hs280/chiBioAnalogue/hardware/baseline-digital/PCB Files/Assembly PCBs/LaserMeasure/LaserMeasureAssembly2.jpg

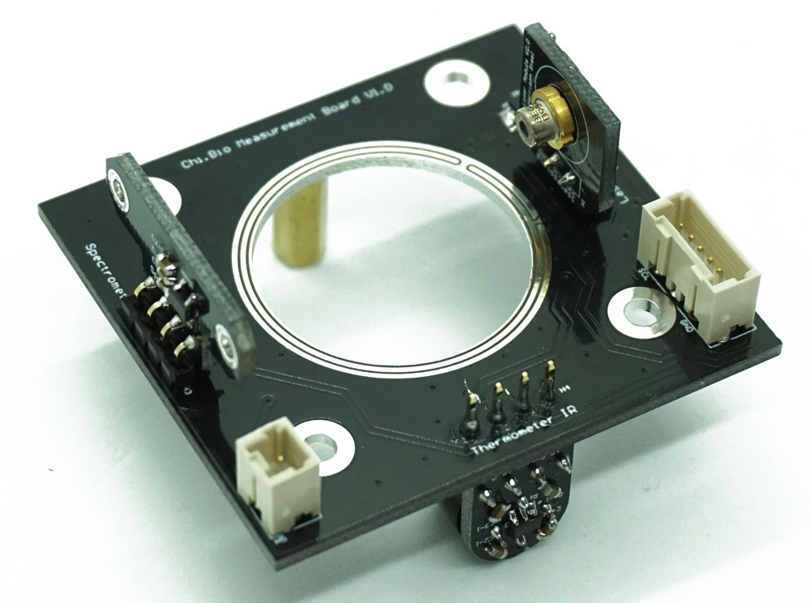
hardware/baseline-digital/PCB Files/Assembly PCBs/LaserMeasure/LaserMeasureAssembly2.jpg
