hs280/chiBioAnalogue/hardware/baseline-digital/PCB Files/Assembly PCBs/Heater3/Heater3Side.jpg

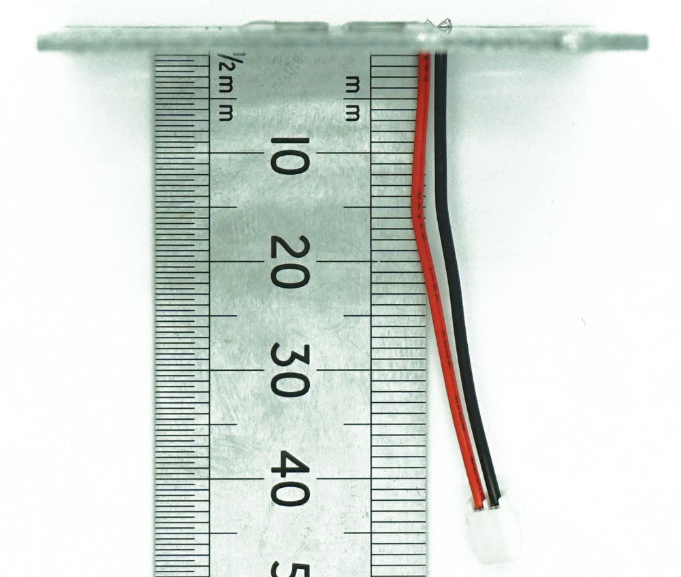
hardware/baseline-digital/PCB Files/Assembly PCBs/Heater3/Heater3Side.jpg
