hs280/chiBioAnalogue/hardware/baseline-digital/PCB Files/Structural PCBs/BraceHorizontal/README.txt

PCB Name: BraceHorizontal
Function: Horizontal brace PCB.
Notes: Central hole must be between 24.7 and 24.9mm in diameter.
Dimensions (max linear, mm): 40 x 40
Layers: 2
Material: FR-4
Copper Thickness (oz): 1
Board Thickness (mm): 1.6
Surface Finish: HASL
Min Track/Spacing (mil): 6/6
Min Hole Size (mm): 0.3
Solder Mask: Black
Silkscreen: White
Assembly Required: No
Board Outline Layer: Mechanical 1
