hs280/chiBioAnalogue/hardware/baseline-digital/PCB Files/Structural PCBs/PumpClamp/README.txt

PCB Name: PumpClamp
Function: Main pump clamp.
Notes: 
Dimensions (max linear, mm): 29.5 x 24
Layers: 2
Material: FR-4
Copper Thickness (oz): 1
Board Thickness (mm): 1.6
Surface Finish: HASL
Min Track/Spacing (mil): 6/6
Min Hole Size (mm): 0.3
Solder Mask: Blue
Silkscreen: White
Assembly Required: No
Board Outline Layer: Mechanical 1
