hs280/chiBioAnalogue/hardware/baseline-digital/PCB Files/Structural PCBs/SensorAperture/README.txt

PCB Name: SensorAperture
Function: Aperture / light blocking PCB for AS7341 sensor.
Notes: 
Dimensions (max linear, mm): 25 x 16
Layers: 2
Material: FR-4
Copper Thickness (oz): 1
Board Thickness (mm): 1.6
Surface Finish: HASL
Min Track/Spacing (mil): 6/6
Min Hole Size (mm): 0.3
Solder Mask: Black
Silkscreen: White
Assembly Required: No
Board Outline Layer: Mechanical 1
