hs280/chiBioAnalogue/hardware/baseline-digital/PCB Files/Structural PCBs/SideA/README.txt

PCB Name: SideAPlain
Function: Structural side panel.
Notes: 
Dimensions (max linear, mm): 51.4 x 115
Layers: 2
Material: FR-4
Copper Thickness (oz): 1
Board Thickness (mm): 1.6
Surface Finish: HASL
Min Track/Spacing (mil): 6/6
Min Hole Size (mm): 0.3
Solder Mask: Black
Silkscreen: White
Assembly Required: No
Board Outline Layer: Mechanical 1
