hs280/chiBioAnalogue/hardware/baseline-digital/PCB Files/Structural PCBs/TubeCap/README.txt

PCB Name: TubeCap
Function: Cap for reaction tube.
Notes: 
Dimensions (max linear, mm): 46 x 46
Layers: 2
Material: FR-4
Copper Thickness (oz): 1
Board Thickness (mm): 1.6
Surface Finish: HASL
Min Track/Spacing (mil): 6/6
Min Hole Size (mm): 0.3
Solder Mask: None
Silkscreen: None
Assembly Required: No
Board Outline Layer: Mechanical 1
