hs280/chiBioAnalogue/hardware/baseline-digital/PCB Files/Structural PCBs/TupeCapMain/README.txt

PCB Name: TubeCapMain
Function: Structure for reaction tube cap.
Notes: 
Dimensions (max linear, mm): 48.2 x 48.2
Layers: 2
Material: FR-4
Copper Thickness (oz): 1
Board Thickness (mm): 1.6
Surface Finish: HASL
Min Track/Spacing (mil): 6/6
Min Hole Size (mm): 0.3
Solder Mask: Black
Silkscreen: None
Assembly Required: No
Board Outline Layer: Mechanical 1
