hs280/chiBioAnalogue/hardware/baseline-digital/PCB List.xlsx

Construct | PCB Name | Quantity | Silkscreen Colour | Solder Mask Colour | PCB Assembly Required
Chi.Bio
 | BasePlate | 1 | White | Black | No
 | BraceHorizontal | 1 | White | Black | No
 | Heater3 | 1 | White | Black | Yes
 | IRSensor | 1 | White | Black | Yes
 | SideA | 1 | White | Black | No
 | SideB | 2 | White | Black | No
 | Side | 1 | White | Black | Yes
 | LaserMeasure | 1 | White | Black | Yes
 | SensorAperture | 1 | None | Black | No
 | SensorBreakoutAS7341 | 1 | White | Black | Yes
 | LaserBreakout | 1 | White | Black | Yes
 | StructHorizontal | 1 | White | Black | Yes
 | TubeCap | 1 | None | None | No
 | TubeCapMain | 1 | None | Black | No
Pump Board
 | Pump | 1 | White | Blue | Yes
 | PumpClamp | 2 | None | Blue | No
 | PumpClampSide | 4 | None | Blue | No
BBB (Control Computer)
 | BeagleBoneBoard | 1 | White | Blue | Yes
