hs280/chiBioAnalogue/hardware/baseline-digital/PCB Files/Structural PCBs/Baseplate/BasePlateBottom.jpg

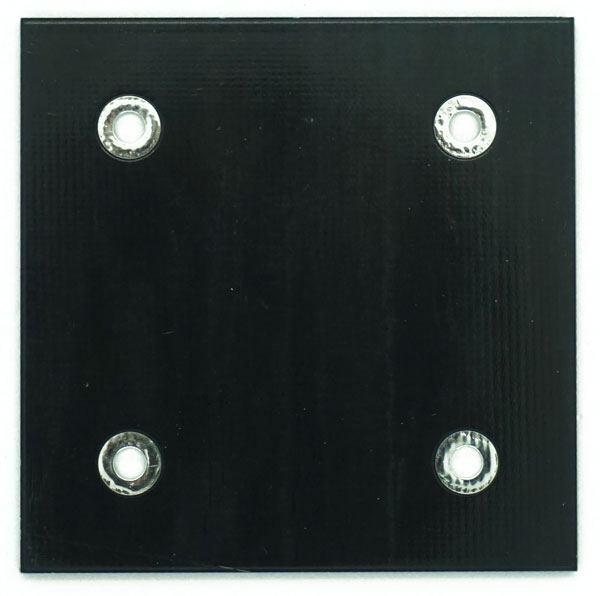
hardware/baseline-digital/PCB Files/Structural PCBs/Baseplate/BasePlateBottom.jpg
