hs280/chiBioAnalogue/hardware/baseline-digital/PCB Files/Structural PCBs/Baseplate/BasePlateTop.jpg

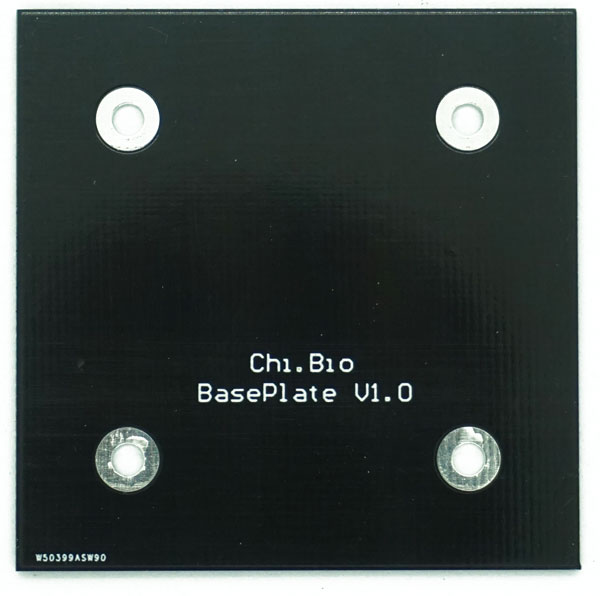
hardware/baseline-digital/PCB Files/Structural PCBs/Baseplate/BasePlateTop.jpg
