hs280/chiBioAnalogue/hardware/baseline-digital/PCB Files/Structural PCBs/BraceHorizontal/BraceHorizontalBottom.jpg

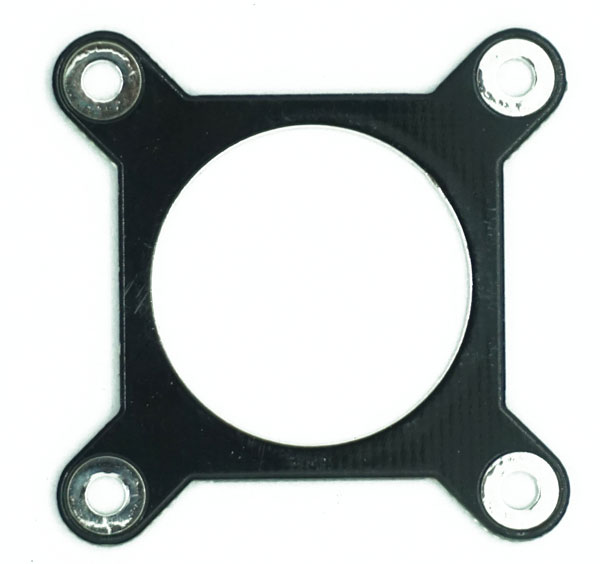
hardware/baseline-digital/PCB Files/Structural PCBs/BraceHorizontal/BraceHorizontalBottom.jpg
