hs280/chiBioAnalogue/hardware/baseline-digital/PCB Files/Structural PCBs/PumpClamp/PumpClampBottom.jpg

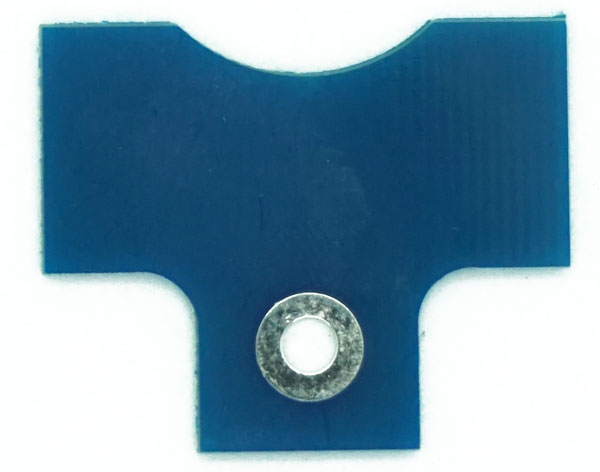
hardware/baseline-digital/PCB Files/Structural PCBs/PumpClamp/PumpClampBottom.jpg
