hs280/chiBioAnalogue/hardware/baseline-digital/PCB Files/Structural PCBs/PumpClamp/PumpClampTop.jpg

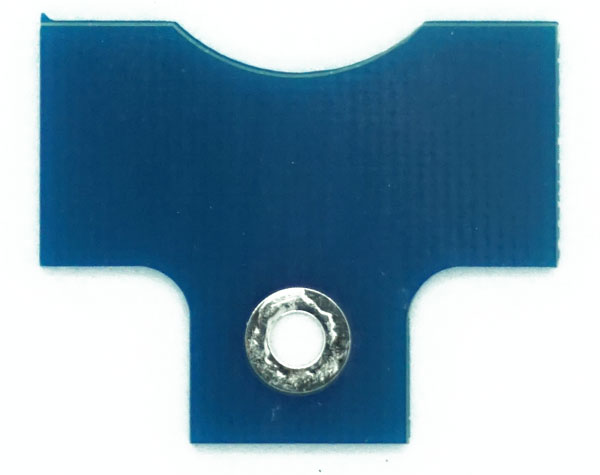
hardware/baseline-digital/PCB Files/Structural PCBs/PumpClamp/PumpClampTop.jpg
