hs280/chiBioAnalogue/hardware/baseline-digital/PCB Files/Structural PCBs/PumpClampSide/PumpClampSideBottom.jpg

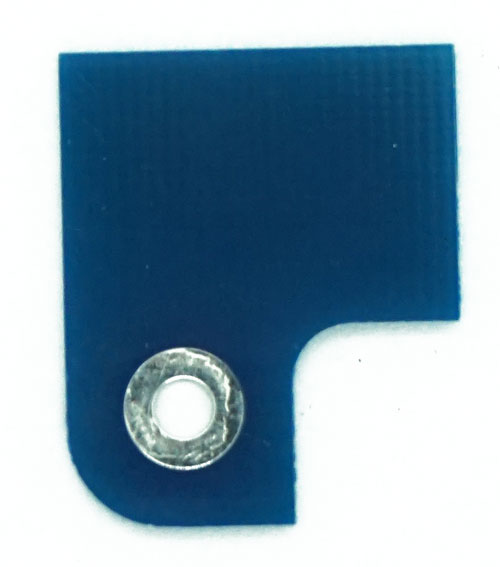
hardware/baseline-digital/PCB Files/Structural PCBs/PumpClampSide/PumpClampSideBottom.jpg
