hs280/chiBioAnalogue/hardware/baseline-digital/PCB Files/Structural PCBs/PumpClampSide/PumpClampSideTop.jpg

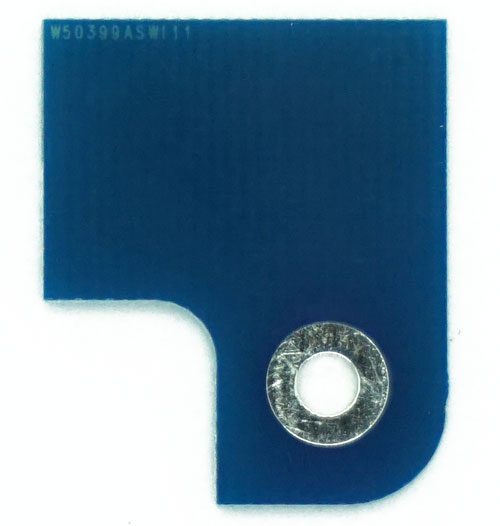
hardware/baseline-digital/PCB Files/Structural PCBs/PumpClampSide/PumpClampSideTop.jpg
