hs280/chiBioAnalogue/hardware/baseline-digital/PCB Files/Structural PCBs/SensorAperture/SensorApertureBottom.jpg

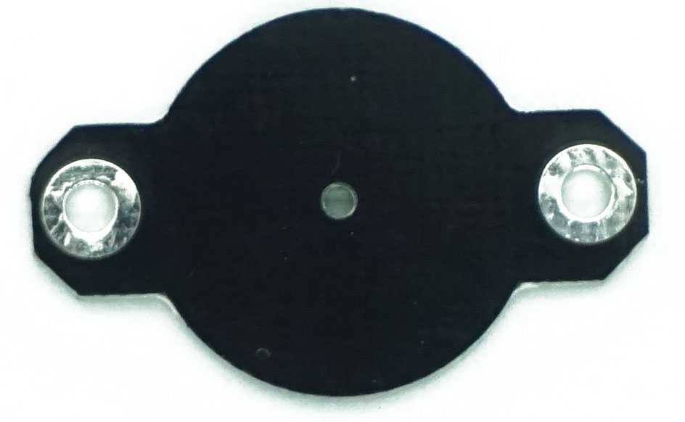
hardware/baseline-digital/PCB Files/Structural PCBs/SensorAperture/SensorApertureBottom.jpg
