hs280/chiBioAnalogue/hardware/baseline-digital/PCB Files/Structural PCBs/SensorAperture/SensorApertureTop.jpg

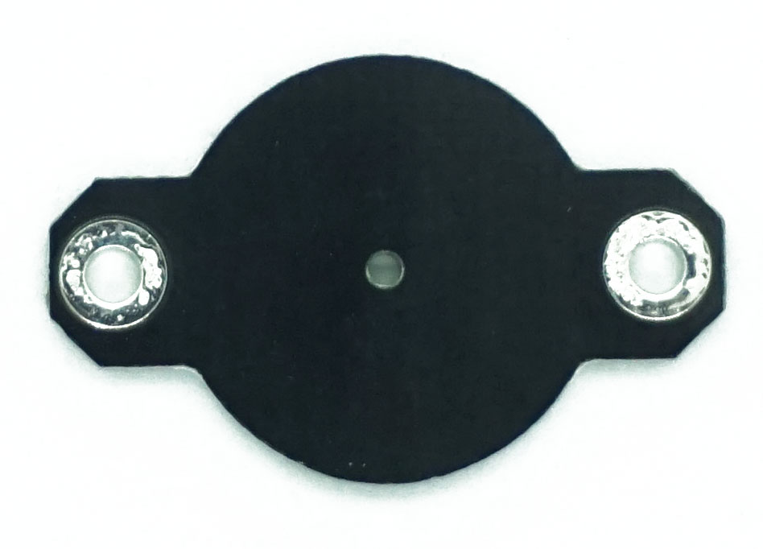
hardware/baseline-digital/PCB Files/Structural PCBs/SensorAperture/SensorApertureTop.jpg
