hs280/chiBioAnalogue/hardware/baseline-digital/PCB Files/Structural PCBs/SideA/SideABottom.jpg

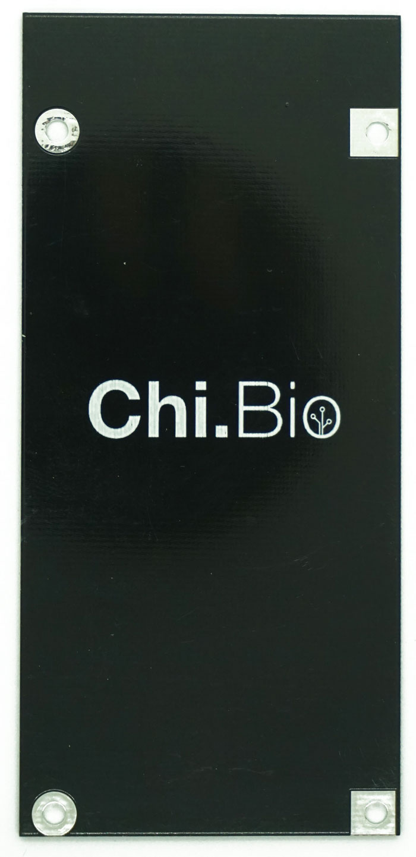
hardware/baseline-digital/PCB Files/Structural PCBs/SideA/SideABottom.jpg
