hs280/chiBioAnalogue/hardware/baseline-digital/PCB Files/Structural PCBs/SideA/SideATop.jpg

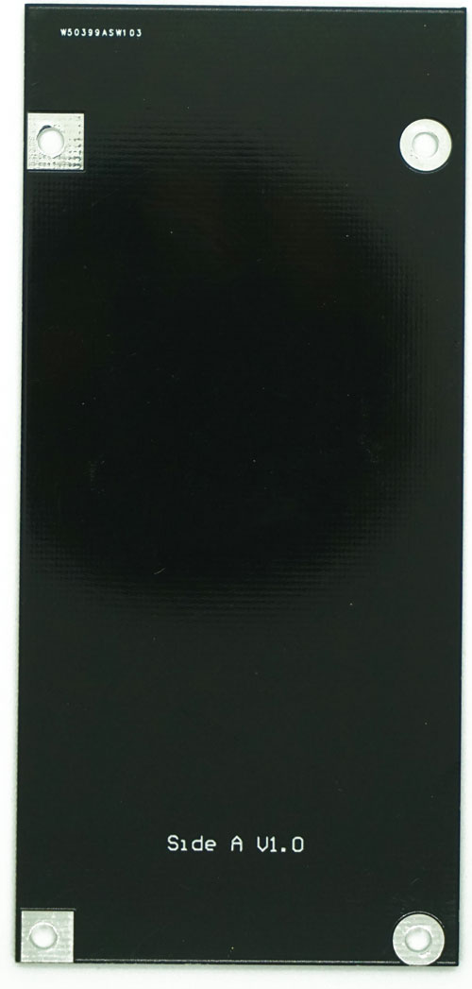
hardware/baseline-digital/PCB Files/Structural PCBs/SideA/SideATop.jpg
