hs280/chiBioAnalogue/hardware/baseline-digital/PCB Files/Structural PCBs/SideB/SideBBottom.jpg

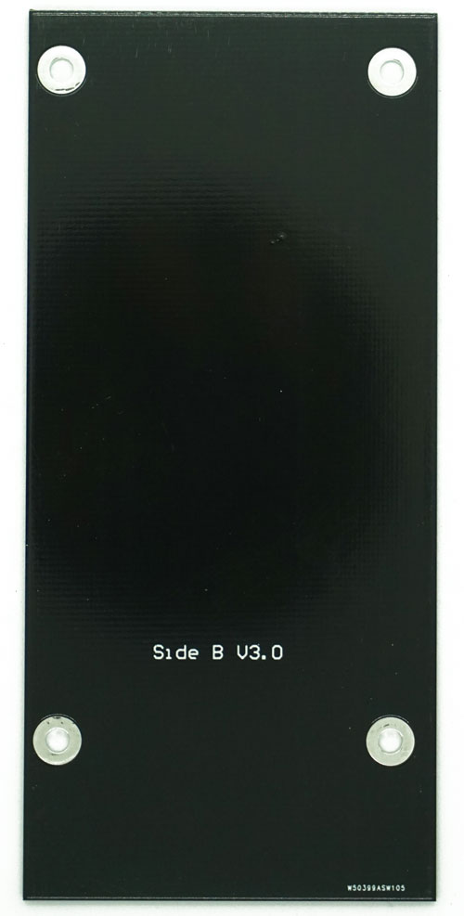
hardware/baseline-digital/PCB Files/Structural PCBs/SideB/SideBBottom.jpg
