hs280/chiBioAnalogue/hardware/baseline-digital/PCB Files/Structural PCBs/SideB/SideBTop.jpg

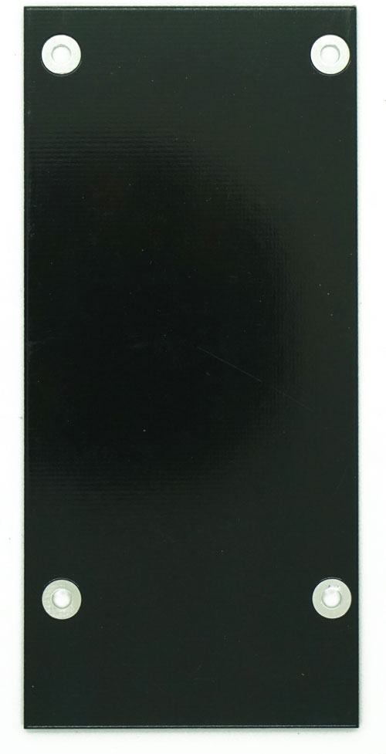
hardware/baseline-digital/PCB Files/Structural PCBs/SideB/SideBTop.jpg
