hs280/chiBioAnalogue/hardware/baseline-digital/PCB Files/Structural PCBs/TubeCap/TubeCapBottom.jpg

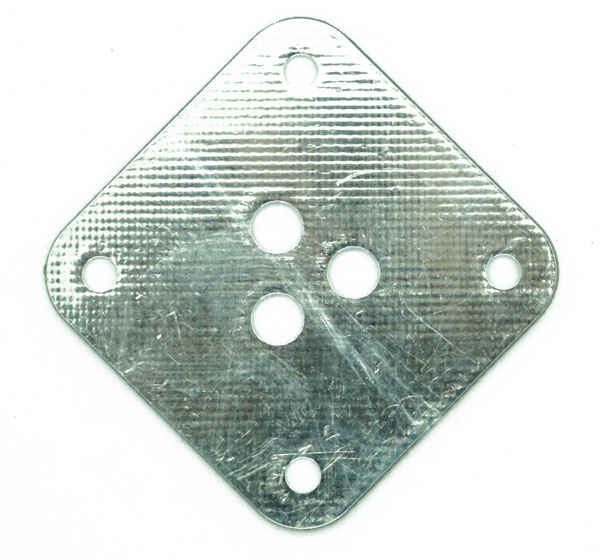
hardware/baseline-digital/PCB Files/Structural PCBs/TubeCap/TubeCapBottom.jpg
