hs280/chiBioAnalogue/hardware/baseline-digital/PCB Files/Structural PCBs/TubeCap/TubeCapTop.jpg

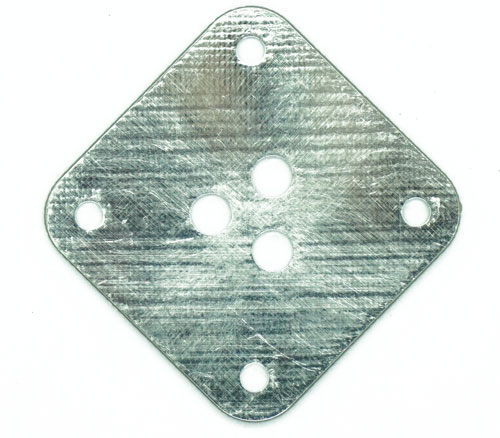
hardware/baseline-digital/PCB Files/Structural PCBs/TubeCap/TubeCapTop.jpg
