hs280/chiBioAnalogue/hardware/baseline-digital/PCB Files/Structural PCBs/TupeCapMain/TubeCapMainBottom.jpg

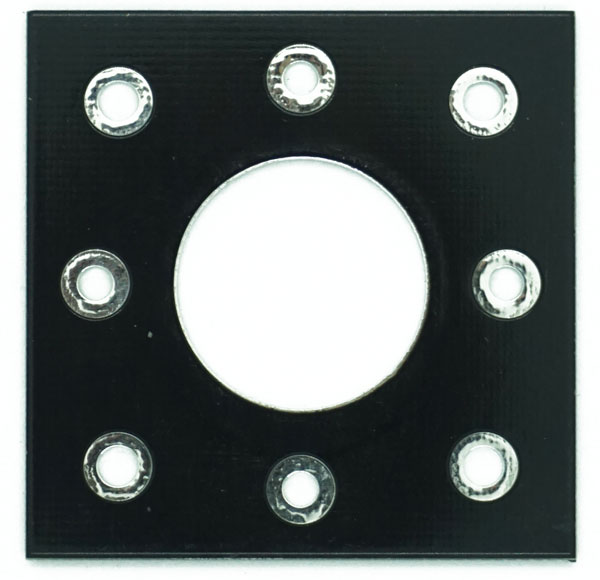
hardware/baseline-digital/PCB Files/Structural PCBs/TupeCapMain/TubeCapMainBottom.jpg
