hs280/chiBioAnalogue/hardware/baseline-digital/PCB Files/Structural PCBs/TupeCapMain/TubeCapMainTop.jpg

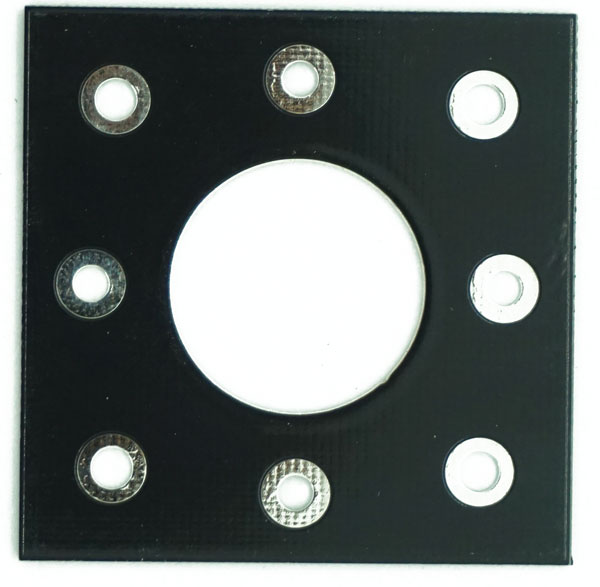
hardware/baseline-digital/PCB Files/Structural PCBs/TupeCapMain/TubeCapMainTop.jpg
