hs280/chiBioAnalogue/hardware/analogue-changes/side_board_bom_delta.csv

Action | Description | Comment | Designator | Qty | Part number | Status
ADD | Octal 12-bit I2C DAC | DAC7578 TSSOP-16, 3.3 V | U-DAC1 | 1 | DAC7578SPW (TI) | VERIFY address table and full-scale; add Digikey number
ADD | Capacitor 0.1uF 0603 | DAC decoupling | C8-1 | 1 | 311-1341-1-ND | Same part as existing 0.1uF
ADD | Capacitor 1uF 0603 | DAC decoupling | C8-2 | 1 | 1276-1019-1-ND | Same part as existing 1uF
REWIRE | LED set-point nets | Move Blue0 Cyan0 Green0 Red0 Yellow0 Lime20 Lime10 and the UV net from PWM1 pins 10 7 11 12 15 17 19 22 to DAC outputs | PWM1 / DAC | 0 | - | No resistor value changes needed
KEEP | PCA9685 (PWM1) | Stays for Stir (pin 6) and Heat (pin 21) | PWM1 | 1 | 568-11925-1-ND | Unchanged
KEEP | All other Side board parts | Unchanged | - | - | - | UV stage is already a CCR with R9 40.2 ohm
