hs280/chiBioAnalogue/hardware/baseline-digital/Additional Materials.xlsx

Sheet: Chi.Bio
Item | Name | Part Number | Quantity | For PCB Assembly? | Source
1 | MicroUSB male-male Cable 50cm | 1778-1019-ND | 2 | No | Digikey
2 | Rubber Feet | 3M156065-ND | 4 | No | Digikey
3 | Fan | P15605-ND | 1 | No | Digikey
4 | Lens | 711-1326-ND | 1 | No | Digikey
5 | Magnet | 469-1061-ND | 2 | No | Digikey
6 | Power Supply (12V 3A) | 1470-3643-ND | 1 | No | Digikey | Alternatives can be used, requirement is 12V 3A supply (36W) minimum.
7 | 2Wire | A100192-ND | 1 | No | Digikey | Used to connect Stirring Fan. Potentially can just add connector to end of fan wire, e.g. Digikey p/n A98653-ND
8 | M3x12mm male-female PCB spacer non-magnetic steel (e.g. A2/A4)/brass |  | 4 | No
9 | M3x10mm male-female PCB spacer |  | 8 | No | https://www.fabory.com/en_GB/spacer-with-internal-thread-and-external-thread-type-h1202-free-cutting-steel-right-zinc-plated-%7c6%7c-m3x10x7/p/11398030010
10 | M3x18mm male-female PCB spacer |  | 4 | No | https://www.fabory.com/en_GB/spacer-with-internal-thread-and-external-thread-type-h1202-free-cutting-steel-right-zinc-plated-%7c6%7c-m3x18x7/p/11398030018
11 | M3x20mm male-female PCB spacer non-magnetic steel (e.g. A2/A4)/brass |  | 4 | No | https://cpc.farnell.com/harwin/r30-3002002/spacers-m3-20mm/dp/PC00102
12 | M3x40mm male-female PCB spacer |  | 4 | No | https://www.fabory.com/en_GB/spacer-with-internal-thread-and-external-threaded-stud-type-h1202-free-cutting-steel-right-zinc-plated-%7c6%7c-m3x40x7/p/11398030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
13 | M3x8mm Screw |  | 4 | No | https://www.fabory.com/en_GB/cross-recessed-raised-cheese-head-screw-phillips-din-7985-h-steel-zinc-plated-black-passivated-4-8-m3x8/p/24810030008
14 | M3x12mm Screw non-magnetic steel (e.g. A2/A4) |  | 4 | No | https://www.fabory.com/en_GB/cross-recessed-raised-cheese-head-screw-pozidriv-din-7985-z-stainless-steel-a2-m3x12/p/51342030012
15 | M3x55mm Screw non-magnetic steel (e.g. A2/A4) |  | 8 | No | https://www.fabory.com/en_GB/cross-recessed-raised-cheese-head-screw-pozidriv-din-7985-z-stainless-steel-a2-m3x55/p/51342030055
16 | M3 Washer non-magnetic steel (e.g. A2/A4)/brass/nylon |  | 8 | No | https://www.fabory.com/en_GB/plain-washer-din-125-1a-stainless-steel-a2-m3/p/51420030001
17 | M3 Nut |  | 12 | No | https://www.fabory.com/en_GB/hexagon-nut-din-934-stainless-steel-a2-right-70-m3/p/51080030001
18 | M2x8mm Screw |  | 2 | No | https://www.fabory.com/en_GB/cross-recessed-raised-cheese-head-screw-pozidriv-din-7985-z-stainless-steel-a4-m2x8/p/55342020008
19 | M2 Nut |  | 4 | No | https://www.fabory.com/en_GB/hexagon-nut-din-934-stainless-steel-a2-right-70-m2/p/51080020001
20 | M2 Washer |  | 2 | No | https://www.fabory.com/en_GB/plain-washer-din-125-1a-steel-140hv-zinc-plated-m2/p/38130020001
21 | M16 Rubber Washer (3mm thickness) | W0214 | 1 | No | http://www.rubberwashers.co.uk/M16_Rubber_Washers

Sheet: Pump Board
Item | Name | Part Number | Quantity | For PCB Assembly? | Source
1 | Pump |  | 4 | No | https://www.aliexpress.com/item/10Pcs-lot-For-Aquarium-Lab-Analytical-Water-6V-DC-DIY-Dosing-pump-Peristaltic-Dosing-Head-Free/32649797935.html
2 | M3x8mm Screw |  | 2 | No | https://www.fabory.com/en_GB/cross-recessed-raised-cheese-head-screw-phillips-din-7985-h-steel-zinc-plated-black-passivated-4-8-m3x8/p/24810030008
3 | M3x50mm male-female PCB spacer |  | 4 | No | https://www.fabory.com/en_GB/spacer-with-internal-thread-and-external-thread-type-h1202-free-cutting-steel-right-zinc-plated-%7c6%7c-m3x50x7/p/11398030050
4 | M3 Nut |  | 6 | No | https://www.fabory.com/en_GB/hexagon-nut-din-934-stainless-steel-a2-right-70-m3/p/51080030001
5 | 2Wire | A100192-ND | 4 | No | Digikey

Sheet: BBB
Item | Name | Part Number | Quantity | For PCB Assembly | Source
1 | Rubber Feet | 36-720-ND | 4 | No | Digikey
2 | Beaglebone Black | BBB01-SC-505-ND | 1 | No | Digikey
3 | M3x25mm Screw |  | 4 | No | https://www.fabory.com/en_GB/slotted-cheese-head-screw-din-84-stainless-steel-a4-m3x25/p/55120030025
4 | M3 Nut |  | 12 | No | https://www.fabory.com/en_GB/hexagon-nut-din-934-stainless-steel-a2-right-70-m3/p/51080030001
