hs280/chiBioAnalogue/hardware/baseline-digital/PCB Files/Assembly PCBs/BBB/BOM/Bill of Materials-BeagleBoneBoard.xlsx

Description | Comment | Designator | Digikey P/N | FP | Quantity
Capacitor | 10 uF | C1-1 | 587-1295-1-ND | 0805 (2012 Metric) | 1
D-Latch | DLatch | DL1 | NC7SZ175P6XCT-ND | 6-TSSOP | 1
I2C Multiplexer | i2cMultiplexer | Mult1 | 296-34905-1-ND | 24-TSSOP | 1
Beaglebone Header | 46PinHeader | P8, P9 | S2012EC-23-ND | 46 Pin Header | 2
Resistor | 10K | R1-1, R1-2, R1-3 | 311-10.0KHRCT-ND | 0603 (1608 Metric) | 3
Resistor | 2.2K | R2-1, R2-2 | 311-2.20KHRCT-ND | 0603 (1608 Metric) | 2
Resistor | 1.5K | R3-1, R3-2, R3-3, R3-4, R3-5, R3-6, R3-7, R3-8, R3-9, R3-10, R3-11, R3-12, R3-13, R3-14, R3-15, R3-16 | 311-1.50KHRCT-ND | 0603 (1608 Metric) | 16
PowerSwitch | Sw1 | Sw1 | 296-34970-1-ND | TSOT-23-6 | 1
MicroUSB Connector | Control Board MicroUSB | T0, T1, T2, T3, T4, T5, T6, T7 | WM10134CT-ND | MicroUSB Female | 8
Thermometer | TempSense | Thermometer | MCP9808T-E/MSCT-ND | 8-MSOP | 1
Watchdog | Watchdog | WD1 | 497-10058-1-ND | SOT-23-5 | 1
