hs280/chiBioAnalogue/hardware/baseline-digital/PCB Files/Assembly PCBs/Heater3/BOM/Bill of Materials-Heater3.xlsx

Description | Comment | Designator | Digikey P/N | FP | Quantity
2 Wire | Interconnect 1 | Heat1 | A100192-ND | Connecting Wire | 1
Resistor | Heat | R1-1, R1-2, R1-3, R1-4 | A130709CT-ND | 2512 (6432 Metric) | 4
