hs280/chiBioAnalogue/hardware/baseline-digital/PCB Files/Assembly PCBs/IRSensor/BOM/Bill of Materials-IRSensor.xlsx

Description | Comment | Designator | Digikey P/N | FP | Quantity
Capacitor | 1uF | C1-1 | 1276-1019-1-ND | 0603 (1608 Metric) | 1
Capacitor | 4.7uF | C2-1 | 1276-1044-1-ND | 0603 (1608 Metric) | 1
Capacitor | 0.01uF | C3-1 | 445-5662-1-ND | 0603 (1608 Metric) | 1
Capacitor | 0.1 uF | C4-1 | 311-1341-1-ND | 0603 (1608 Metric) | 1
Header Pins | IRConnect | H1 | 732-5337-ND | 4-Header Pins | 1
IR Thermometer | IR1 | IR1 | MLX90614ESF-DCC-000-TU-ND | TO-39 | 1
3 Regulator | 3V Regulator | Reg1 | LP2985AIM5-3.0/NOPBCT-ND | SOT-23-5 | 1
