hs280/chiBioAnalogue/hardware/baseline-digital/PCB Files/Assembly PCBs/LaserBreakout/BOM/Bill of Materials-LaserBreakout.xlsx

Description | Comment | Designator | Digikey P/N | FP | Quantity
Capacitor | 1nf | C1 | 478-1215-1-ND | 0603 (1608 Metric) | 1
Header Pins | LightConnect | H1 | 732-5338-ND | 3-Header Pins | 1
ADL65052TL | LaserLEDCombo | L1 |  | TO-18 | 1
OpAmp | Op Amp - Precision | OA1 | 296-45326-1-ND | SOT-23-5 | 1
Resistor | 10K | R1-1 | 311-10.0KHRCT-ND | 0603 (1608 Metric) | 1
Resistor | 51 | R2-1 | RHM51.0ADCT-ND | 0603 (1608 Metric) | 1
Resistor | 20K | R3-1 | 311-20.0KHRCT-ND | 0603 (1608 Metric) | 1
Resistor | 2M | R4-1 | 311-2.00MHRCT-ND | 0603 (1608 Metric) | 1
Transistor | TransistorPower | TR1 | MMBT4401LT1GOSCT-ND | SOT-23-3 | 1
