hs280/chiBioAnalogue/hardware/baseline-digital/PCB Files/Assembly PCBs/LaserMeasure/BOM/Bill of Materials-Laser Measure.xlsx

Description | Comment | Designator | Digikey P/N | FP | Quantity
Capacitor | 1uF | C1-1 | 1276-1019-1-ND | 0603 (1608 Metric) | 1
Capacitor | 4.7uF | C2-1 | 1276-1044-1-ND | 0603 (1608 Metric) | 1
Capacitor | 0.01uF | C3-1 | 445-5662-1-ND | 0603 (1608 Metric) | 1
DAC | Dac | DAC1 | 296-48525-1-ND | SOT-23-6 | 1
Side Connector | Interconnect | H1 | A98685-ND | Mini CT 6POS | 1
Laser Beakout | LaserBreakout | H2 |  |  | 1
Spectrometer Breakout | SensorBreakoutAS7341 | H3 |  |  | 1
IR Thermometer Breakout | IRSensor | H4 |  |  | 1
Overflow Connector | OverFlow1 | H5 | A98681-ND | Mini CT 2POS | 1
Resistor | 10k | R1-1 | 311-10.0KHRCT-ND | 0603 (1608 Metric) | 1
5V Regulator | 5V Regulator | Reg1 | LP2985IM5X-5.0/NOPBCT-ND | SOT-23-5 | 1
Thermometer | TempSense | T1 | MCP9808T-E/MSCT-ND | 8-MSOP | 1
