hs280/chiBioAnalogue/hardware/baseline-digital/PCB Files/Assembly PCBs/Pump/BOM/Bill of Materials-Pump.xlsx

Description | Comment | Designator | Digikey P/N | FP | Quantity
Capacitor | 2.2 uF | C1-1, C1-2 | 1276-6458-1-ND | 0805 (2012 Metric) | 2
Capacitor | 22 uF | C2-1, C2-2 | 1276-6780-1-ND | 0805 (2012 Metric) | 2
Capacitor | 0.1 uF | C3-1, C3-2 | 311-1341-1-ND | 0603 (1608 Metric) | 2
Capacitor | 1uF | C4-1 | 1276-1019-1-ND | 0603 (1608 Metric) | 1
Capacitor | 4.7uF | C5-1 | 1276-1044-1-ND | 0603 (1608 Metric) | 1
Capacitor | 0.01uF | C6-1 | 445-5662-1-ND | 0603 (1608 Metric) | 1
MicroUSB Connector | MicroUSB Side | H1 | 609-4618-1-ND | MicroUSB Side | 1
2 Position Connector | Interconnect 2 | H2, H3, H4, H5 | A98681-ND | Mini CT 2POS | 4
Motor Driver | MotorDriver2 | MD1-1, MD1-2 | 296-38514-5-ND | 16-HTSSOP | 2
Pump Assembly | PO1 | PO1, PO2, PO3, PO4 |  |  | 4
PWM | PWM28 | PWM1 | 568-11925-1-ND | 28-TSSOP | 1
Resistor | 10k | R1-1, R1-2 | 311-10.0KHRCT-ND | 0603 (1608 Metric) | 2
3.3V Regulator | 3.3V Regulator | Reg1 | 296-18476-1-ND | SOT-23-5 | 1
