hs280/chiBioAnalogue/hardware/baseline-digital/PCB Files/Assembly PCBs/SensorBreakoutAS7341/BOM/Bill of Materials-SensorBreakoutAS7341.xlsx

Description | Comment | Designator | Digikey P/N | FP | Quantity
Spectrometer | AS7341 | AS7341 | AS7341-DLGMCT-ND | 8-TFLGA | 1
Capacitor | 1uF | C1-1 | 1276-1019-1-ND | 0603 (1608 Metric) | 1
Capacitor | 4.7uF | C2-1 | 1276-1044-1-ND | 0603 (1608 Metric) | 1
Capacitor | 0.01uF | C3-1 | 445-5662-1-ND | 0603 (1608 Metric) | 1
Header Pins | ColourConnect2 | H1 | 732-5337-ND | 4-Header Pins | 1
1.8V Regulator | 1.8V Regulator | Reg1 | LP2985AIM5-1.8/NOPBCT-ND | SOT-23-5 | 1
