hs280/chiBioAnalogue/hardware/baseline-digital/PCB Files/Assembly PCBs/Side/BOM/Bill of Materials-Side.xlsx

Description | Comment | Designator | Digikey P/N | FP | Quantity
Buffer | B1 | B1 | 296-47829-1-ND | VSSOP-8 | 1
Capacitor | 1 uF | C1-1, C1-2 | 1276-1019-1-ND | 0603 (1608 Metric) | 2
Capacitor | 10 uF | C2-1, C2-2 | 587-1295-1-ND | 0805 (2012 Metric) | 2
Capacitor | 22 uF | C3-1, C3-2 | 1276-6780-1-ND | 0805 (2012 Metric) | 2
Capacitor | 0.1 uF | C4-1, C4-2, C4-3, C4-4 | 311-1341-1-ND | 0603 (1608 Metric) | 4
Capacitor | 4.7uF | C5-1 | 1276-1044-1-ND | 0603 (1608 Metric) | 1
Capacitor | 0.01uF | C6-1, C6-2 | 445-5662-1-ND | 0603 (1608 Metric) | 2
Capacitor C0G,NP0 | 22pF | C7-1 | 311-1755-1-ND | 0603 (1608 Metric) | 1
Diode | D1 | D1-1 | 1655-1928-1-ND | SOD-123 | 1
Power Connector | Power (12V 3A) | H1 | CP-044AH-ND | PWR Jack | 1
MicroUSB Connector | Control | H2 | WM10134CT-ND | MicroUSB Female | 1
2 Position Connector | Heat | H3 | A98681-ND | Mini CT 2POS | 1
2 Position Connector | Stir | H4 | A98681-ND | Mini CT 2POS | 1
MicroUSB Connector | Pump | H5 | WM10134CT-ND | MicroUSB Female | 1
6 Wire | Measurement | H6 | A100196-ND | Connecting Wire | 1
5 Position Connector | Expansion | H7 | A98684-ND | Mini CT 5POS | 1
Inductor | 3.3uH | I1-1 | 445-4119-1-ND | Wirewound Inductor | 1
LED Visible | LEDEngin | LED1 | 1537-1183-1-ND | 2828 (7070 Metric) | 1
LED UV | LED UV | LED2 | 1807-1023-2-ND | XR SMD | 1
OpAmp | OpAmp 4Way | OA1-1, OA1-2 | AD8534ARZ-REELCT-ND | 14-SOIC | 2
PWM | PWM28 | PWM1 | 568-11925-1-ND | 28-TSSOP | 1
Resistor | 10k | R1-4, R1-5, R1-6, R1-7, R1-8, R1-9, R1-10, R1-11, R1-12, R1-13, R1-14, R1-15, R1-16, R1-17, R1-18, R1-19, R1-20, R1-21, R1-22, R1-23 | 311-10.0KHRCT-ND | 0603 (1608 Metric) | 20
Resistor | 38.3k | R2-1, R2-2, R2-3, R2-4, R2-5, R2-6, R2-7, R2-8, R2-9 | 311-38.3KHRCT-ND | 0603 (1608 Metric) | 9
Resistor | 1 | R3-1, R3-2, R3-3, R3-4, R3-5, R3-6, R3-7 | A109718CT-ND | 2512 (6432 Metric) | 7
Resistor | 1M | R4-1, R4-2, R4-3, R4-4, R4-5, R4-6, R4-7, R4-8 | RMCF0603FG1M00CT-ND | 0603 (1608 Metric) | 8
Resistor | 4.99 | R5-1, R5-2 | 311-4.99HRCT-ND | 0603 (1608 Metric) | 2
Resistor | 152k | R6-1 | 311-2096-1-ND | 0603 (1608 Metric) | 1
Resistor | 22.1k | R7-1 | 311-2486-1-ND | 0603 (1608 Metric) | 1
Resistor | 40.2 | R9-1 | P16072CT-ND | 0805 (2012 Metric) | 1
3.3V Regulator | 3.3V Regulator | Reg1 | 296-18476-1-ND | SOT-23-5 | 1
6V Regulator | 6V Regulator | Reg2 | 296-30033-1-ND | 8-SOIC | 1
Transistor | MOSFET | TR1-1, TR1-2 | 785-1014-1-ND | SOT-23-3 | 2
Transistor | TransistorPower2 | TR2-1, TR2-2, TR2-3, TR2-4, TR2-5, TR2-6, TR2-7, TR2-8 | ZXTN25100DGCT-ND | SOT-223 | 8
