hs280/chiBioAnalogue/hardware/baseline-digital/PCB Files/Assembly PCBs/StructHorizontal/BOM/Bill of Materials-StructHorizontal.xlsx

Description | Comment | Designator | Digikey P/N | FP | Quantity
2 Wire | Interconnect 1 | Overflow | A100192-ND | Connecting Wire | 1
