hs280/chiBioAnalogue/hardware/baseline-digital/PCB Files/Assembly PCBs/BBB/README.txt

PCB Name: BeagleBoneBoard
Function: Cape which attaches to a Beaglebone Black control computers to multiplex Chi.Bio
Notes: Some resistor names/values have been updated since images of this PCB were taken.
Dimensions (max linear, mm): 86.8 x 55.0
Layers: 2
Material: FR-4
Copper Thickness (oz): 1
Board Thickness (mm): 1.6
Surface Finish: HASL
Min Track/Spacing (mil): 6/6
Min Hole Size (mm): 0.3
Solder Mask: Blue
Silkscreen: White
Assembly Required: Yes
Board Outline Layer: Mechanical 1
