hs280/chiBioAnalogue/hardware/baseline-digital/PCB Files/Assembly PCBs/Heater3/README.txt

PCB Name: Heater3
Function: Heat plate.
Notes: 
Dimensions (max linear, mm): 49.8 x 49.8
Layers: 2
Material: FR-4
Copper Thickness (oz): 1
Board Thickness (mm): 1.6
Surface Finish: HASL
Min Track/Spacing (mil): 6/6
Min Hole Size (mm): 0.3
Solder Mask: Black
Silkscreen: White
Assembly Required: Yes
Board Outline Layer: Mechanical 1
