hs280/chiBioAnalogue/hardware/baseline-digital/PCB Files/Assembly PCBs/IRSensor/README.txt

PCB Name: IRSensor
Function: Infra-red temperature sensor.
Notes: 
Dimensions (max linear, mm): 10.2 x 13.8
Layers: 2
Material: FR-4
Copper Thickness (oz): 1
Board Thickness (mm): 1.6
Surface Finish: HASL
Min Track/Spacing (mil): 6/6
Min Hole Size (mm): 0.3
Solder Mask: Black
Silkscreen: White
Assembly Required: Yes
Board Outline Layer: Mechanical 1
