hs280/chiBioAnalogue/hardware/baseline-digital/PCB Files/Assembly PCBs/LaserBreakout/README.txt

PCB Name: LaserBreakout
Function: Laser diode with optical power regulation driving circuitry.
Notes: 
Dimensions (max linear, mm): 14 x 13.5
Layers: 2
Material: FR-4
Copper Thickness (oz): 1
Board Thickness (mm): 1.6
Surface Finish: HASL
Min Track/Spacing (mil): 6/6
Min Hole Size (mm): 0.3
Solder Mask: Black
Silkscreen: White
Assembly Required: Yes
Board Outline Layer: Mechanical 1
