hs280/chiBioAnalogue/hardware/baseline-digital/PCB Files/Assembly PCBs/Pump/README.txt

PCB Name: Pump
Function: Pump control board, which drives up to 4 peristaltic pumps.
Notes: 
Dimensions (max linear, mm): 150.5 x 100
Layers: 2
Material: FR-4
Copper Thickness (oz): 1
Board Thickness (mm): 1.6
Surface Finish: HASL
Min Track/Spacing (mil): 6/6
Min Hole Size (mm): 0.3
Solder Mask: Blue
Silkscreen: White
Assembly Required: Yes
Board Outline Layer: Mechanical 1
