hs280/chiBioAnalogue/hardware/baseline-digital/PCB Files/Assembly PCBs/SensorBreakoutAS7341/README.txt

PCB Name: SensorBreakoutAS7341
Function: AS7341 chip spectrometer and voltage regulator.
Notes: 
Dimensions (max linear, mm): 25 x 12.5
Layers: 2
Material: FR-4
Copper Thickness (oz): 1
Board Thickness (mm): 1.6
Surface Finish: HASL
Min Track/Spacing (mil): 6/6
Min Hole Size (mm): 0.3
Solder Mask: Black
Silkscreen: White
Assembly Required: Yes
Board Outline Layer: Mechanical 1
