hs280/chiBioAnalogue/hardware/baseline-digital/PCB Files/Assembly PCBs/BBB/BeagleBoneBoardAssembly1.jpg

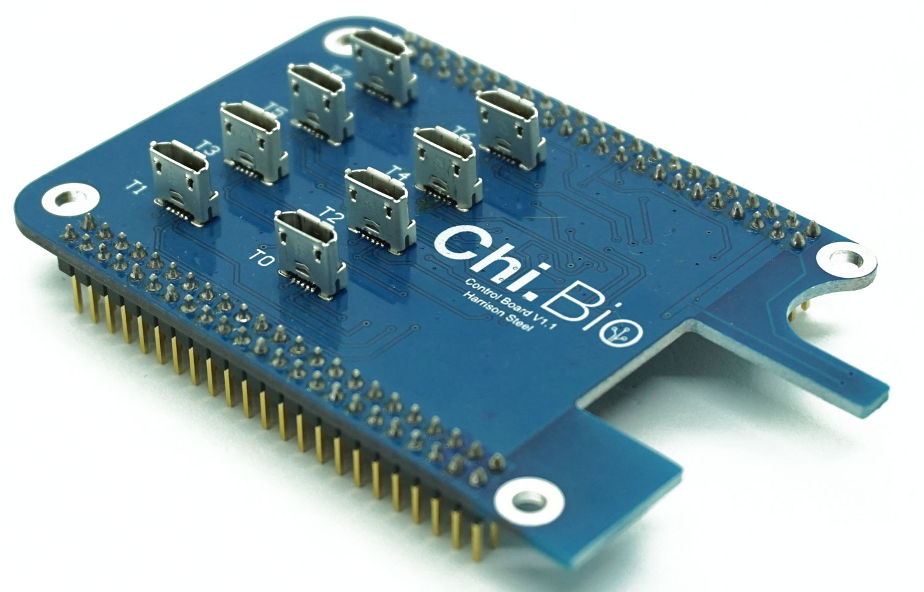
hardware/baseline-digital/PCB Files/Assembly PCBs/BBB/BeagleBoneBoardAssembly1.jpg
