hs280/chiBioAnalogue/hardware/baseline-digital/PCB Files/Assembly PCBs/BBB/BeagleBoneBoardBottom.jpg

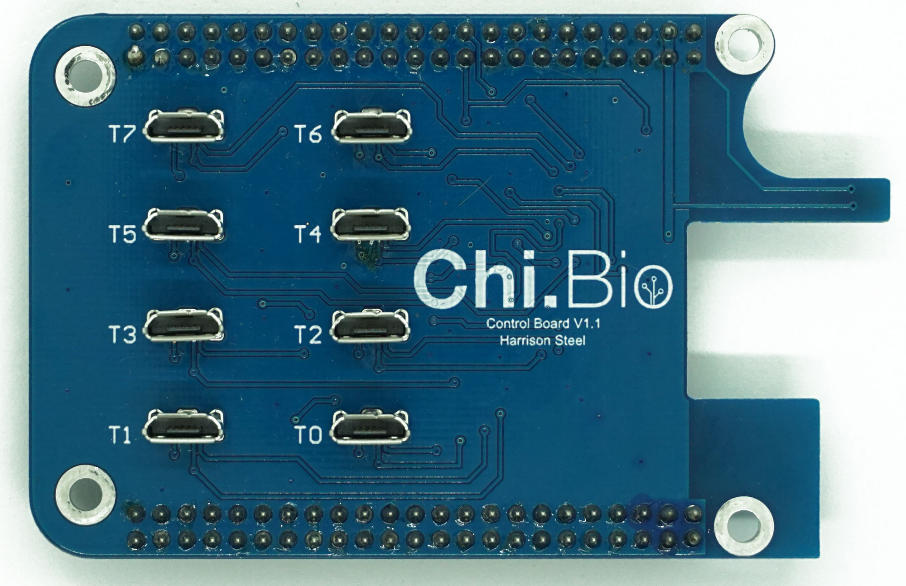
hardware/baseline-digital/PCB Files/Assembly PCBs/BBB/BeagleBoneBoardBottom.jpg
