hs280/chiBioAnalogue/hardware/baseline-digital/PCB Files/Assembly PCBs/BBB/BeagleBoneBoardTop.jpg

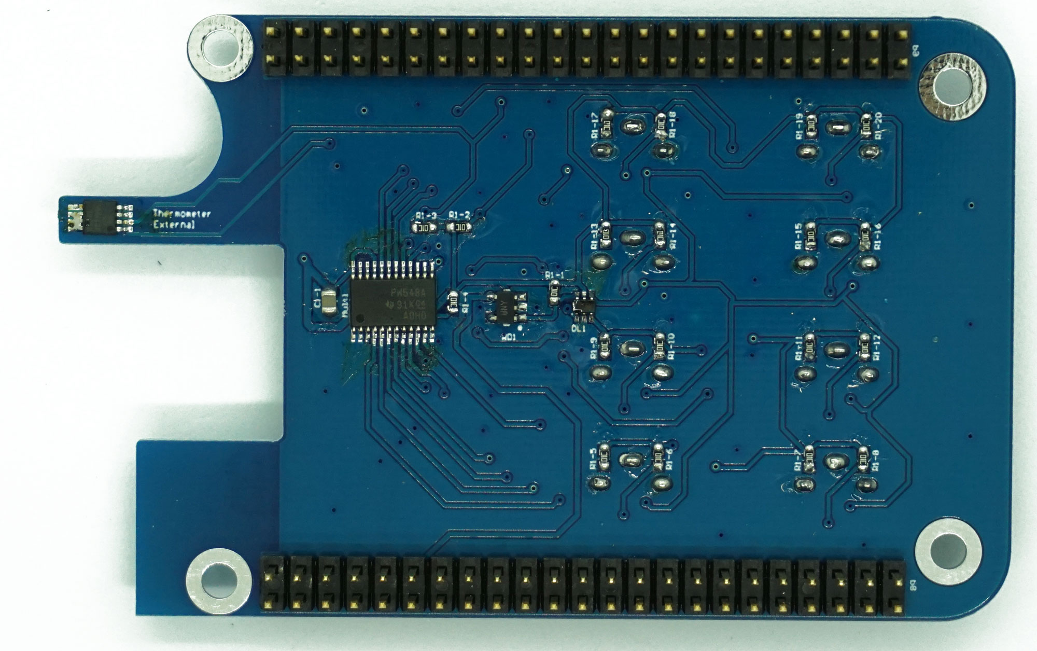
hardware/baseline-digital/PCB Files/Assembly PCBs/BBB/BeagleBoneBoardTop.jpg
