hs280/chiBioAnalogue/hardware/baseline-digital/PCB Files/Assembly PCBs/Heater3/Heater3Bottom.jpg

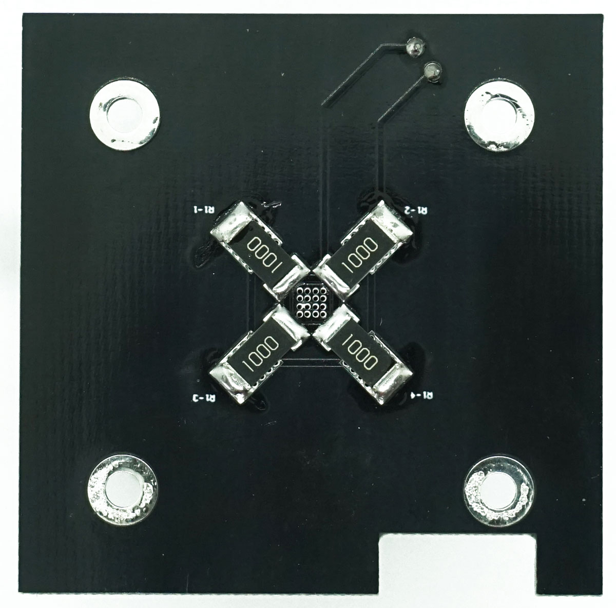
hardware/baseline-digital/PCB Files/Assembly PCBs/Heater3/Heater3Bottom.jpg
