hs280/chiBioAnalogue/hardware/baseline-digital/PCB Files/Assembly PCBs/Heater3/Heater3Top.jpg

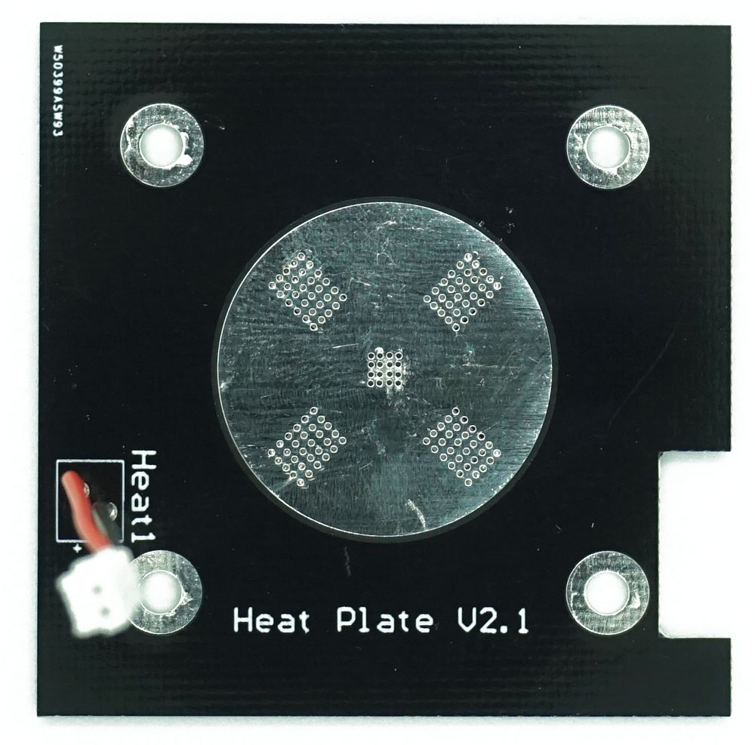
hardware/baseline-digital/PCB Files/Assembly PCBs/Heater3/Heater3Top.jpg
