hs280/chiBioAnalogue/hardware/baseline-digital/PCB Files/Assembly PCBs/IRSensor/IRSensorBottom.jpg

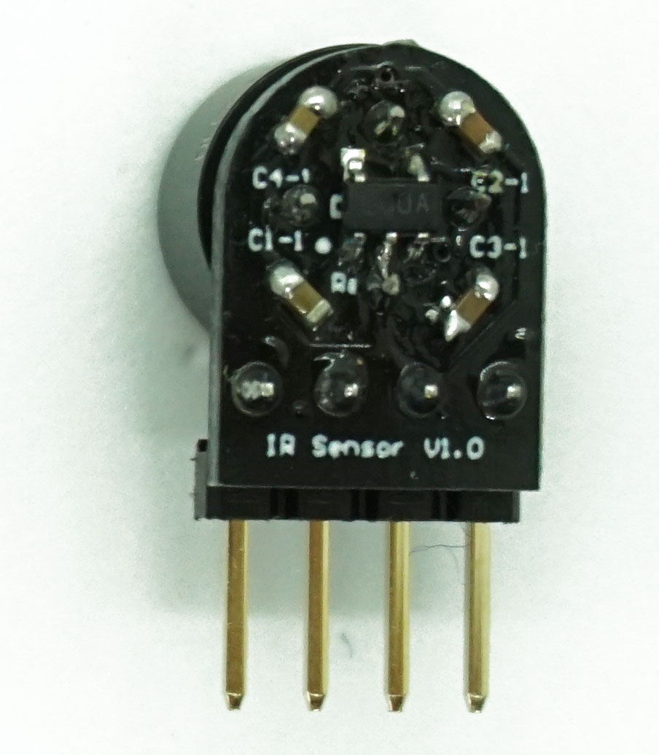
hardware/baseline-digital/PCB Files/Assembly PCBs/IRSensor/IRSensorBottom.jpg
