hs280/chiBioAnalogue/hardware/baseline-digital/PCB Files/Assembly PCBs/IRSensor/IRSensorSide.jpg

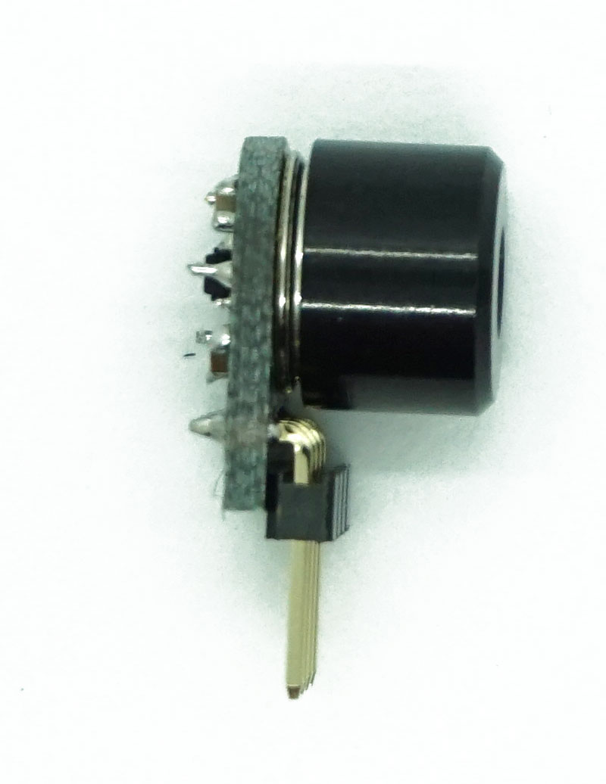
hardware/baseline-digital/PCB Files/Assembly PCBs/IRSensor/IRSensorSide.jpg
