hs280/chiBioAnalogue/hardware/baseline-digital/PCB Files/Assembly PCBs/IRSensor/IRSensorTop2.jpg

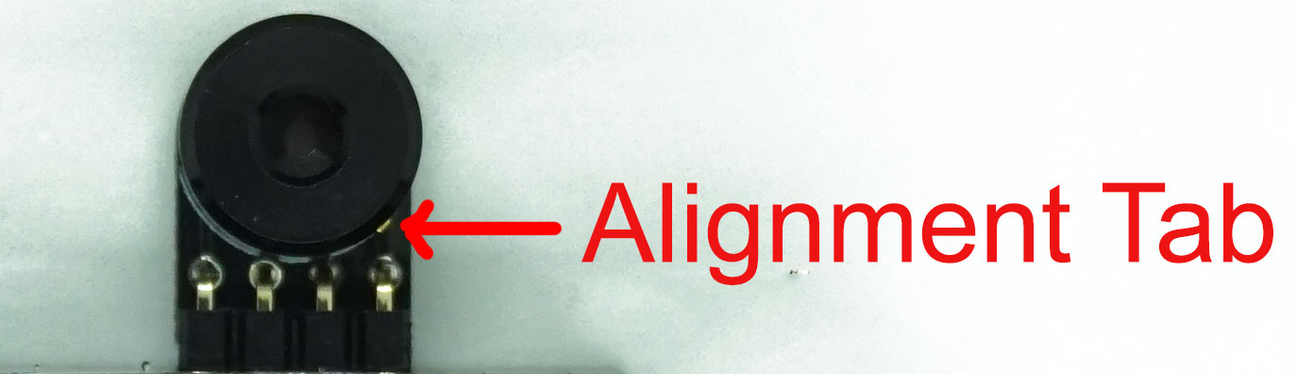
hardware/baseline-digital/PCB Files/Assembly PCBs/IRSensor/IRSensorTop2.jpg
