hs280/chiBioAnalogue/hardware/baseline-digital/PCB Files/Assembly PCBs/IRSensor/IRSensorTop.jpg

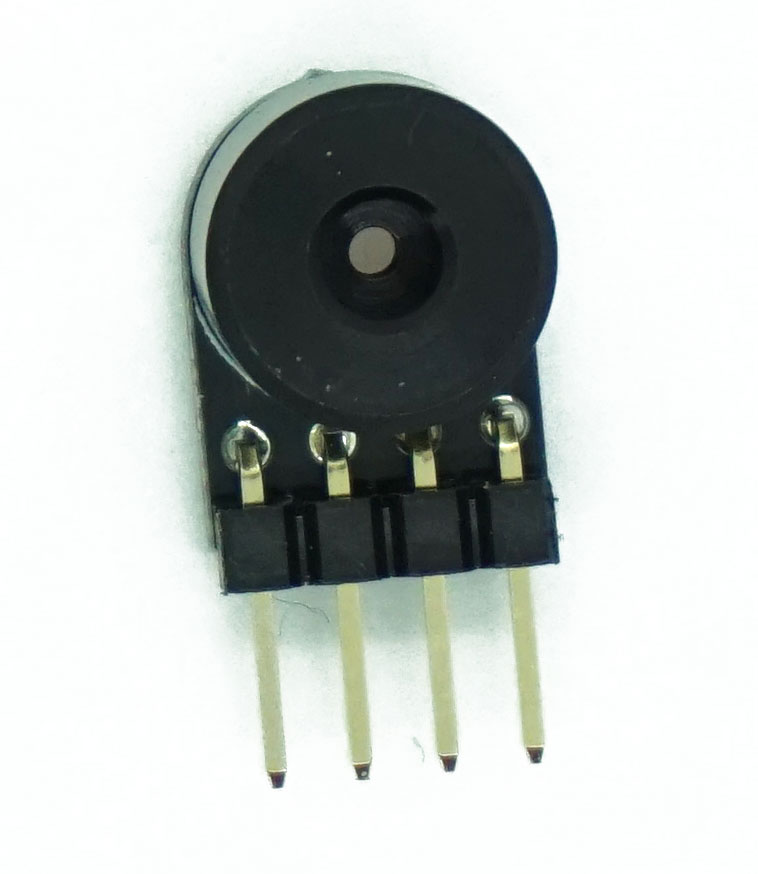
hardware/baseline-digital/PCB Files/Assembly PCBs/IRSensor/IRSensorTop.jpg
