hs280/chiBioAnalogue/hardware/baseline-digital/PCB Files/Assembly PCBs/LaserBreakout/LaserBreakoutBottom.jpg

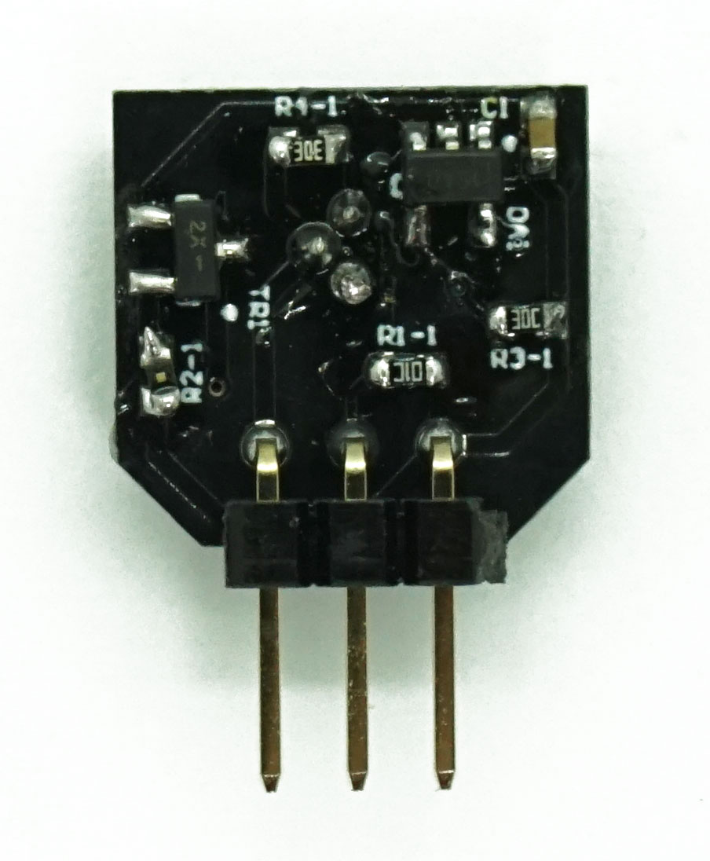
hardware/baseline-digital/PCB Files/Assembly PCBs/LaserBreakout/LaserBreakoutBottom.jpg
