hs280/chiBioAnalogue/hardware/baseline-digital/PCB Files/Assembly PCBs/LaserBreakout/LaserBreakoutSide.jpg

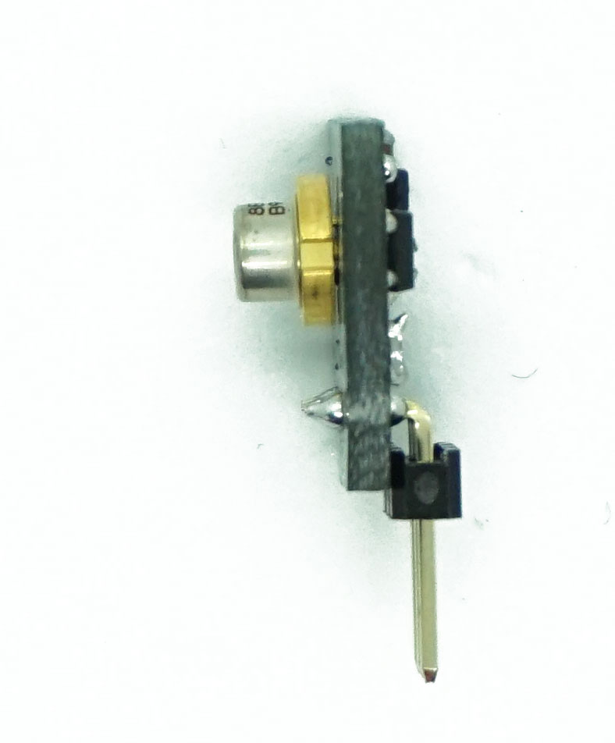
hardware/baseline-digital/PCB Files/Assembly PCBs/LaserBreakout/LaserBreakoutSide.jpg
