hs280/chiBioAnalogue/hardware/baseline-digital/PCB Files/Assembly PCBs/LaserBreakout/LaserBreakoutTop.jpg

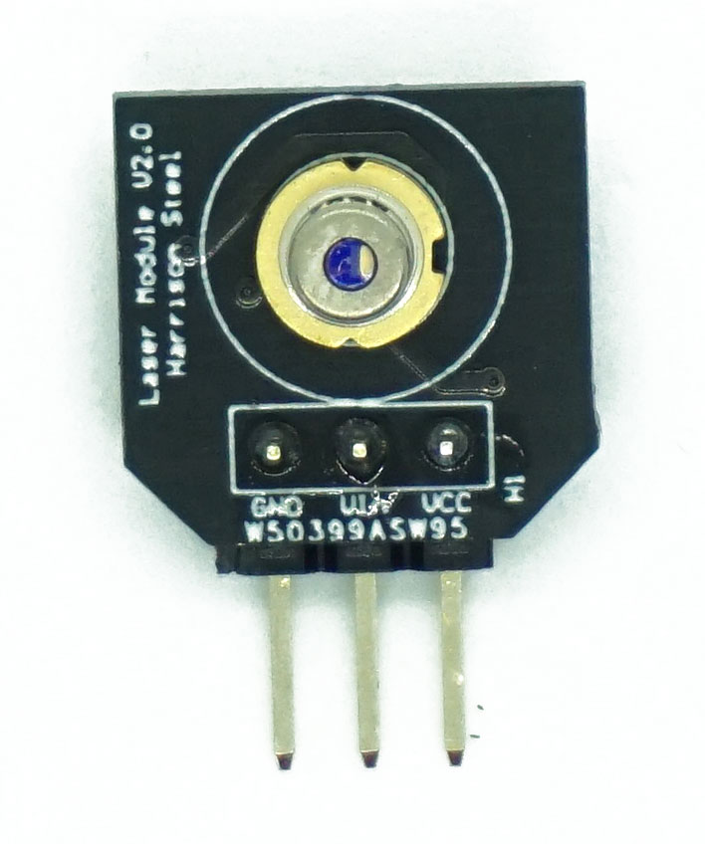
hardware/baseline-digital/PCB Files/Assembly PCBs/LaserBreakout/LaserBreakoutTop.jpg
