hs280/chiBioAnalogue/hardware/baseline-digital/PCB Files/Assembly PCBs/LaserMeasure/LaserMeasureAssembly4.jpg

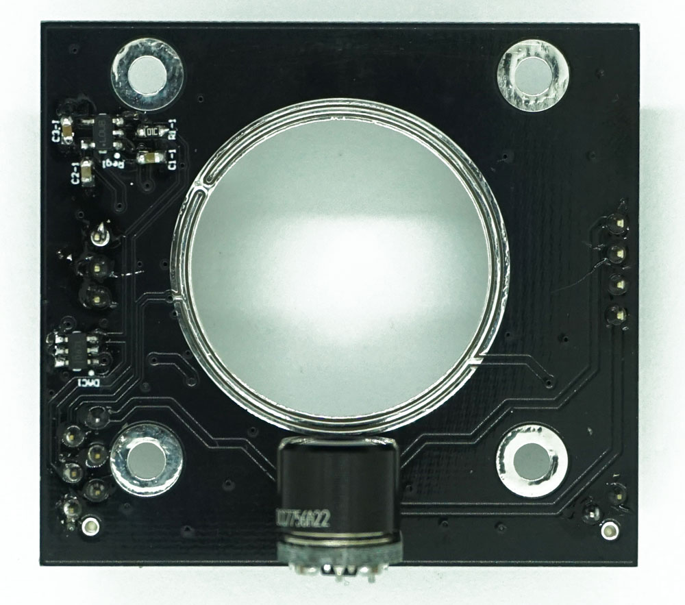
hardware/baseline-digital/PCB Files/Assembly PCBs/LaserMeasure/LaserMeasureAssembly4.jpg
