hs280/chiBioAnalogue/hardware/baseline-digital/PCB Files/Assembly PCBs/Pump/PumpBottom.jpg

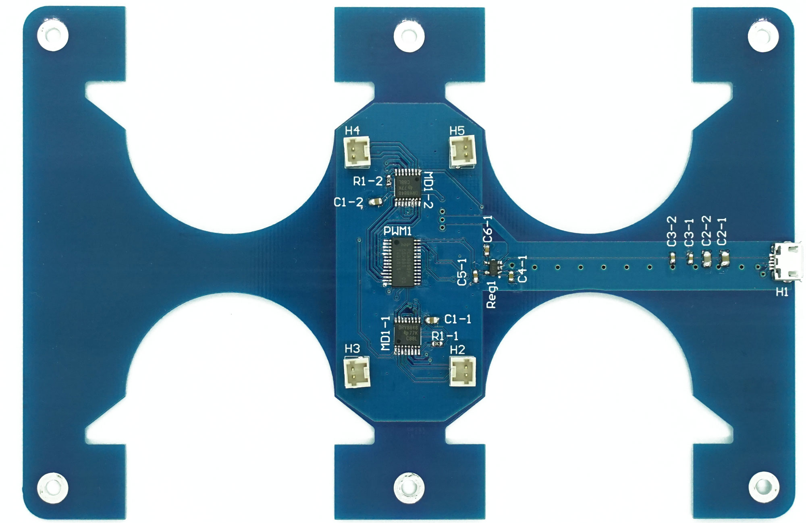
hardware/baseline-digital/PCB Files/Assembly PCBs/Pump/PumpBottom.jpg
