hs280/chiBioAnalogue/hardware/baseline-digital/PCB Files/Assembly PCBs/SensorBreakoutAS7341/SensorBreakoutAS7341Bottom.jpg

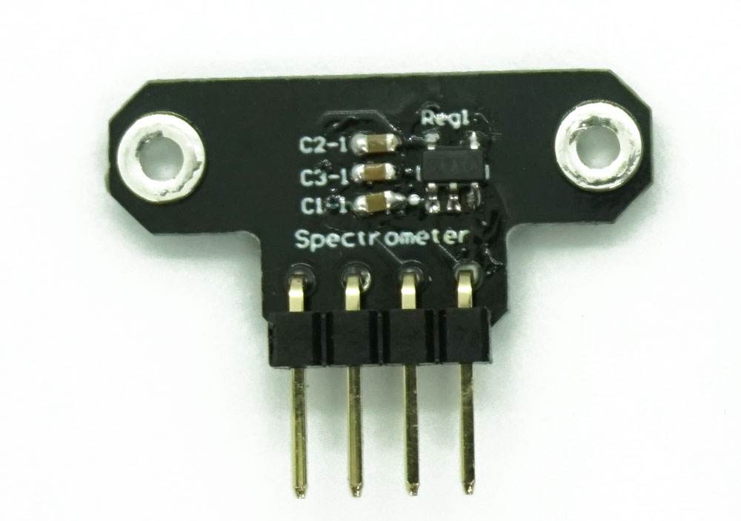
hardware/baseline-digital/PCB Files/Assembly PCBs/SensorBreakoutAS7341/SensorBreakoutAS7341Bottom.jpg
