hs280/chiBioAnalogue/hardware/baseline-digital/PCB Files/Assembly PCBs/Side/SideBottom.jpg

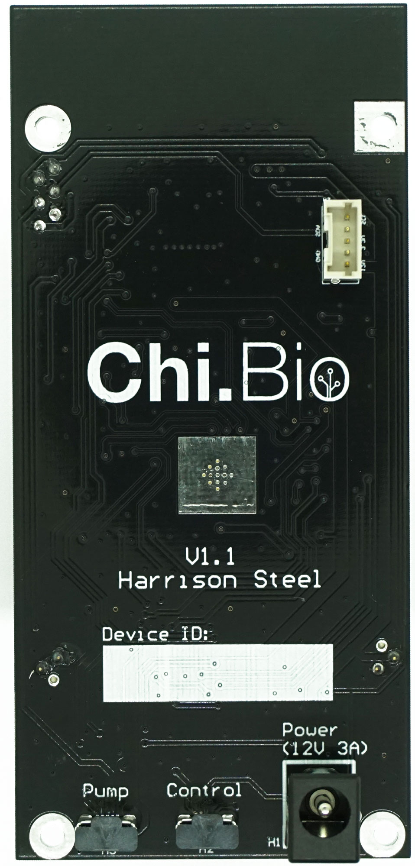
hardware/baseline-digital/PCB Files/Assembly PCBs/Side/SideBottom.jpg
