hs280/chiBioAnalogue/hardware/baseline-digital/PCB Files/Assembly PCBs/Side/SideSide.jpg

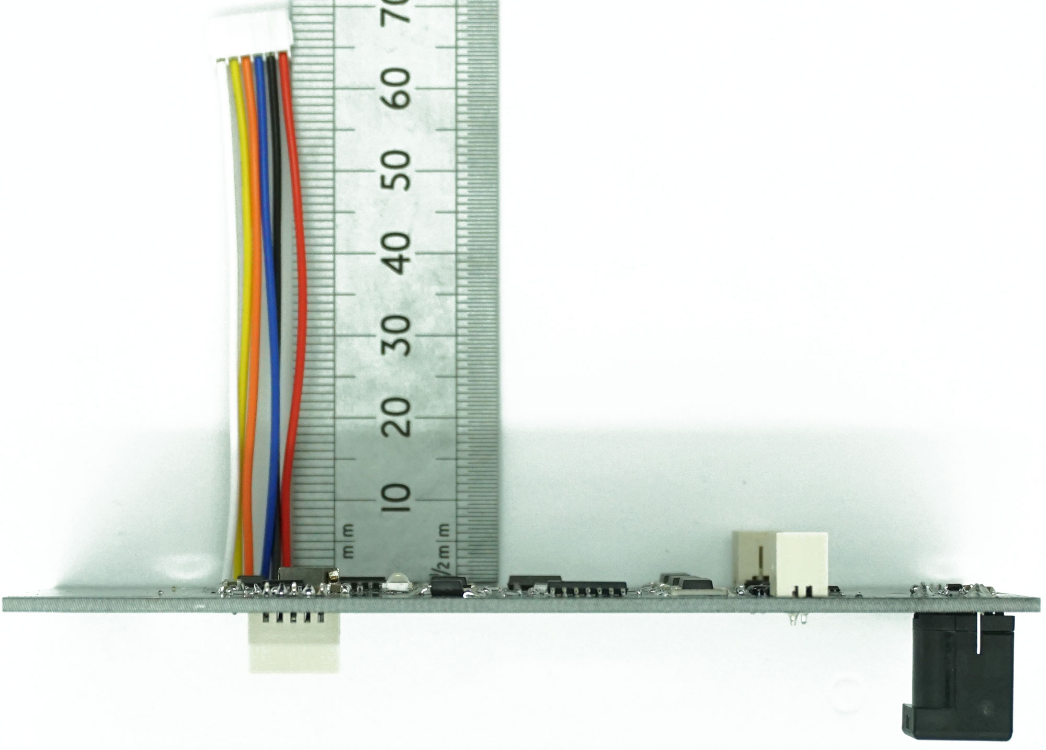
hardware/baseline-digital/PCB Files/Assembly PCBs/Side/SideSide.jpg
