hs280/chiBioAnalogue/hardware/baseline-digital/PCB Files/Assembly PCBs/Side/SideTop.jpg

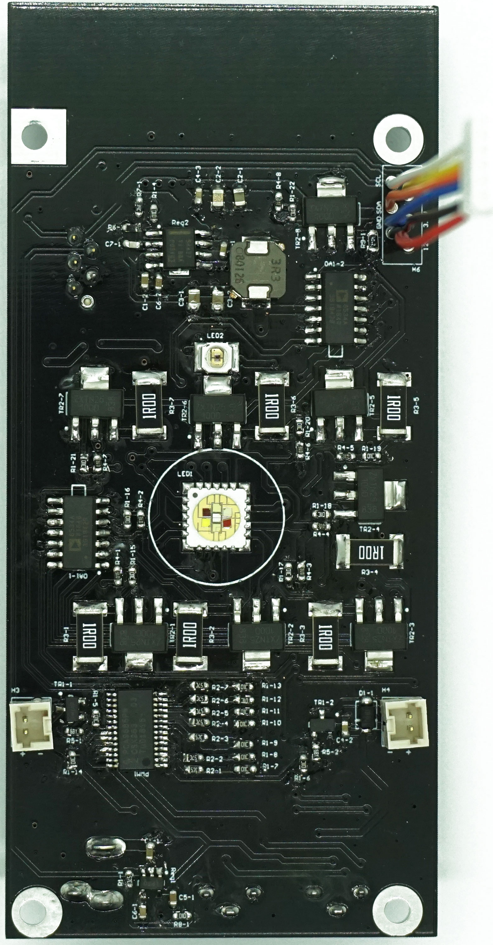
hardware/baseline-digital/PCB Files/Assembly PCBs/Side/SideTop.jpg
