hs280/chiBioAnalogue/hardware/baseline-digital/PCB Files/Assembly PCBs/StructHorizontal/StructHorizontalBottom.jpg

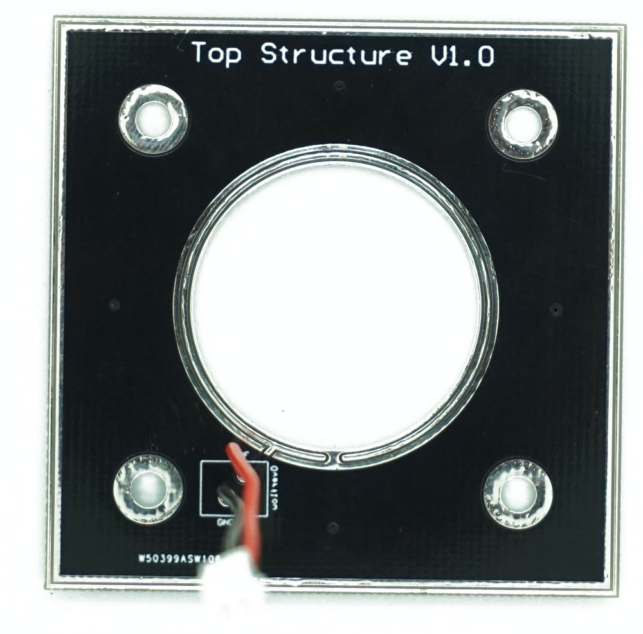
hardware/baseline-digital/PCB Files/Assembly PCBs/StructHorizontal/StructHorizontalBottom.jpg
