hs280/chiBioAnalogue/hardware/baseline-digital/PCB Files/Assembly PCBs/StructHorizontal/StructHorizontalSide.jpg

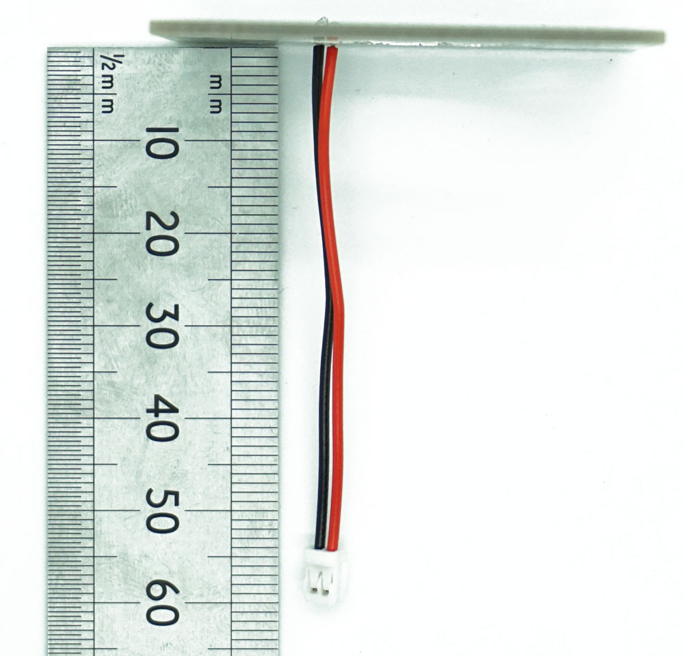
hardware/baseline-digital/PCB Files/Assembly PCBs/StructHorizontal/StructHorizontalSide.jpg
