hs280/chiBioAnalogue/hardware/baseline-digital/PCB Files/Assembly PCBs/StructHorizontal/StructHorizontalTop.jpg

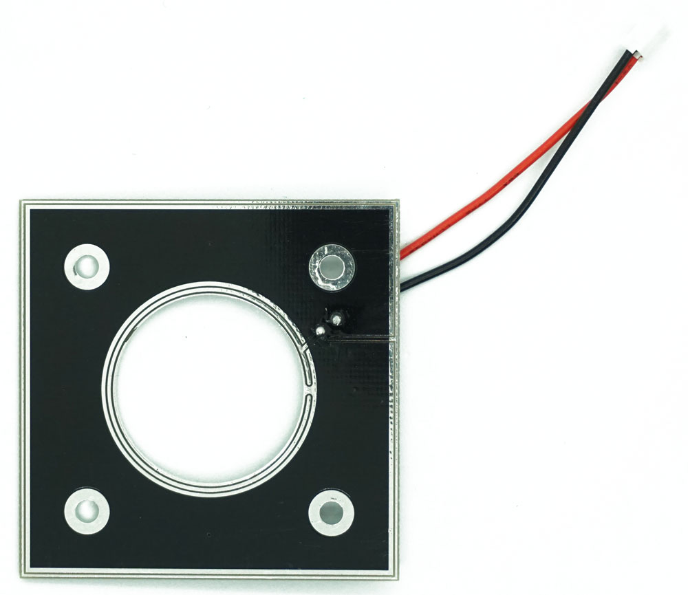
hardware/baseline-digital/PCB Files/Assembly PCBs/StructHorizontal/StructHorizontalTop.jpg
