hs280/chiBioAnalogue/hardware/baseline-digital/PCB Files/Assembly PCBs/LaserMeasure/README.txt

PCB Name: LaserMeasure
Function: Sensor connecting board with temperature measurement, DAC, and voltage regulation.
Notes: Central hole must be between 24.7 and 24.9mm in diameter.
Dimensions (max linear, mm): 45.3 x 49.8
Layers: 2
Material: FR-4
Copper Thickness (oz): 1
Board Thickness (mm): 1.6
Surface Finish: HASL
Min Track/Spacing (mil): 6/6
Min Hole Size (mm): 0.3
Solder Mask: Black
Silkscreen: White
Assembly Required: Yes
Board Outline Layer: Mechanical 1
