hs280/chiBioAnalogue/hardware/baseline-digital/PCB Files/Assembly PCBs/LaserMeasure/LaserMeasureBottom.jpg

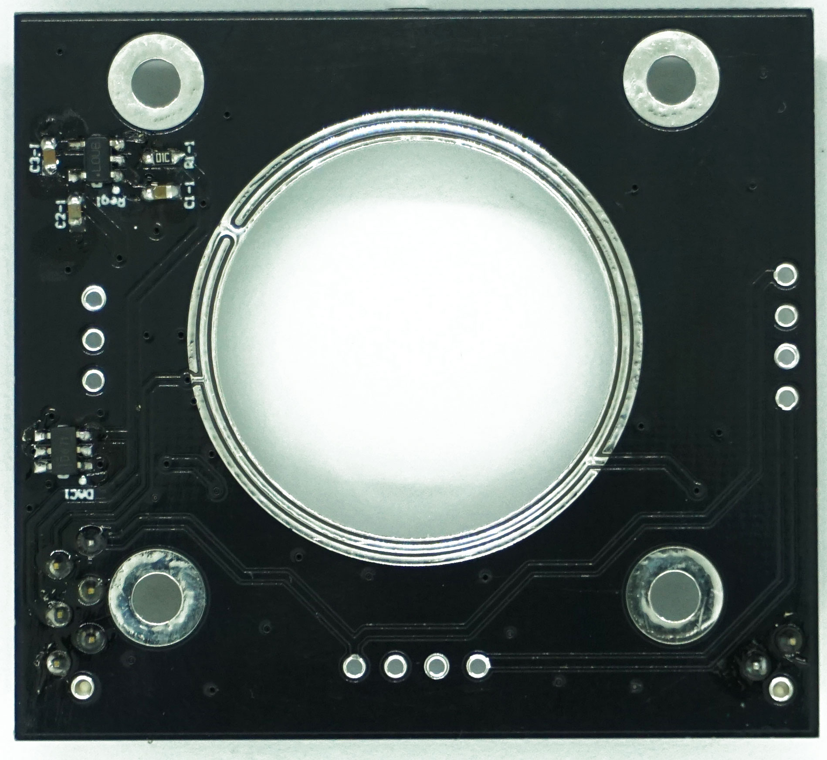
hardware/baseline-digital/PCB Files/Assembly PCBs/LaserMeasure/LaserMeasureBottom.jpg
