hs280/chiBioAnalogue/hardware/baseline-digital/PCB Files/Assembly PCBs/IRSensor/Job1.PDF

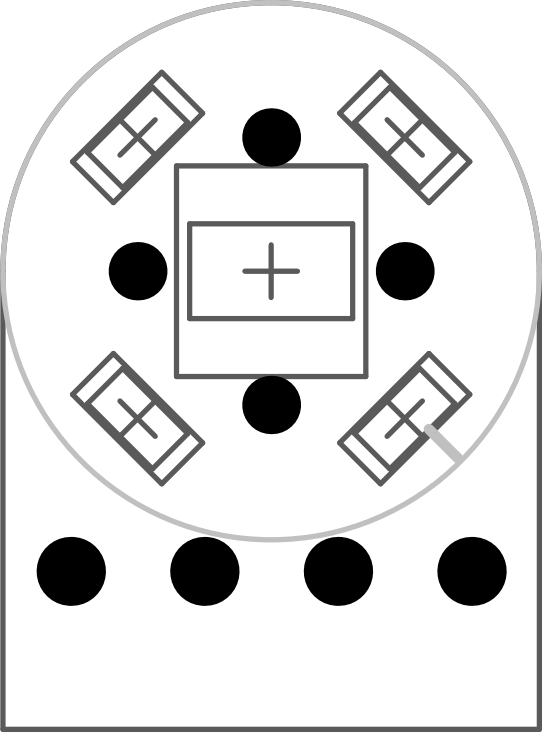
[picture p71: page 1]

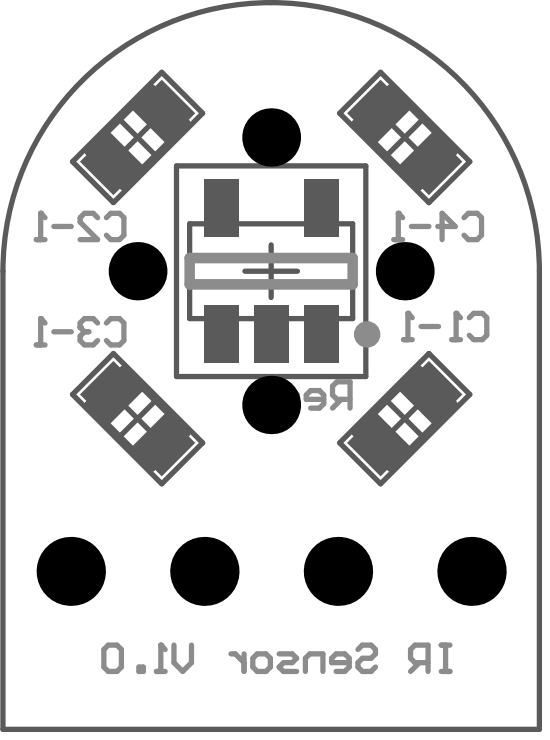
[picture p72: page 2]

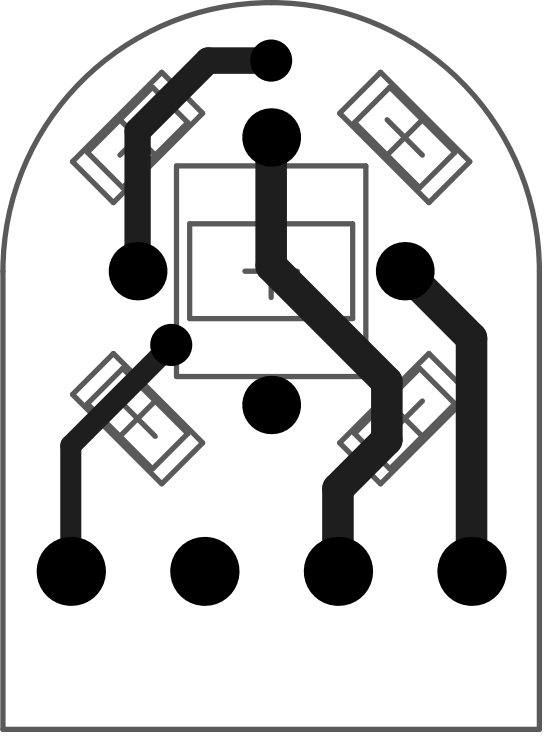
[picture p73: page 3]

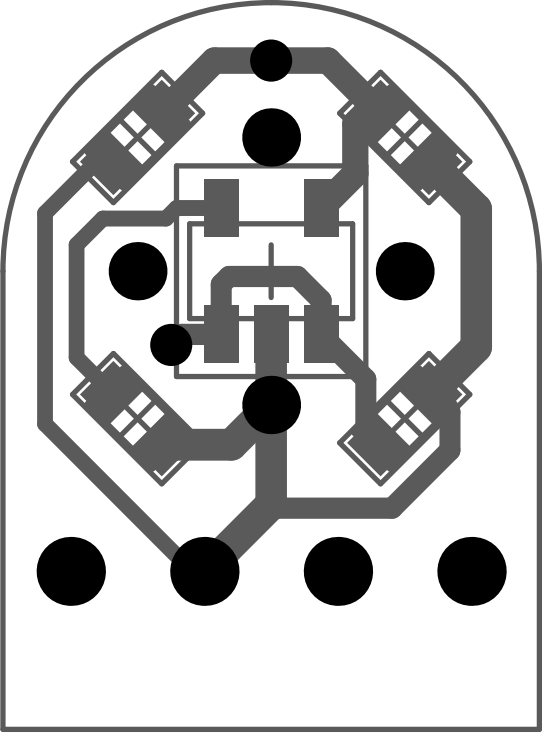
[picture p74: page 4]

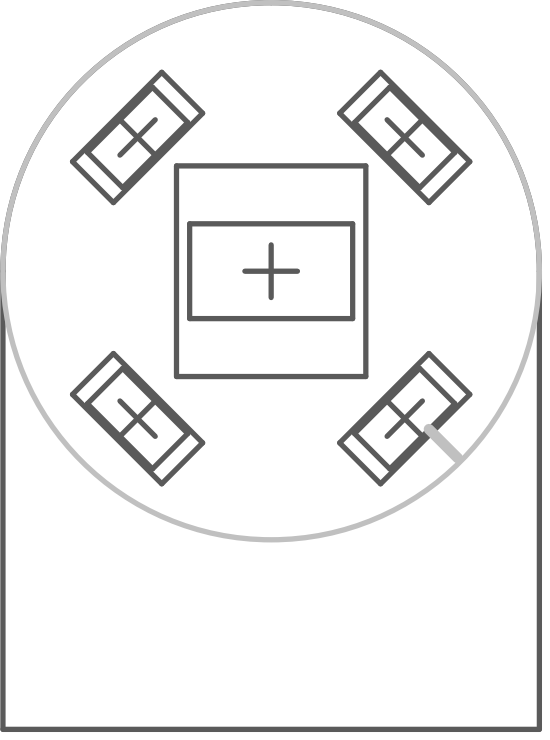
[picture p75: page 5]

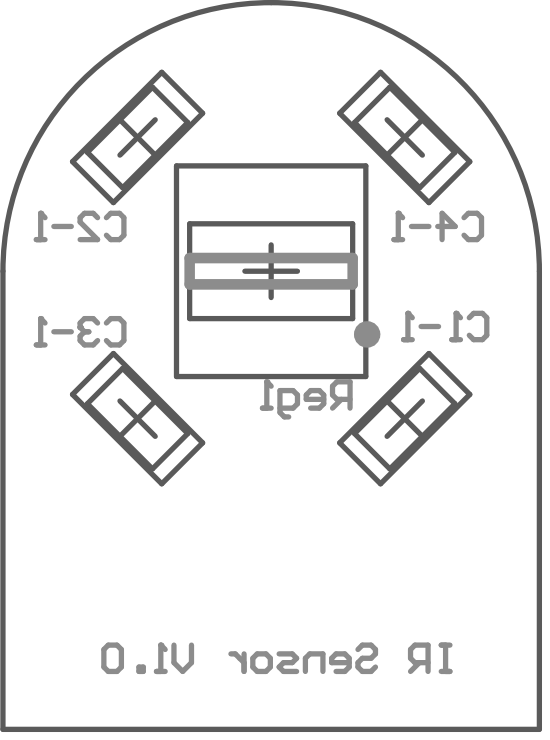
[picture p76: page 6]

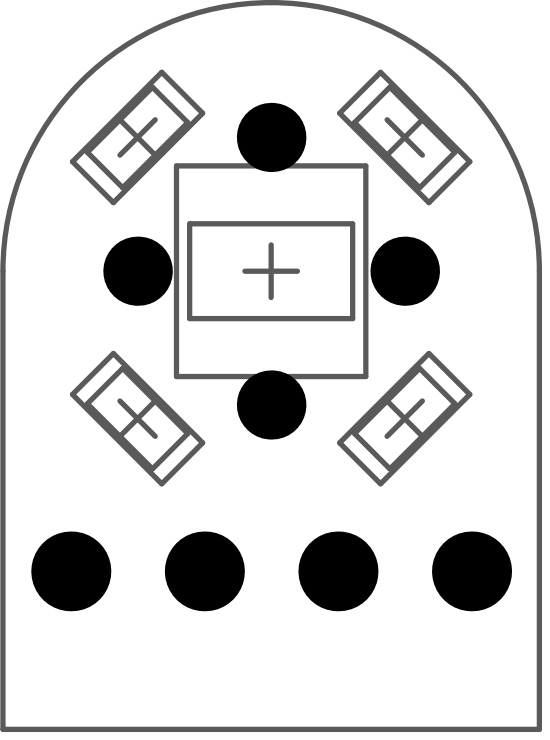
[picture p77: page 7]

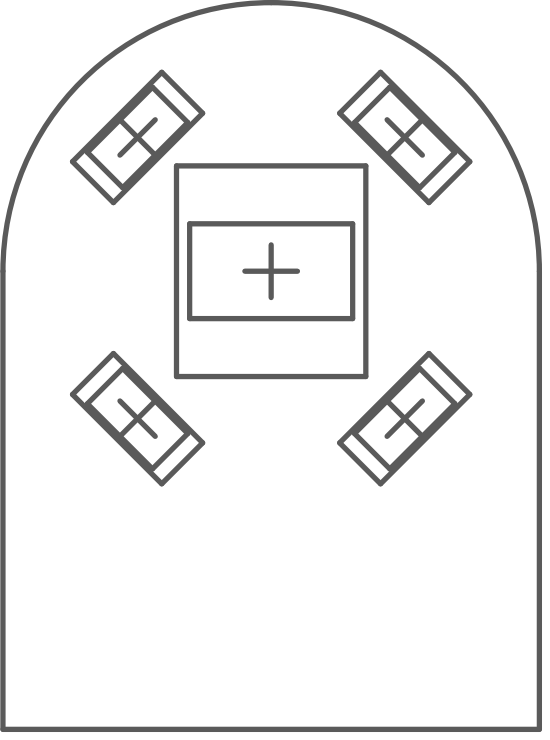
[picture p78: page 8]

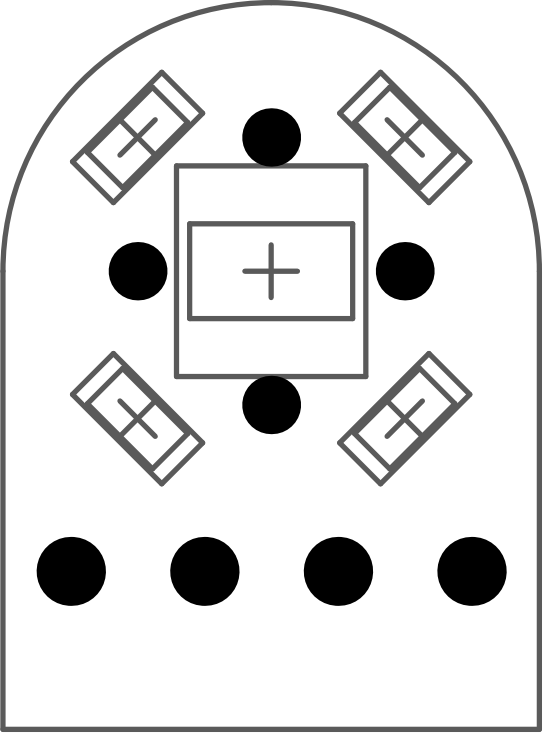
[picture p79: page 11]

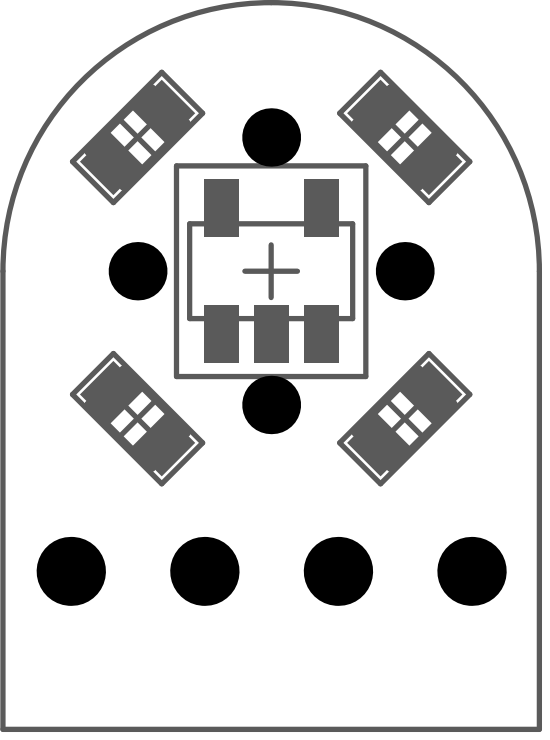
[picture p80: page 12]

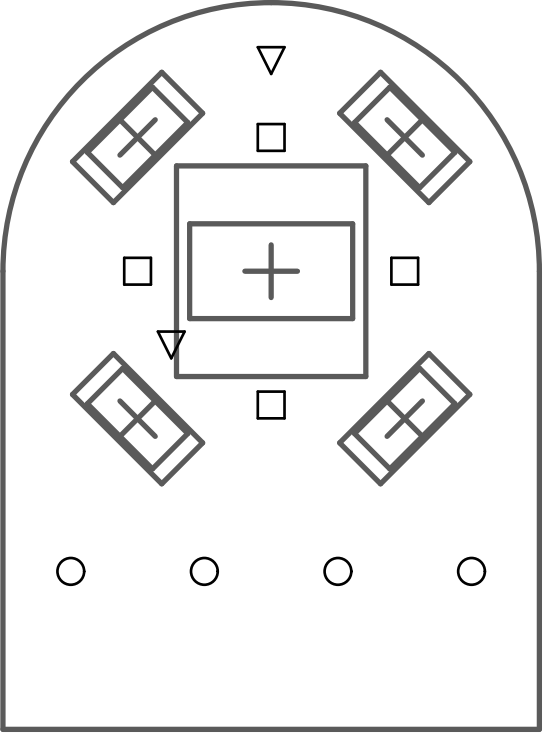
[picture p81: page 13]

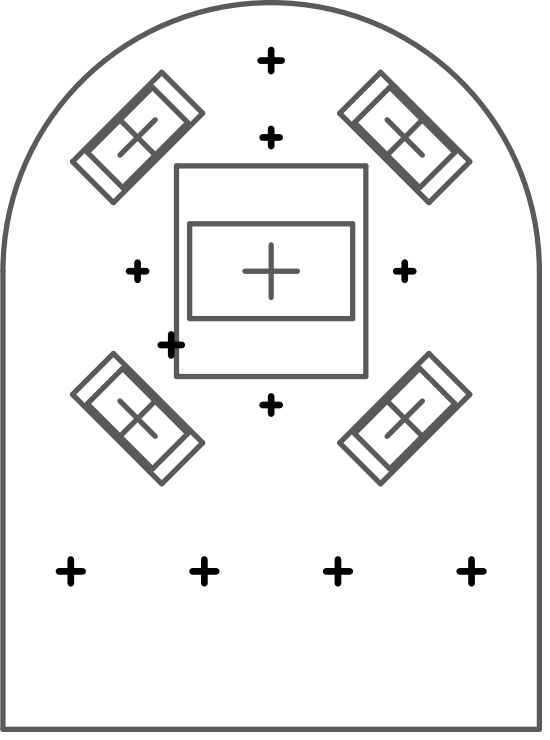
[picture p82: page 14]
