hs280/chiBioAnalogue/hardware/baseline-digital/PCB Files/Assembly PCBs/LaserBreakout/Job1.PDF

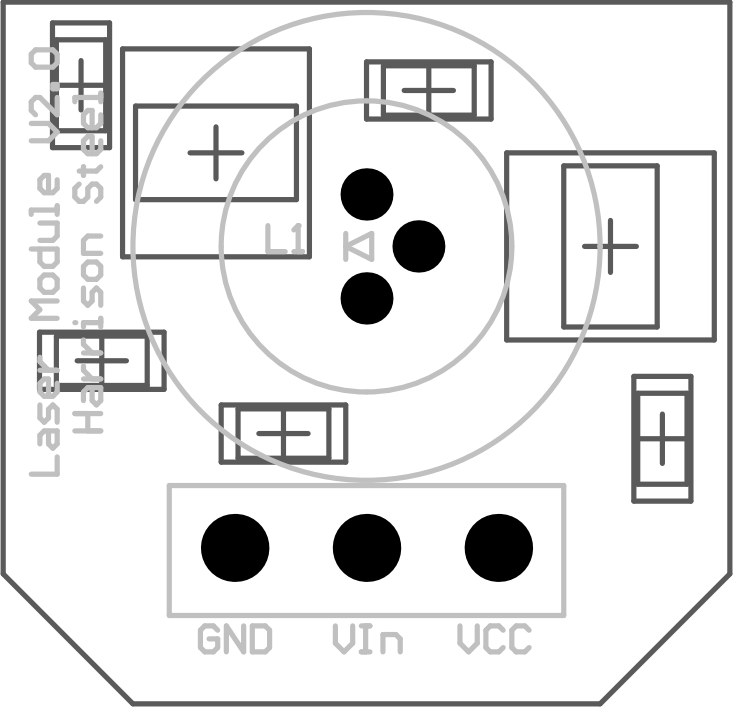
[picture p83: page 1]

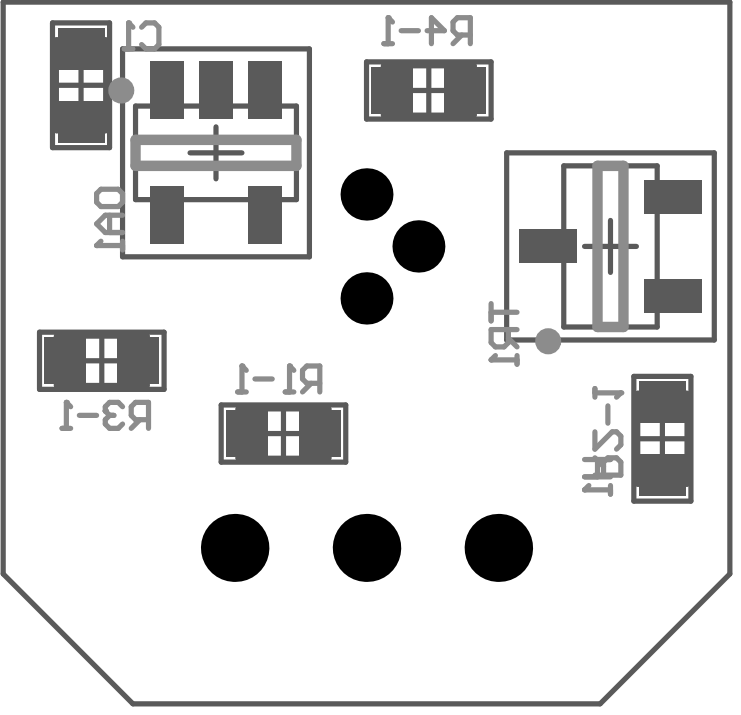
[picture p84: page 2]

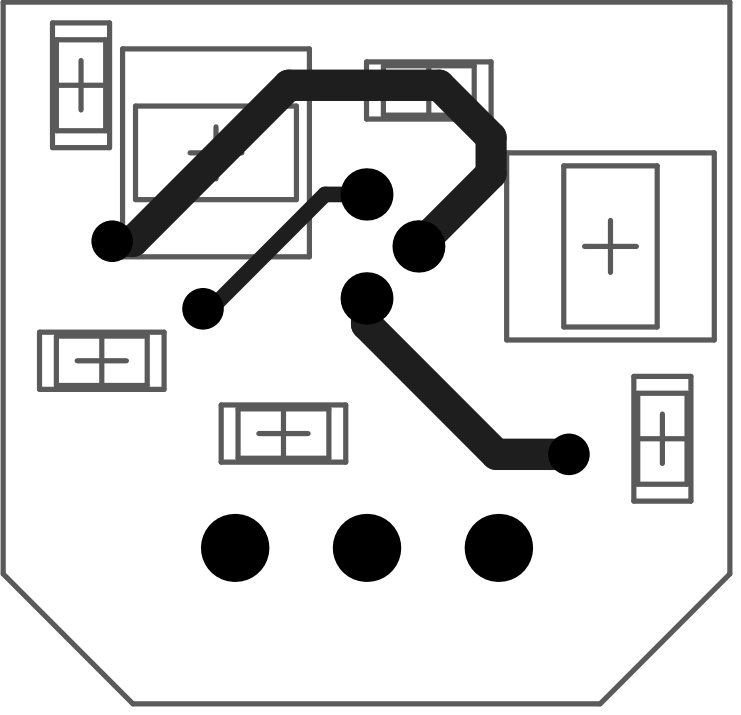
[picture p85: page 3]

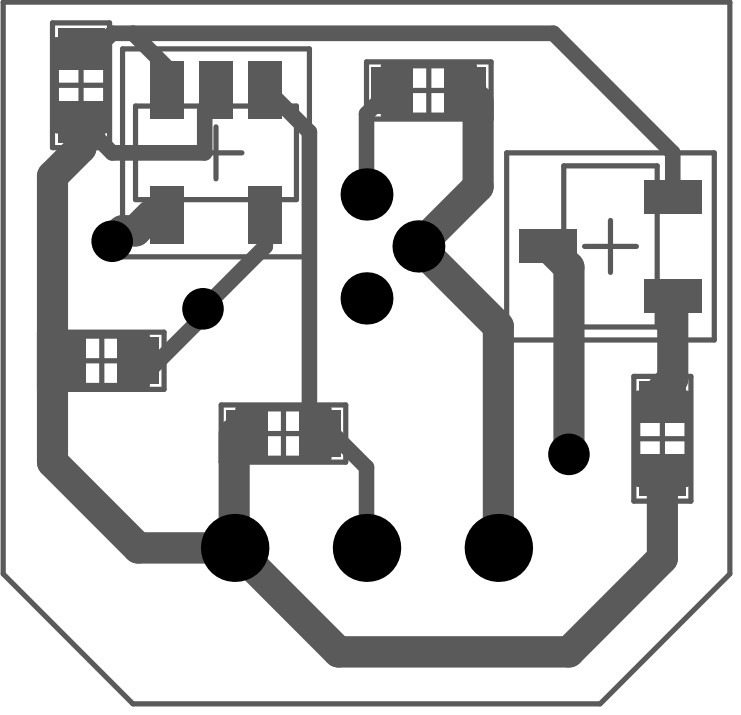
[picture p86: page 4]

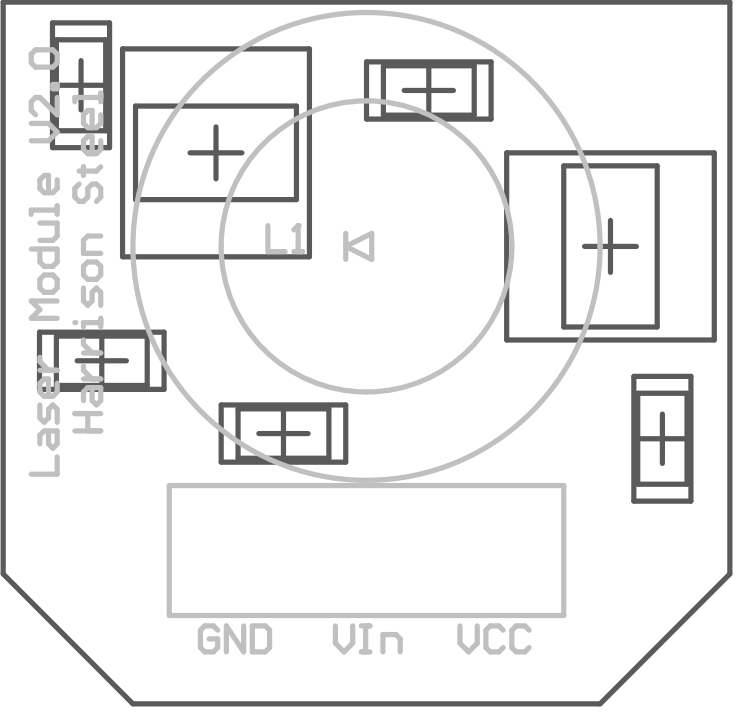
[picture p87: page 5]

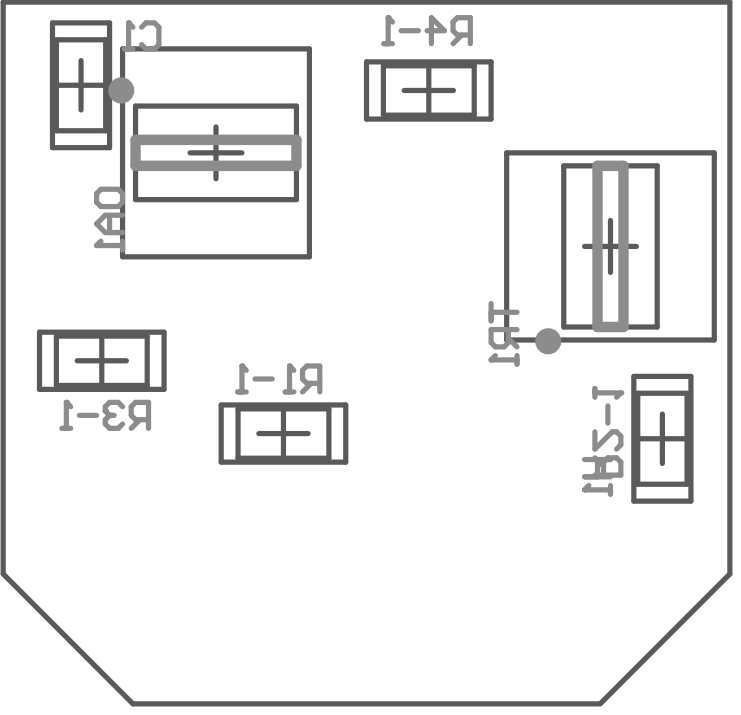
[picture p88: page 6]

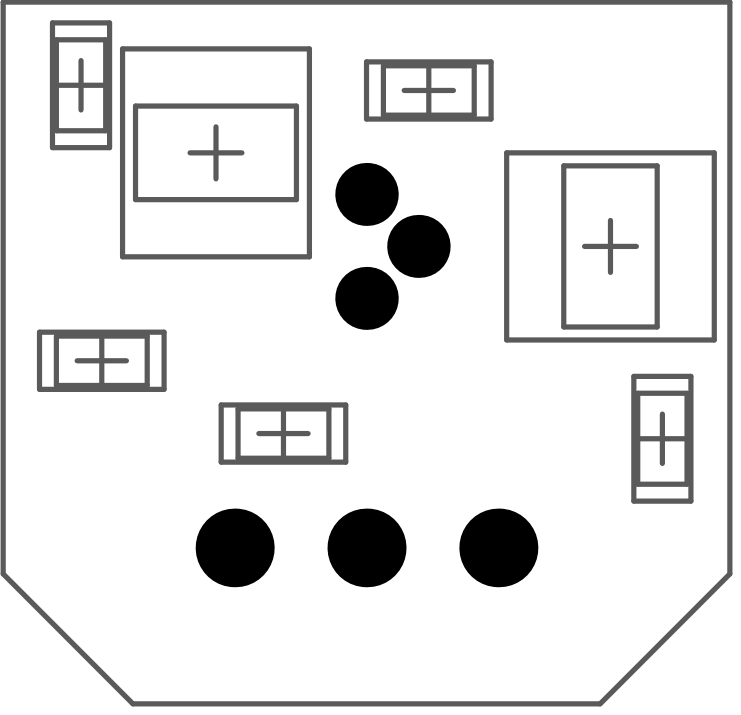
[picture p89: page 7]

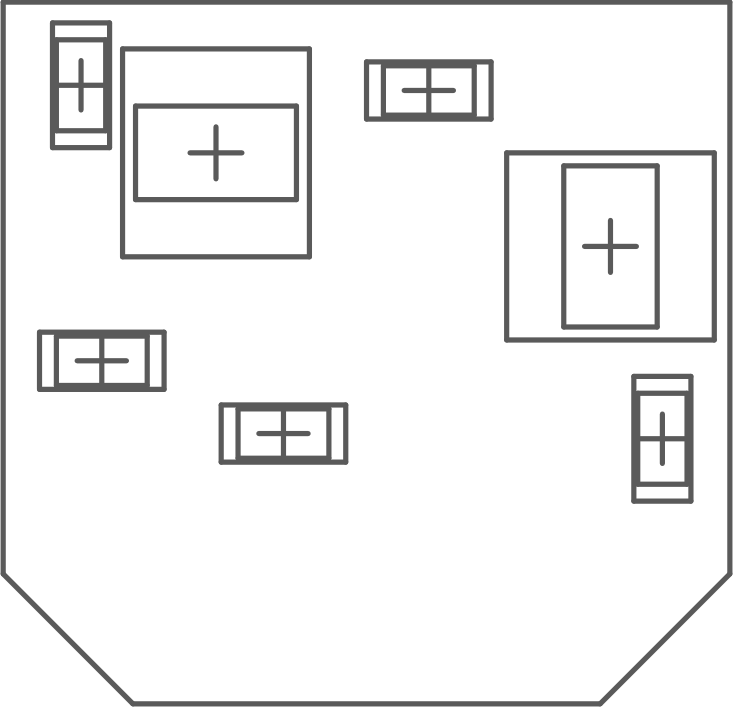
[picture p90: page 8]

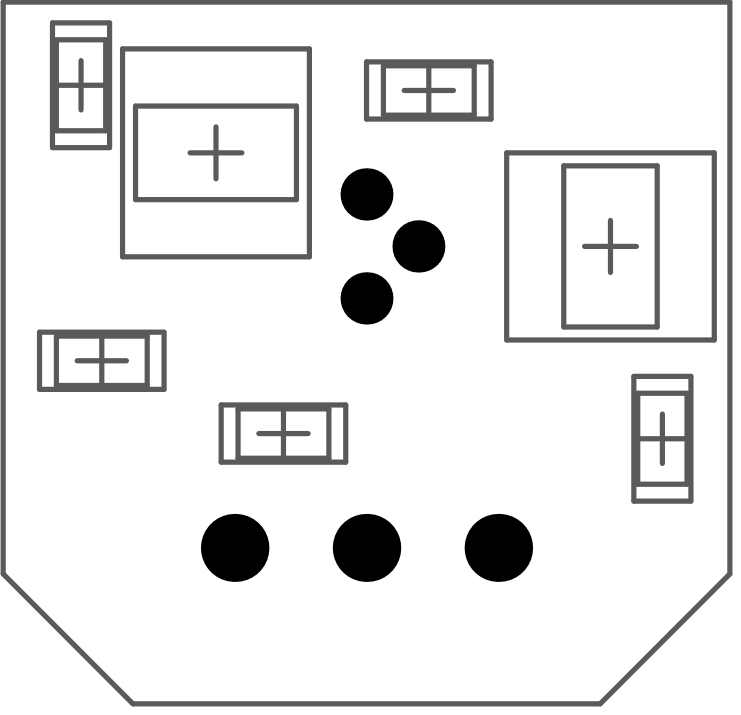
[picture p91: page 11]

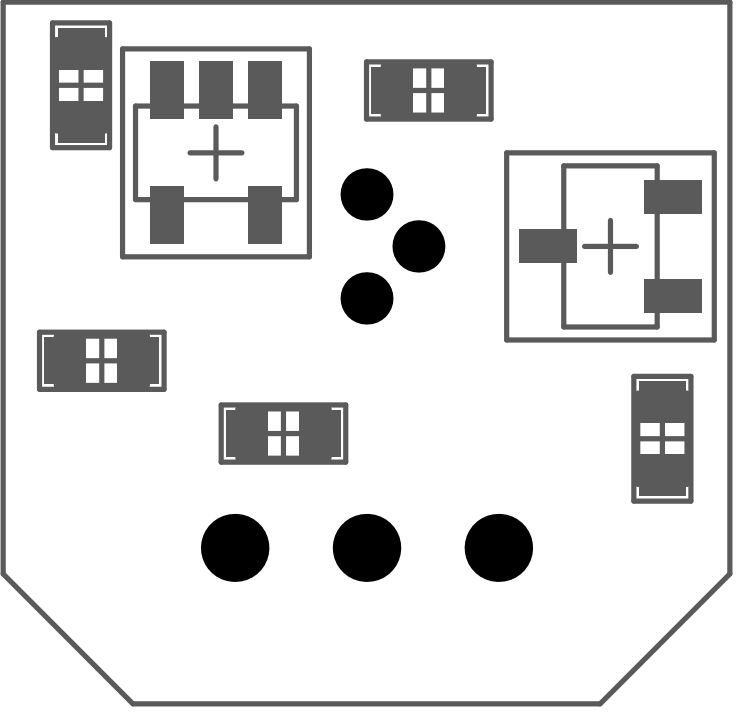
[picture p92: page 12]

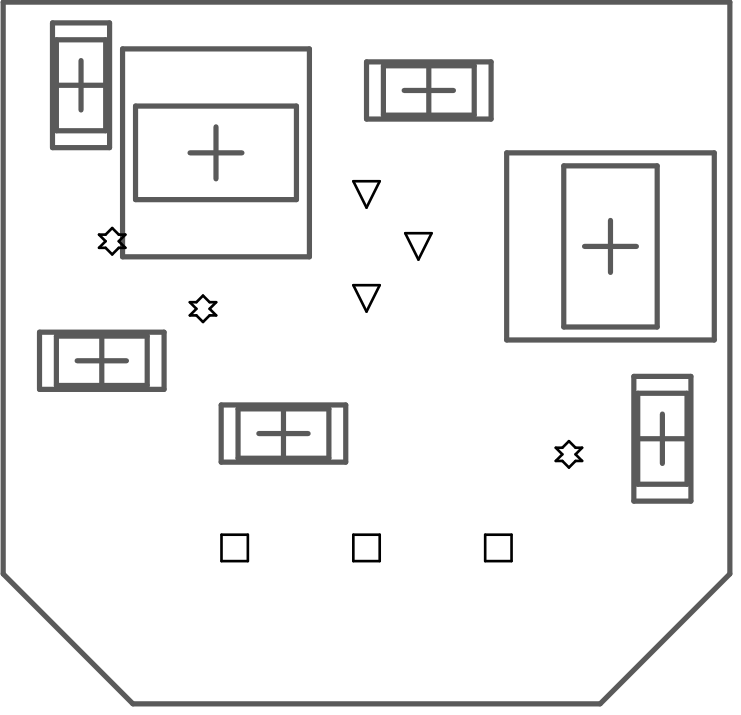
[picture p93: page 13]

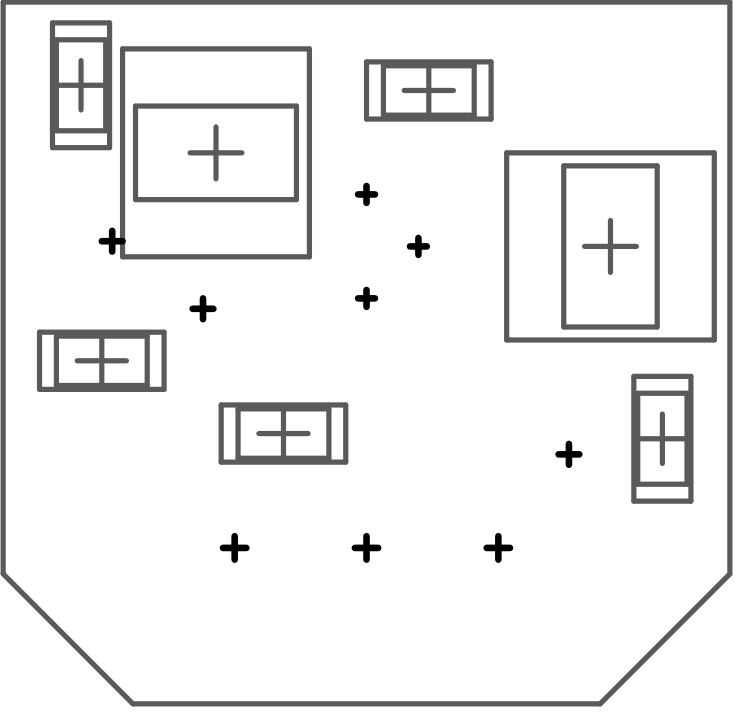
[picture p94: page 14]
