hs280/chiBioAnalogue/hardware/baseline-digital/PCB Files/Assembly PCBs/LaserMeasure/Job1.PDF

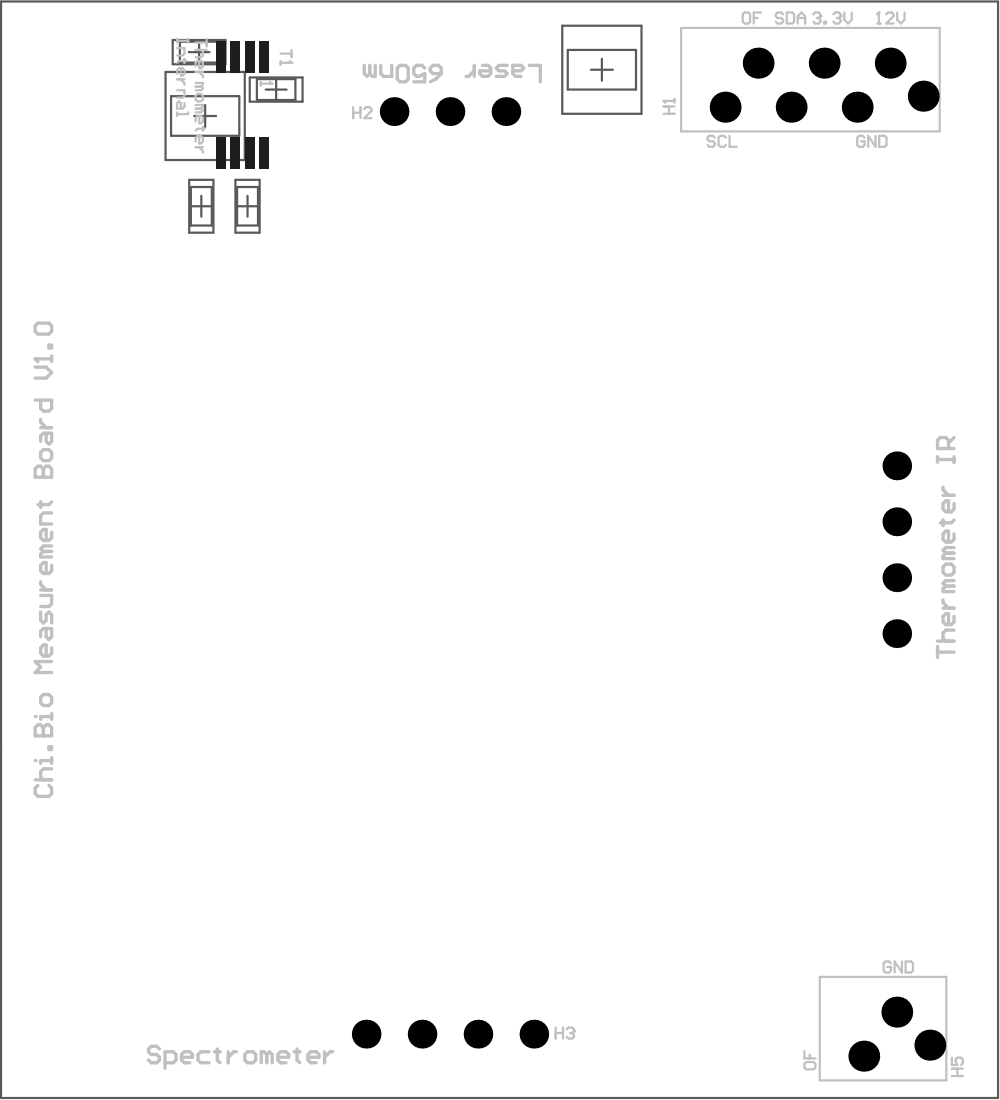
[picture p95: page 1]

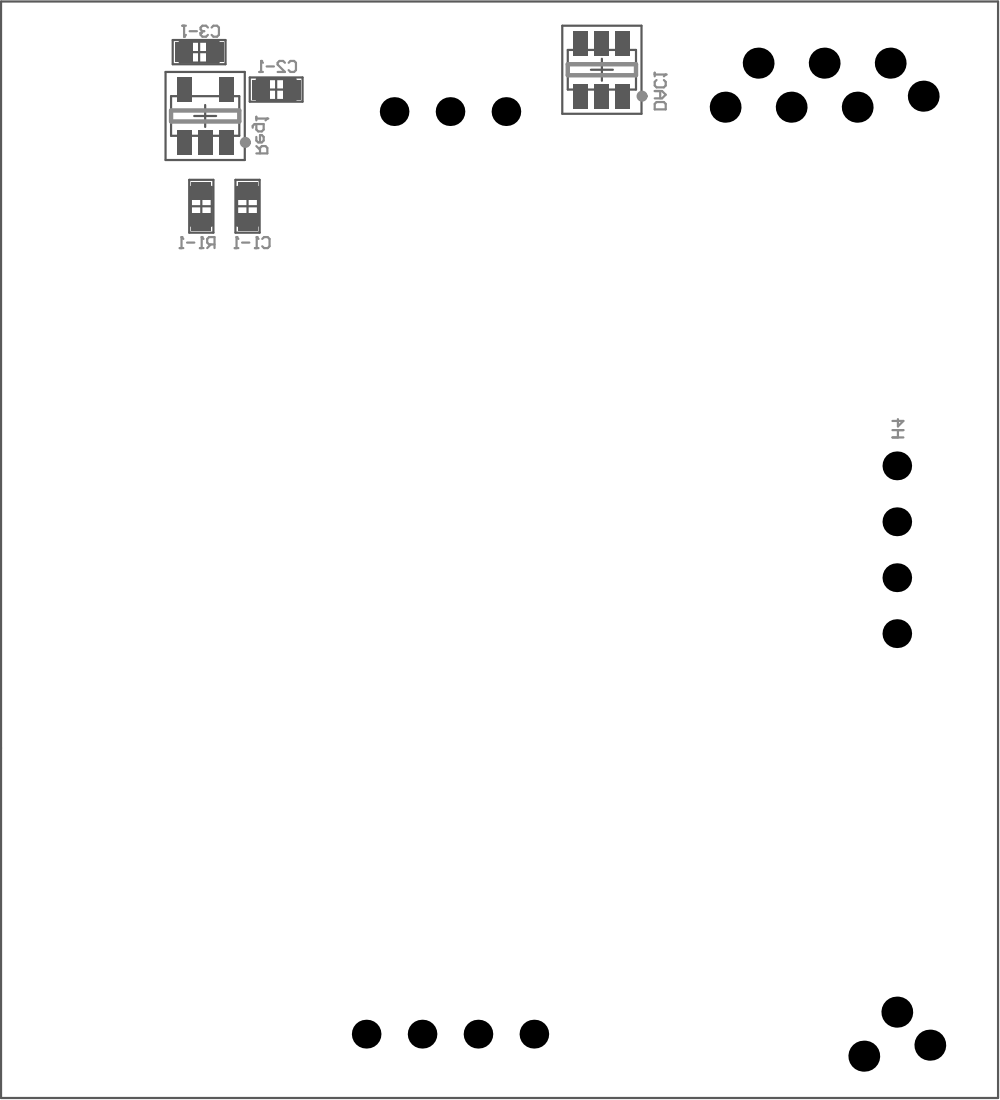
[picture p96: page 2]

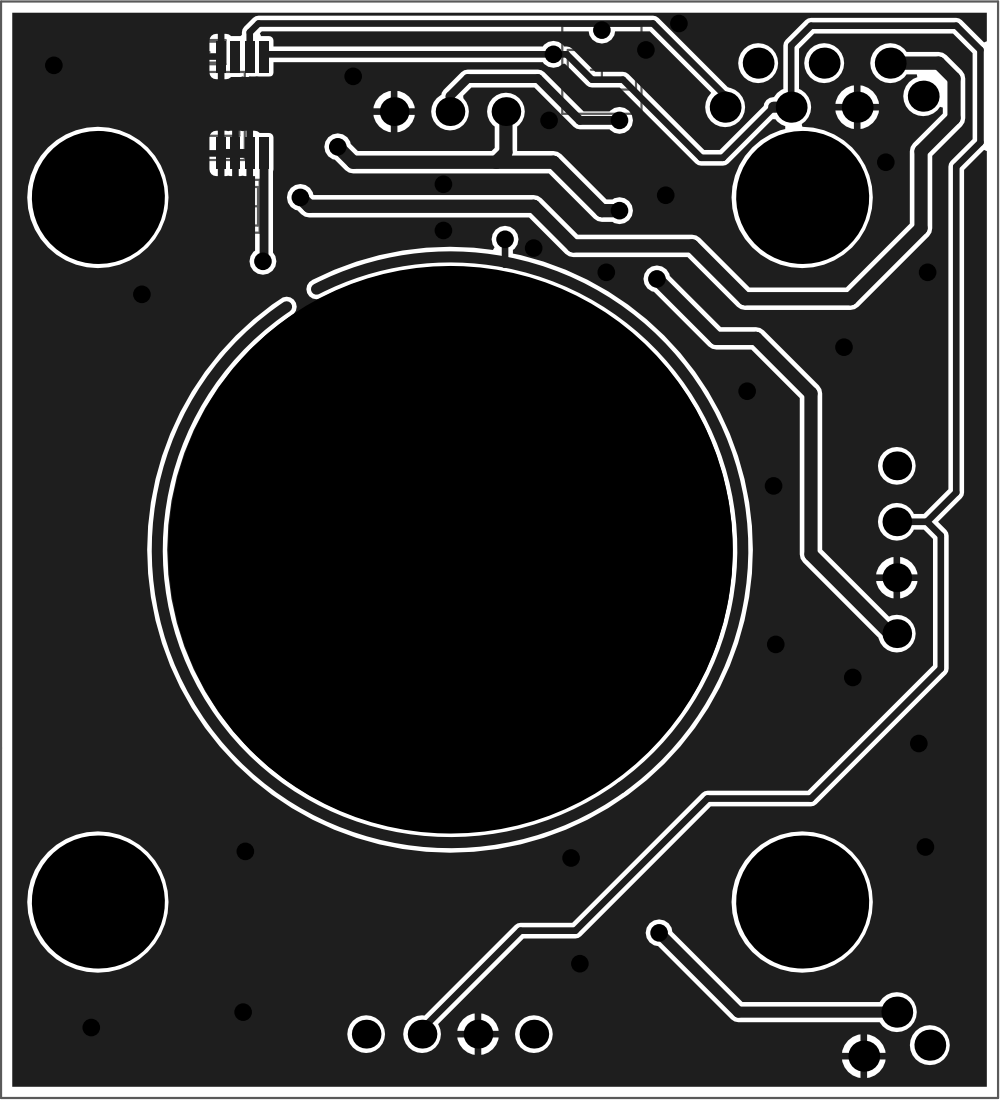
[picture p97: page 3]

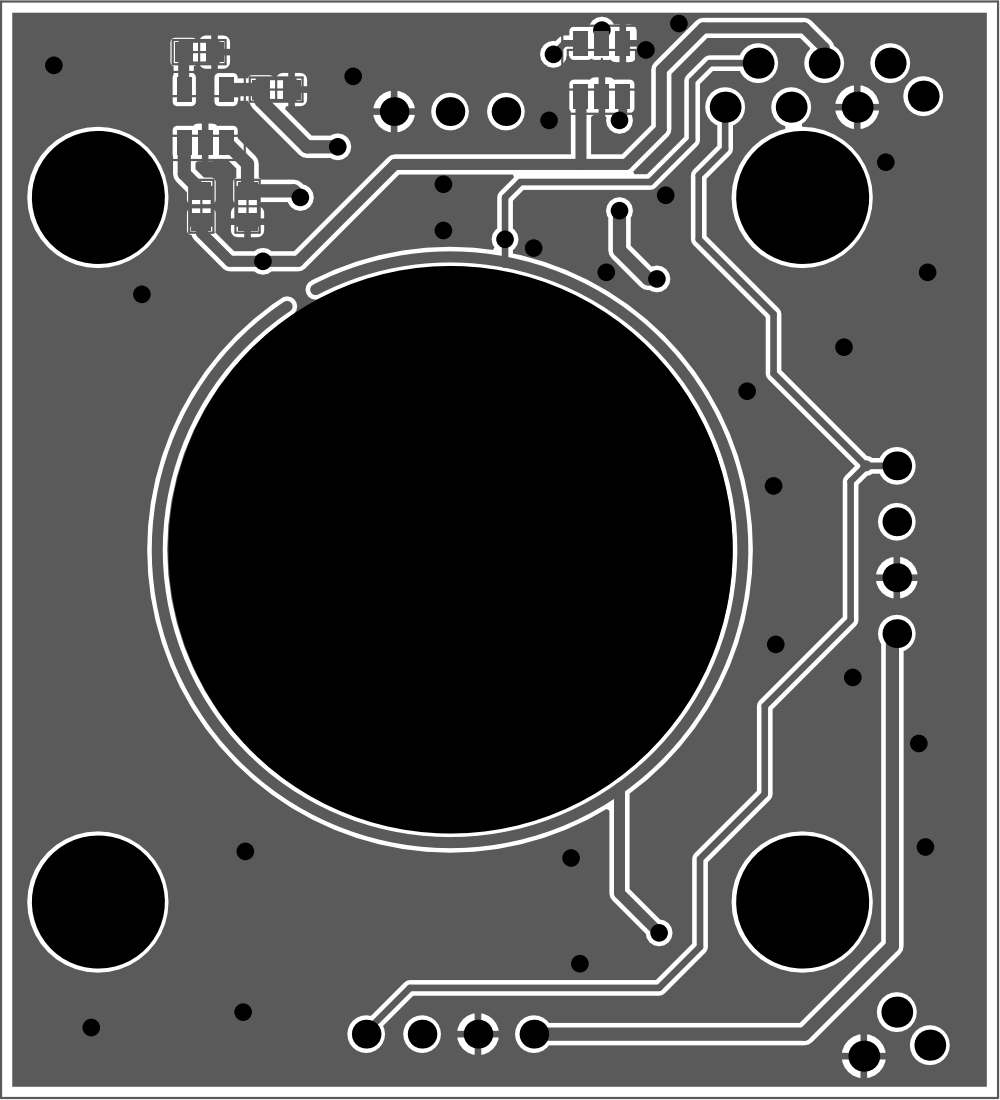
[picture p98: page 4]

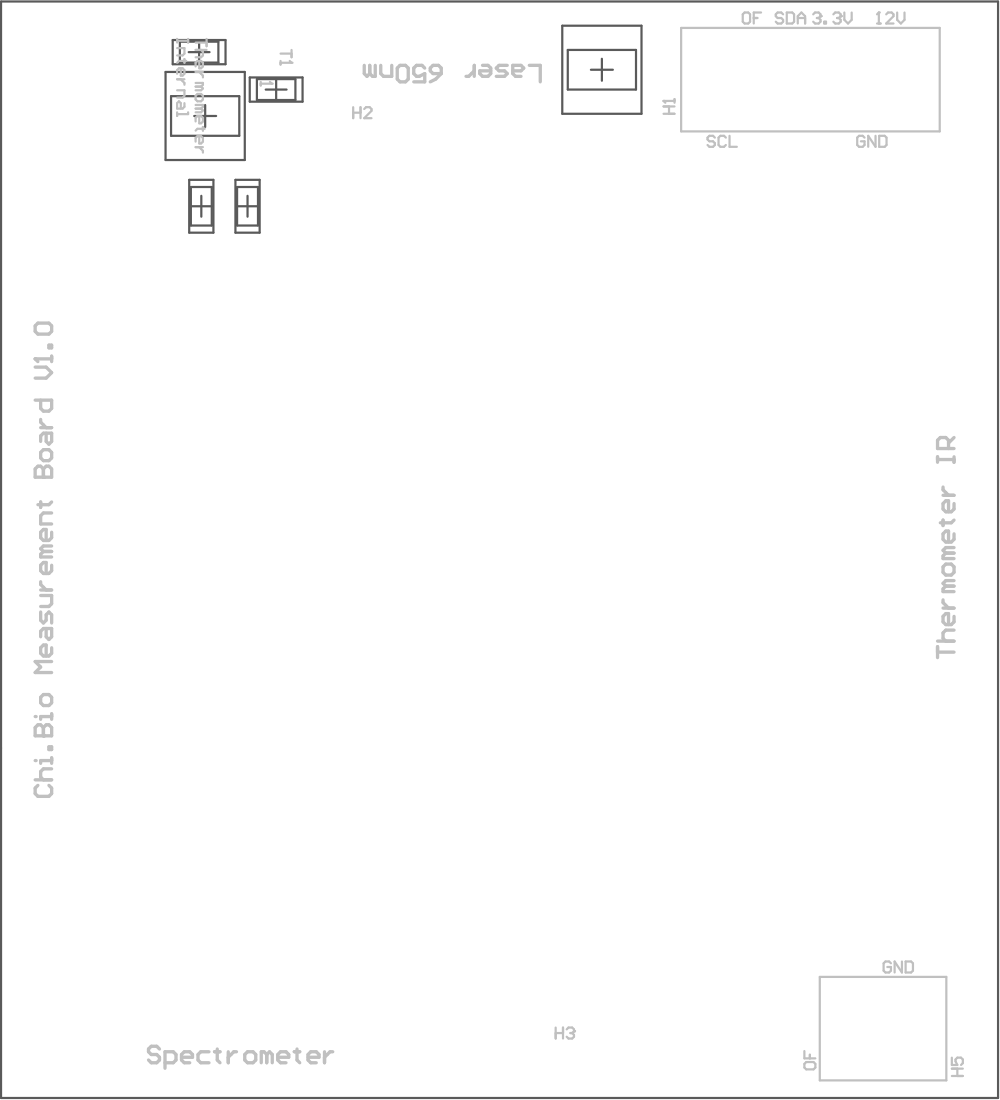
[picture p99: page 5]

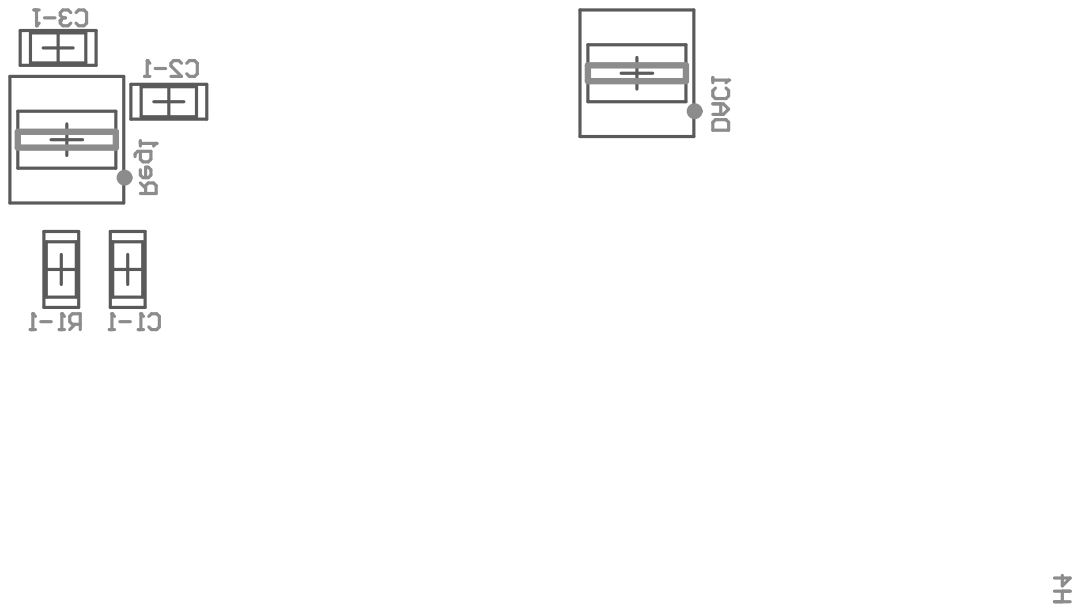
[picture p100: page 6]

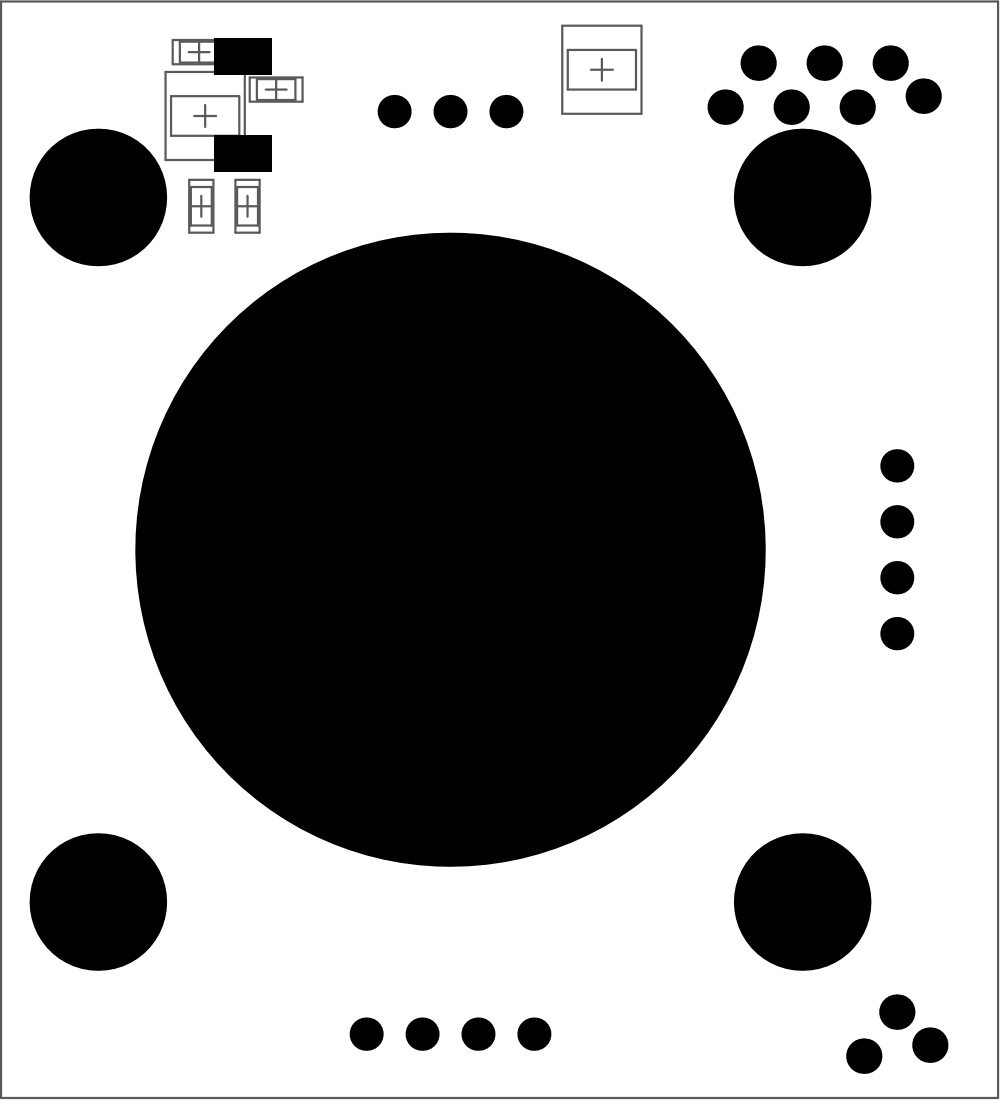
[picture p101: page 7]

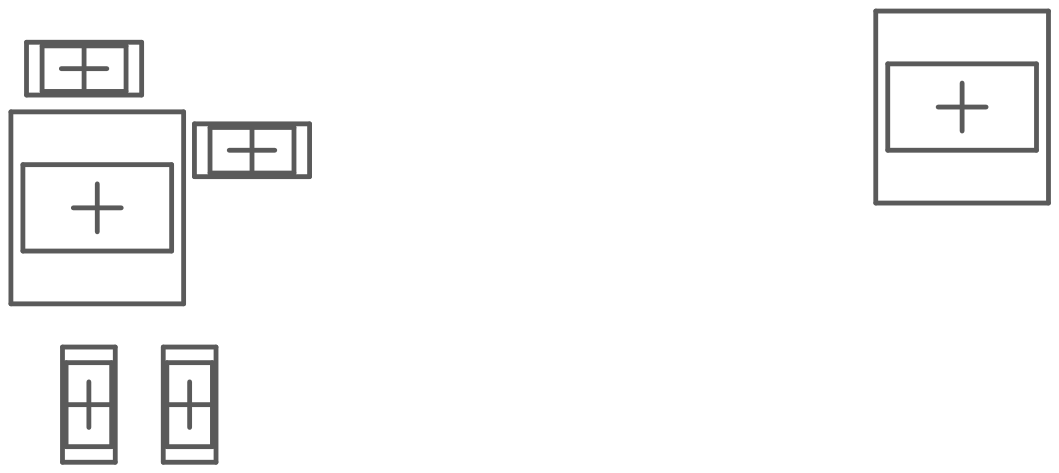
[picture p102: page 8]

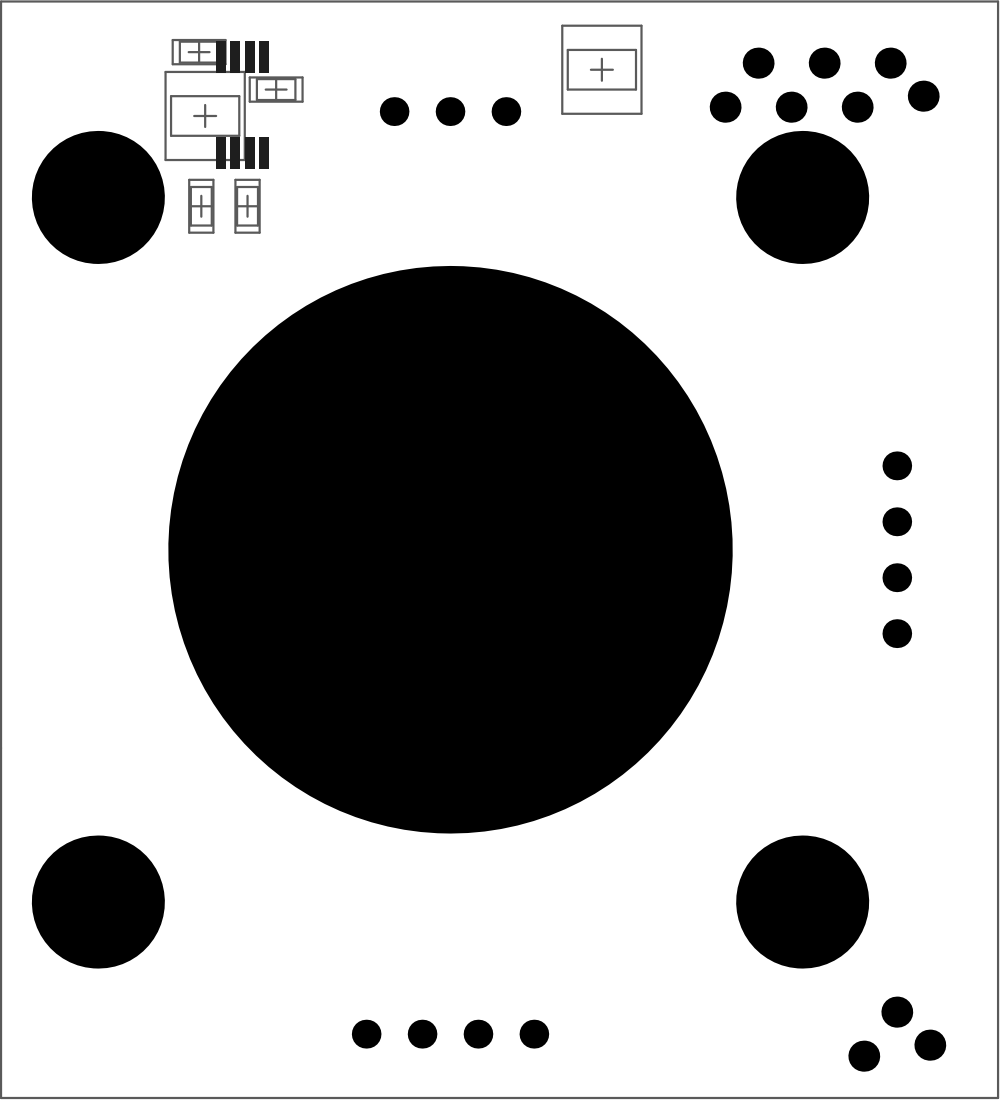
[picture p103: page 11]

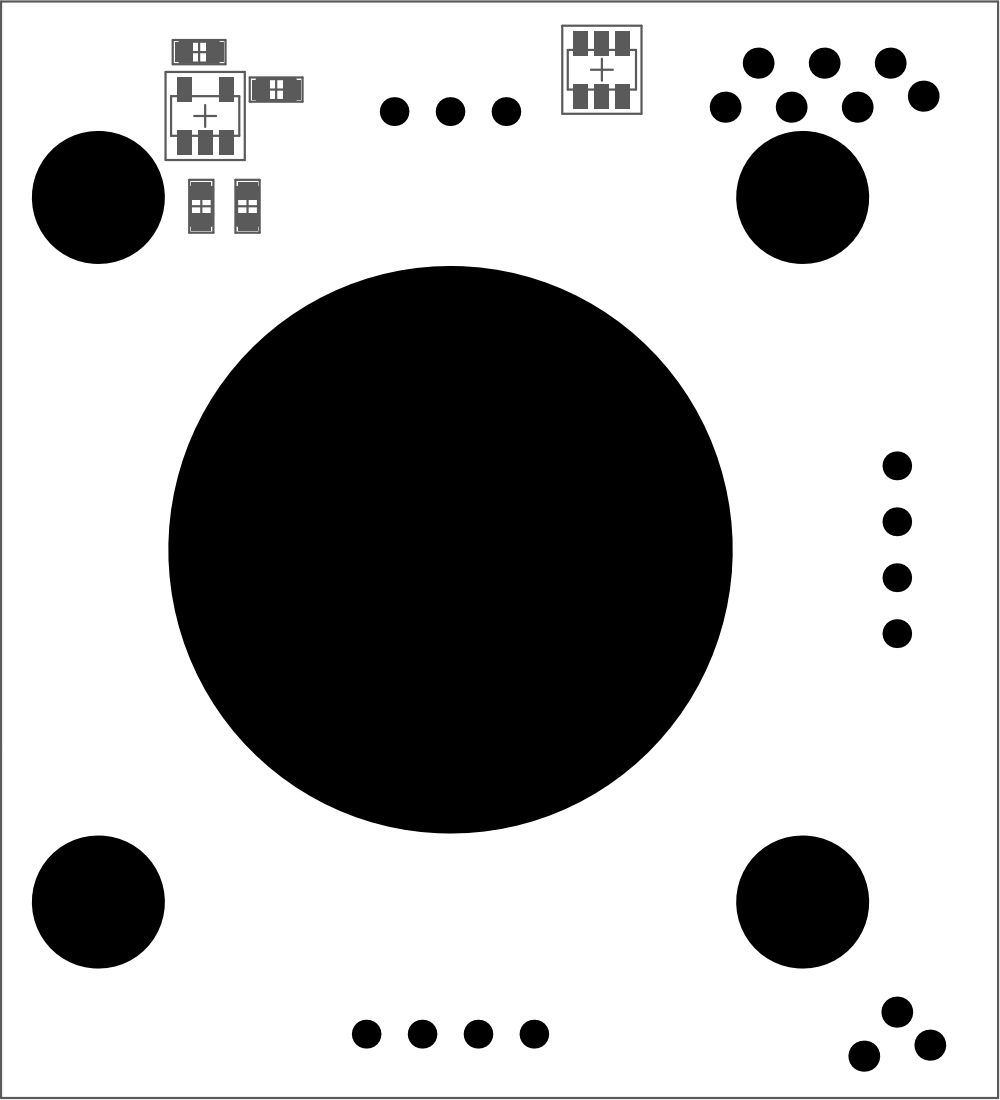
[picture p104: page 12]

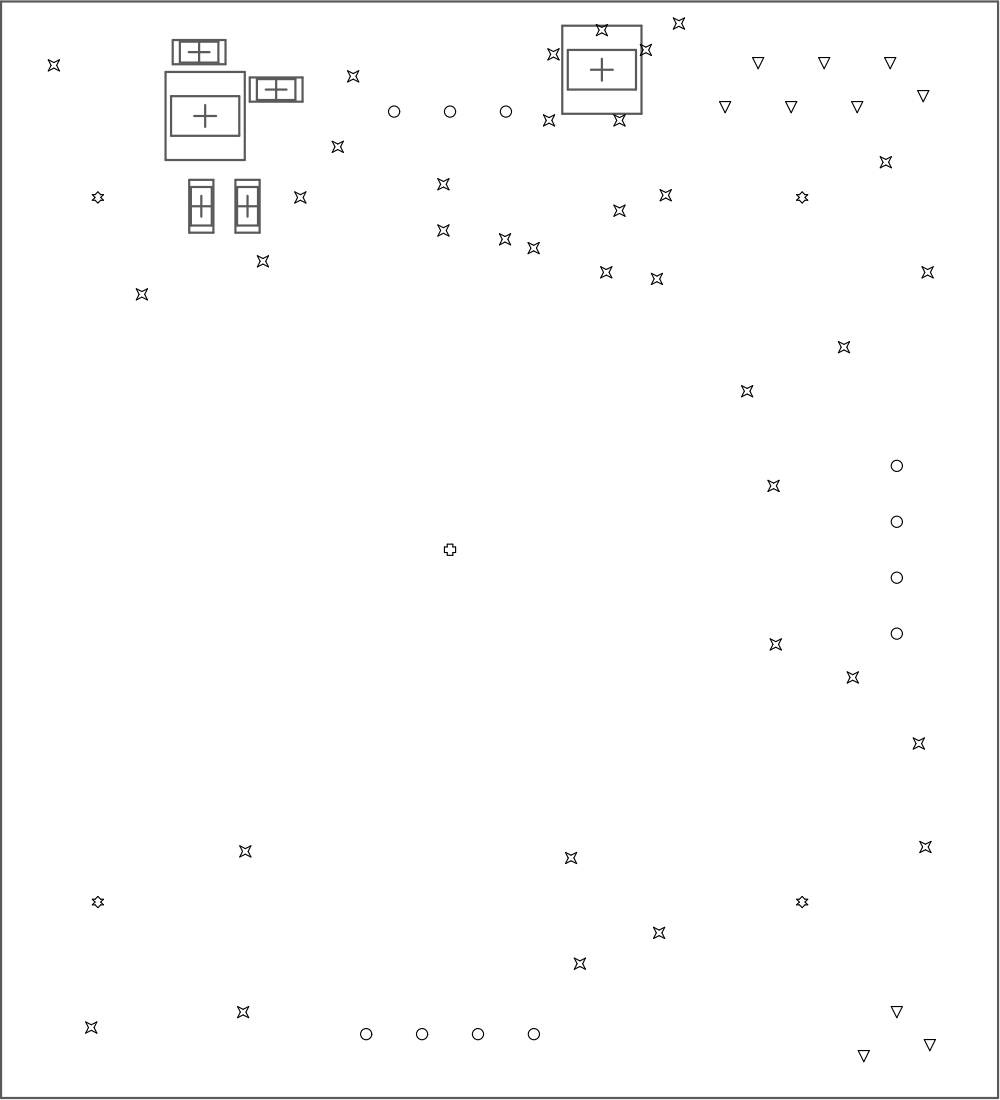
[picture p105: page 13]

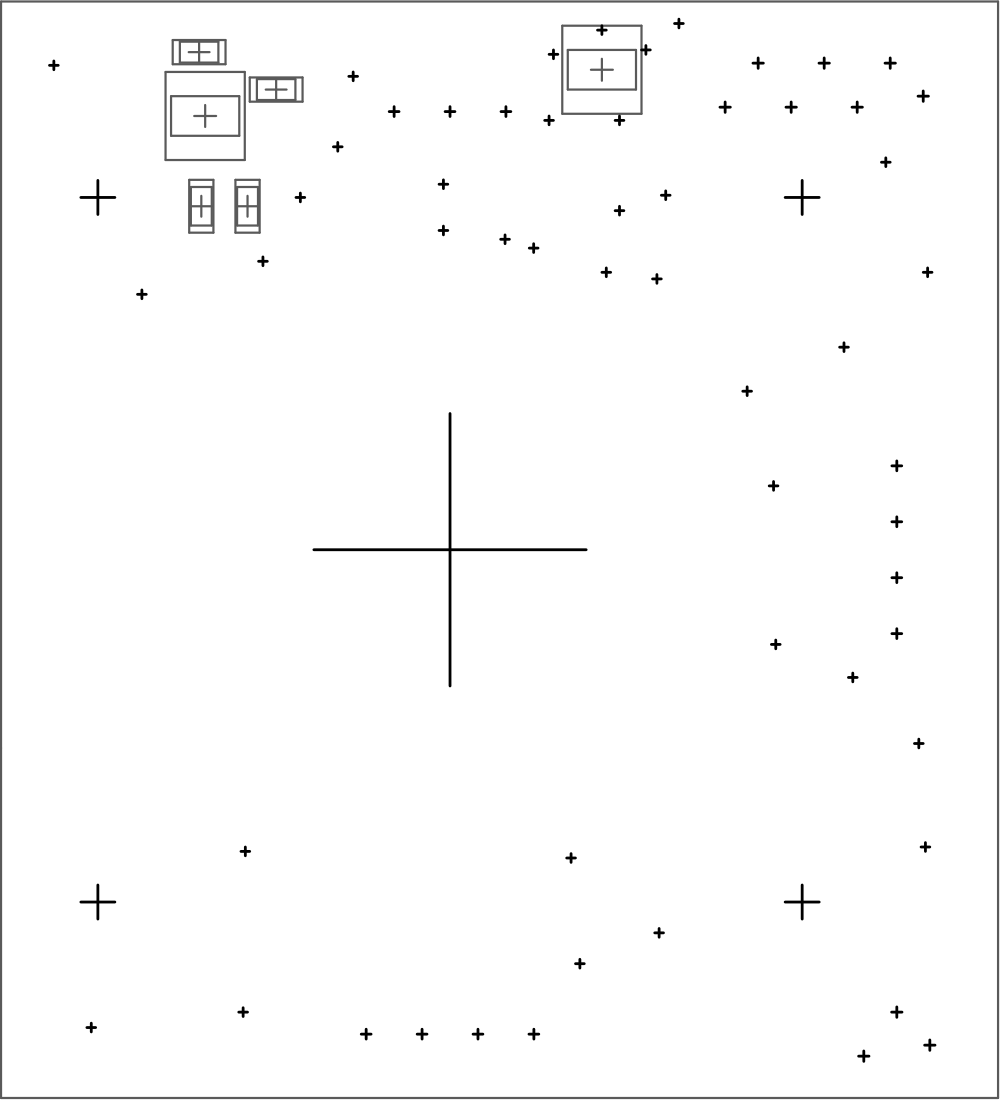
[picture p106: page 14]
