hs280/chiBioAnalogue/hardware/baseline-digital/PCB Files/Assembly PCBs/Pump/Job1.PDF

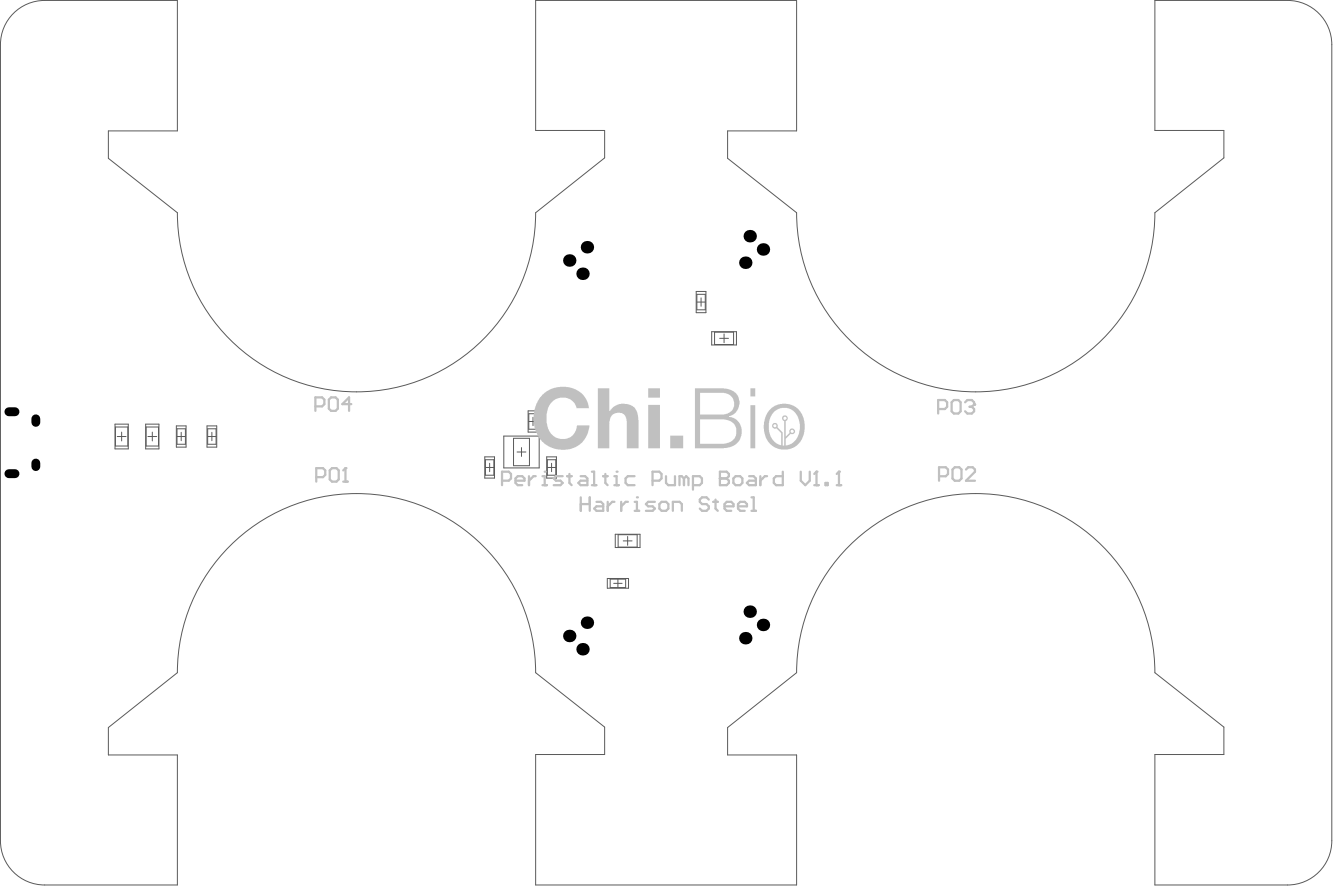
[picture p107: page 1]

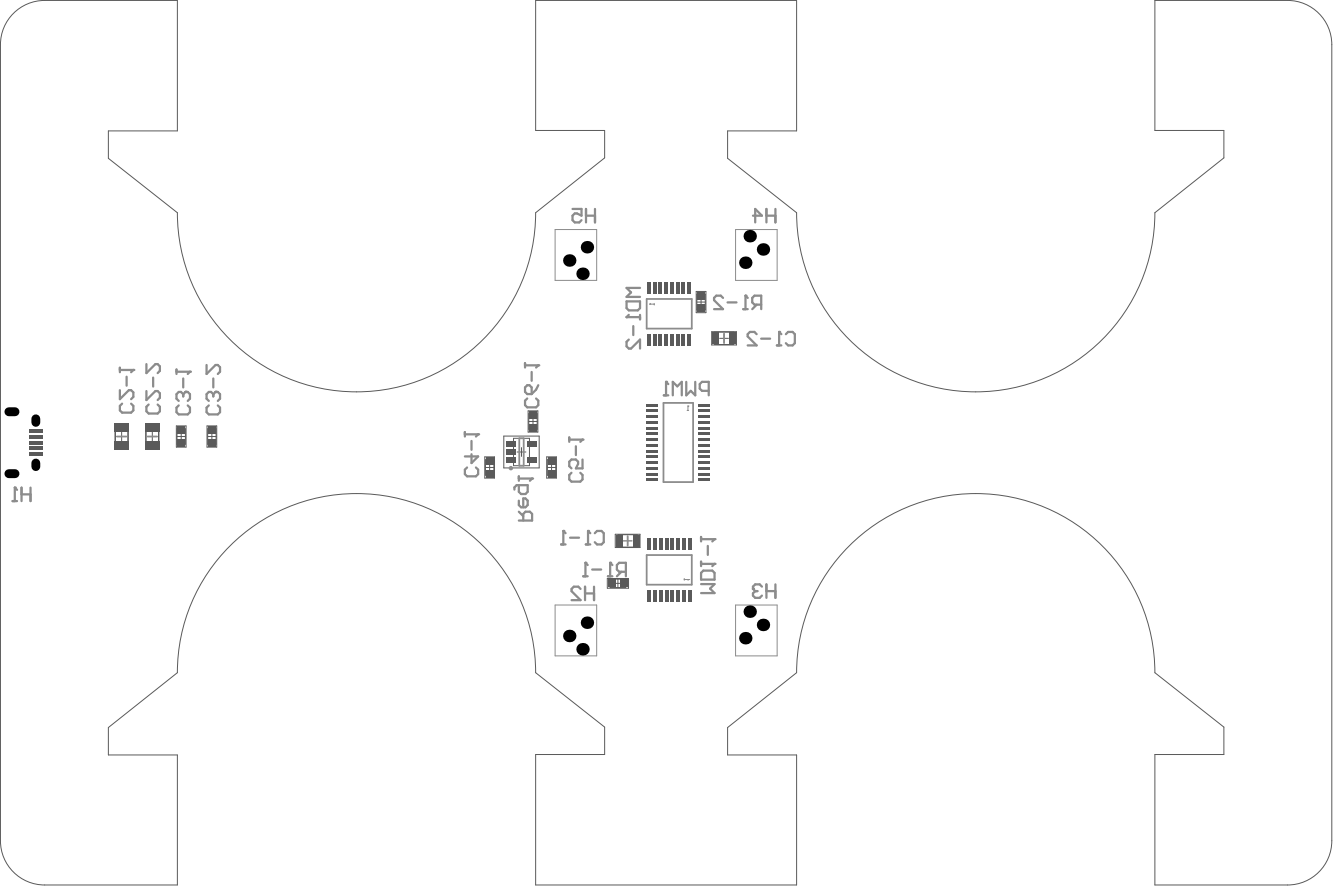
[picture p108: page 2]

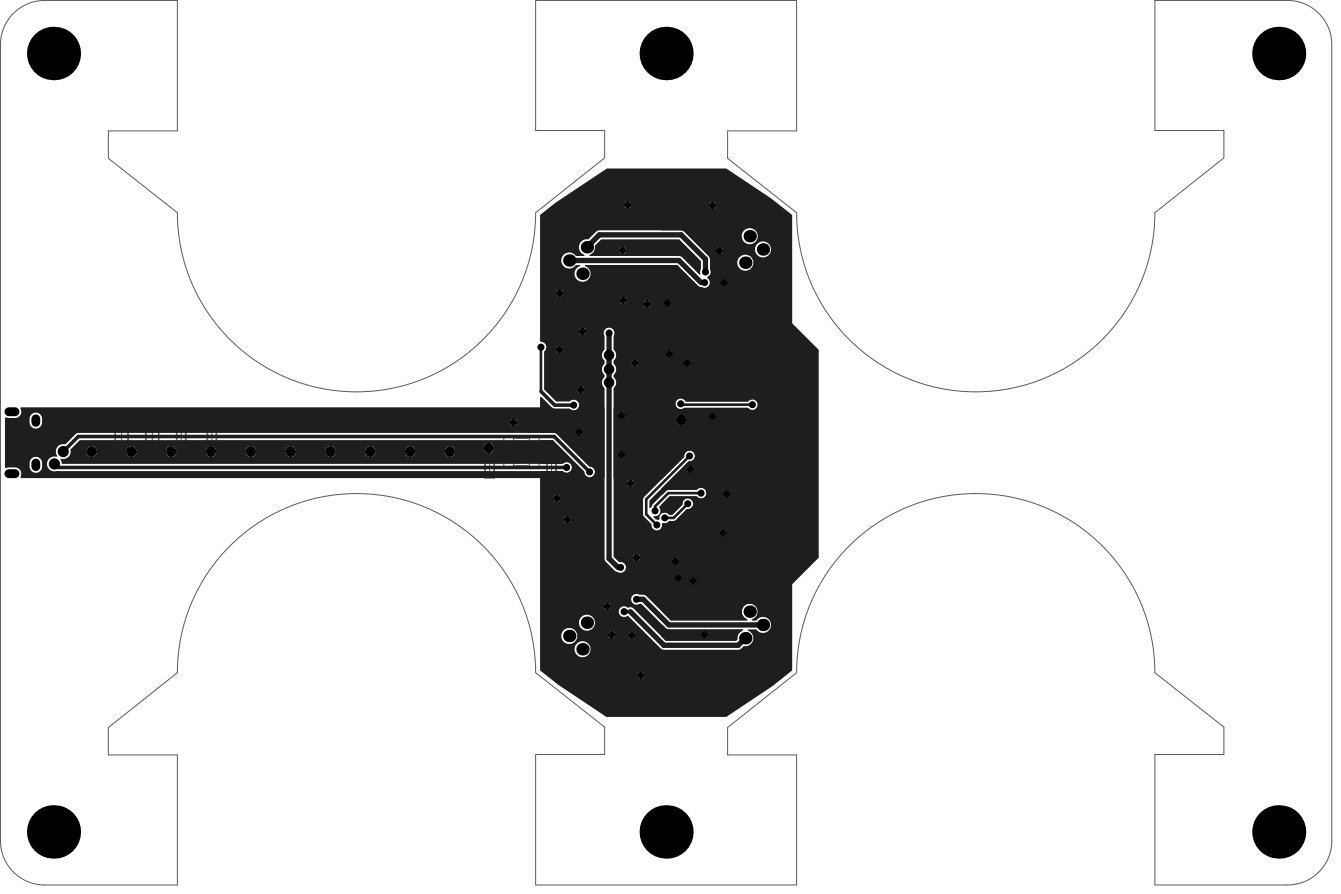
[picture p109: page 3]

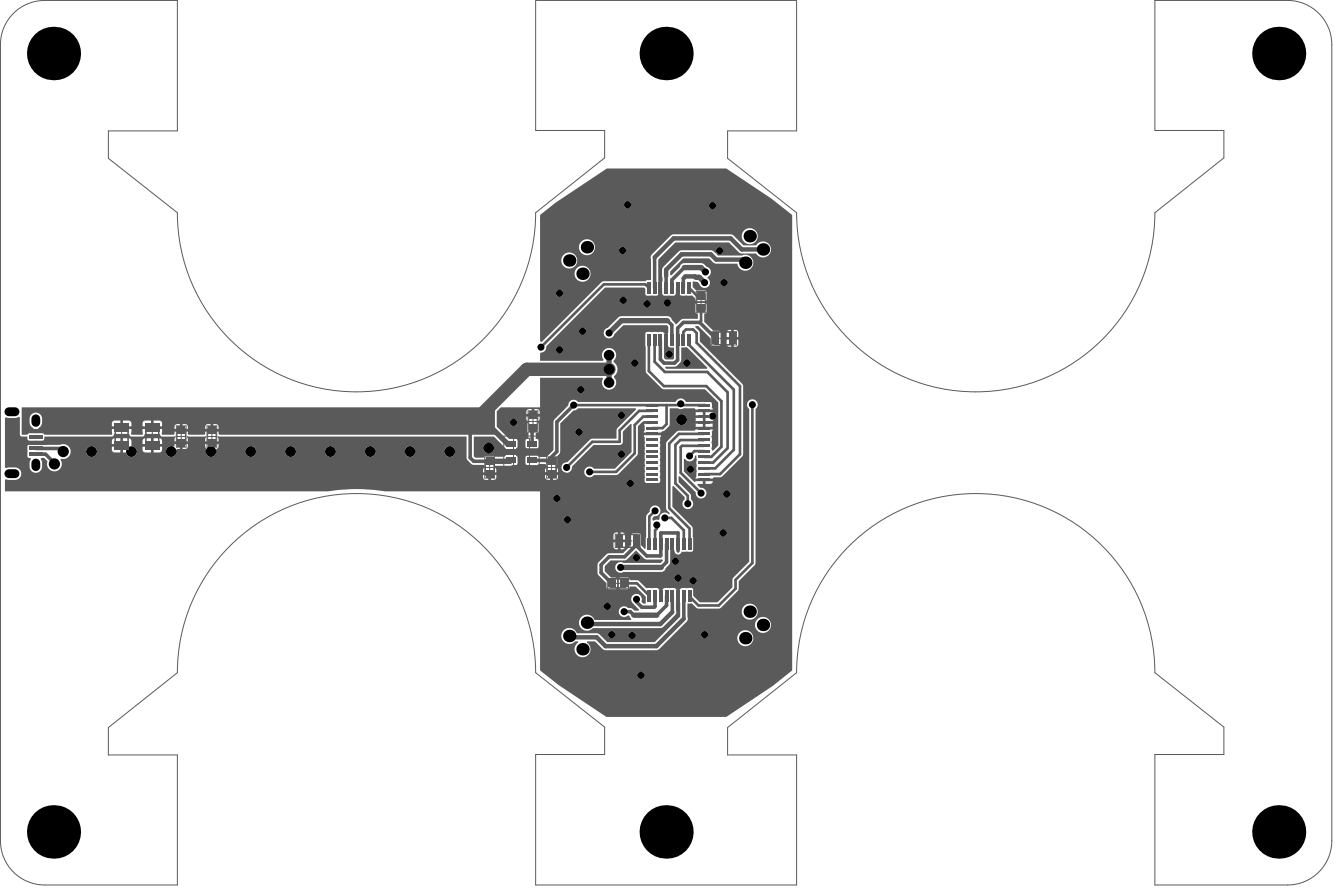
[picture p110: page 4]

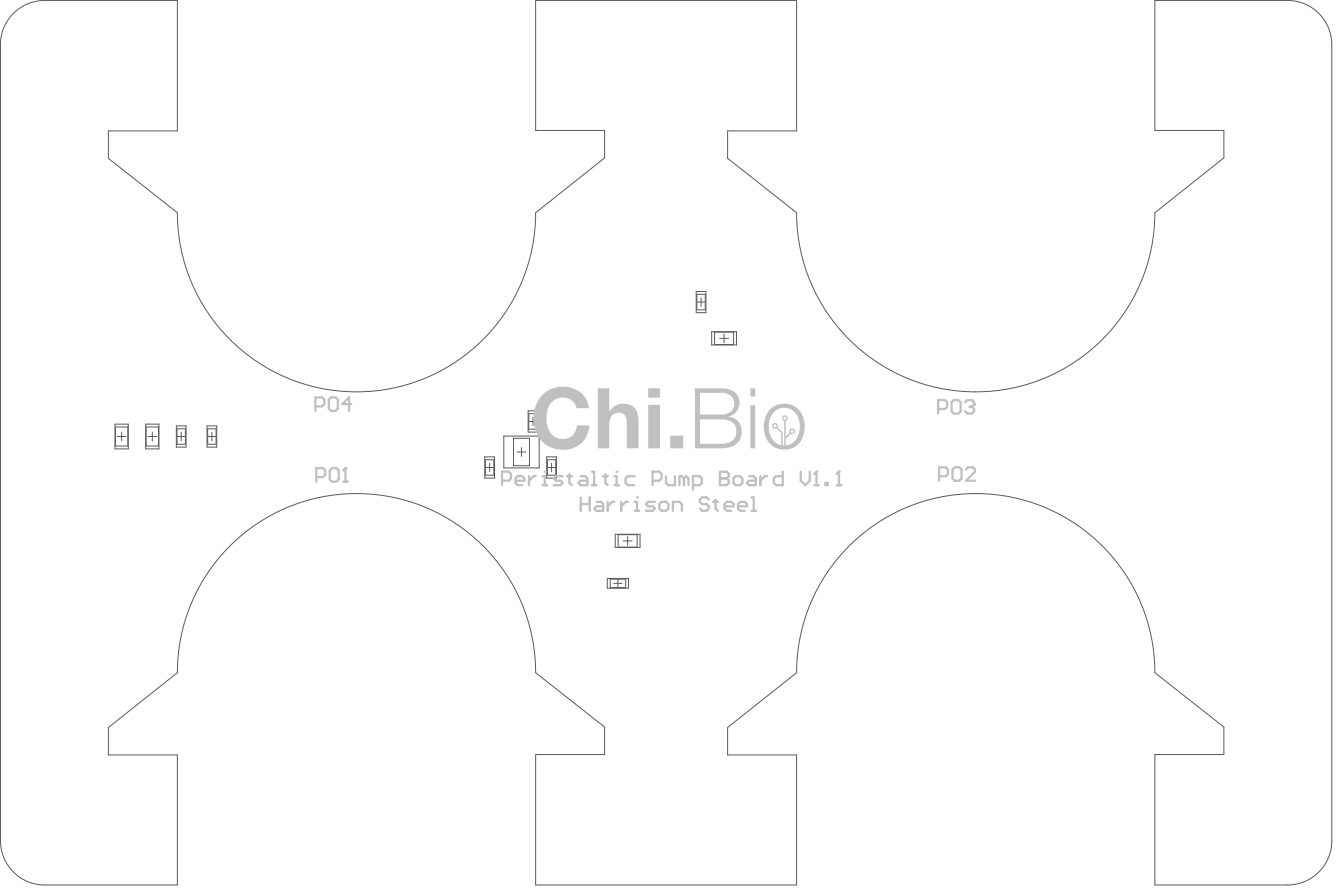
[picture p111: page 5]

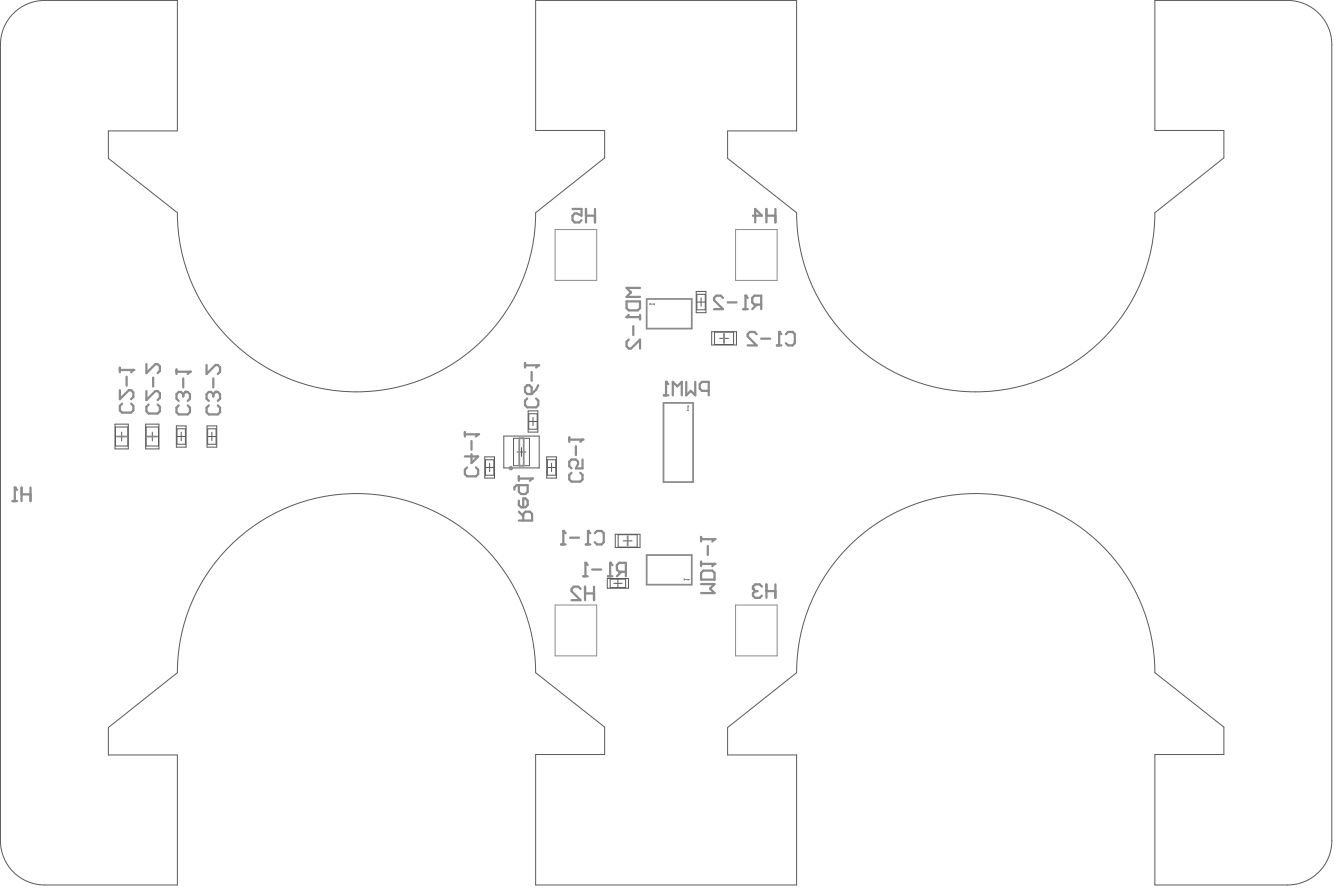
[picture p112: page 6]

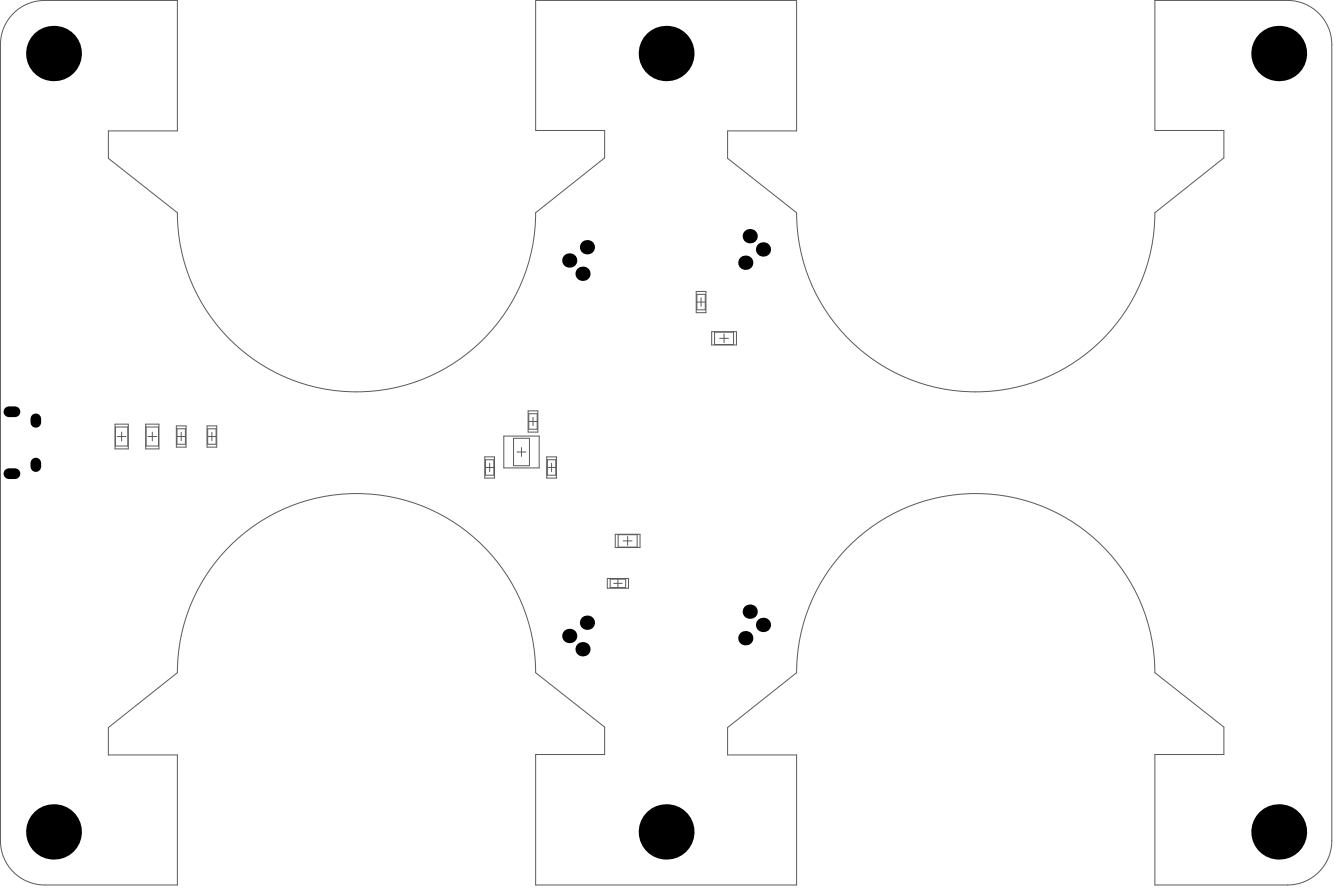
[picture p113: page 7]

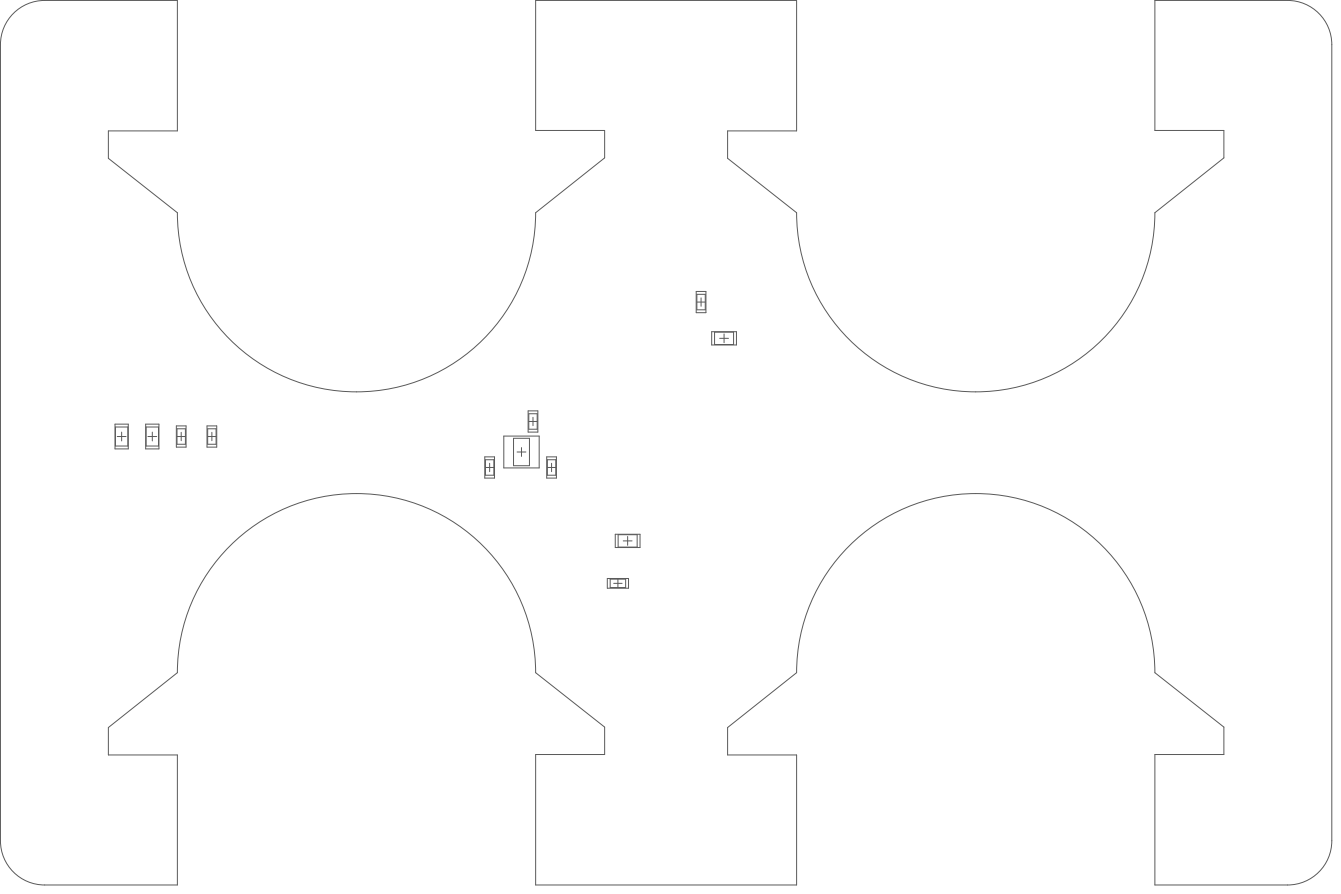
[picture p114: page 8]

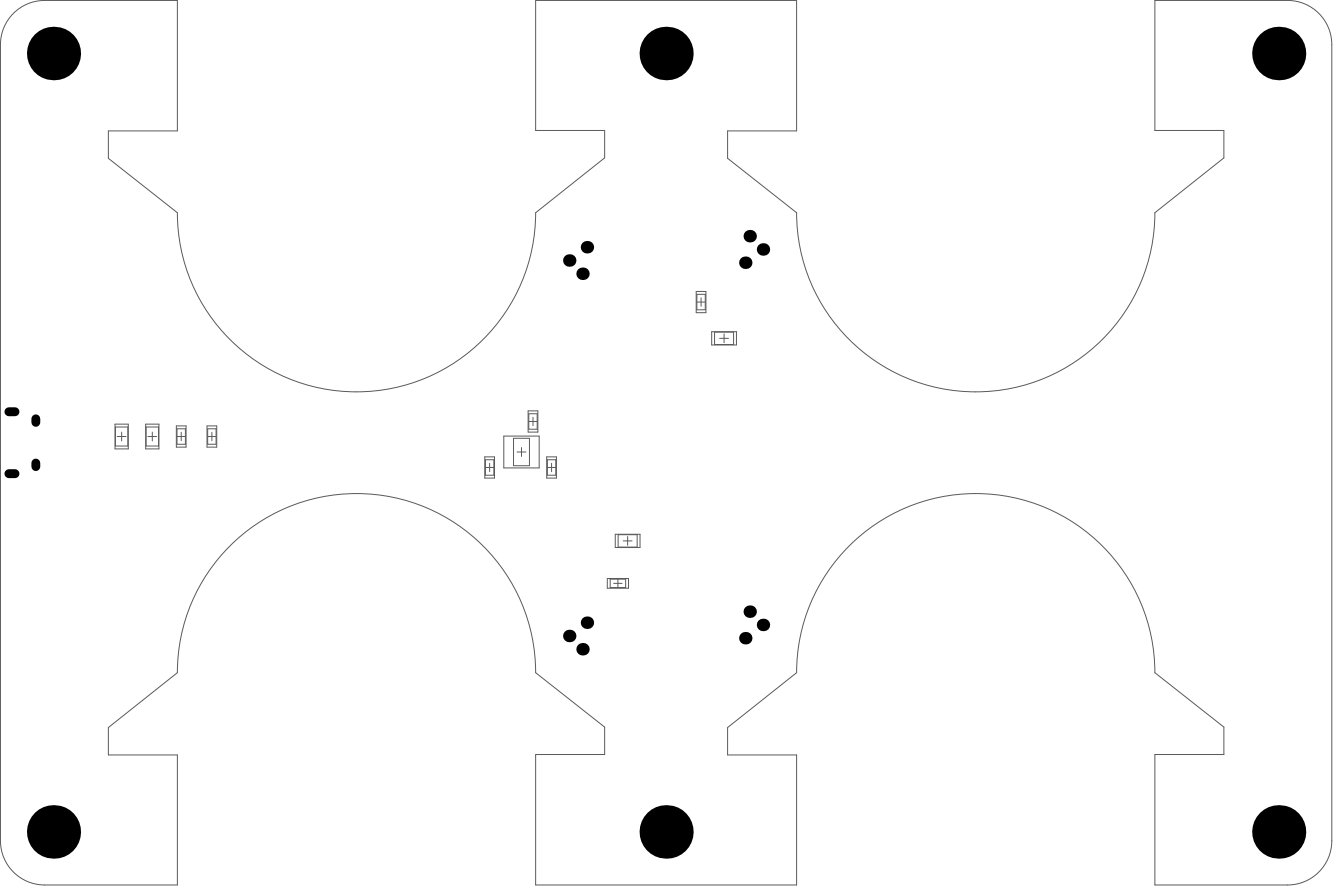
[picture p115: page 11]

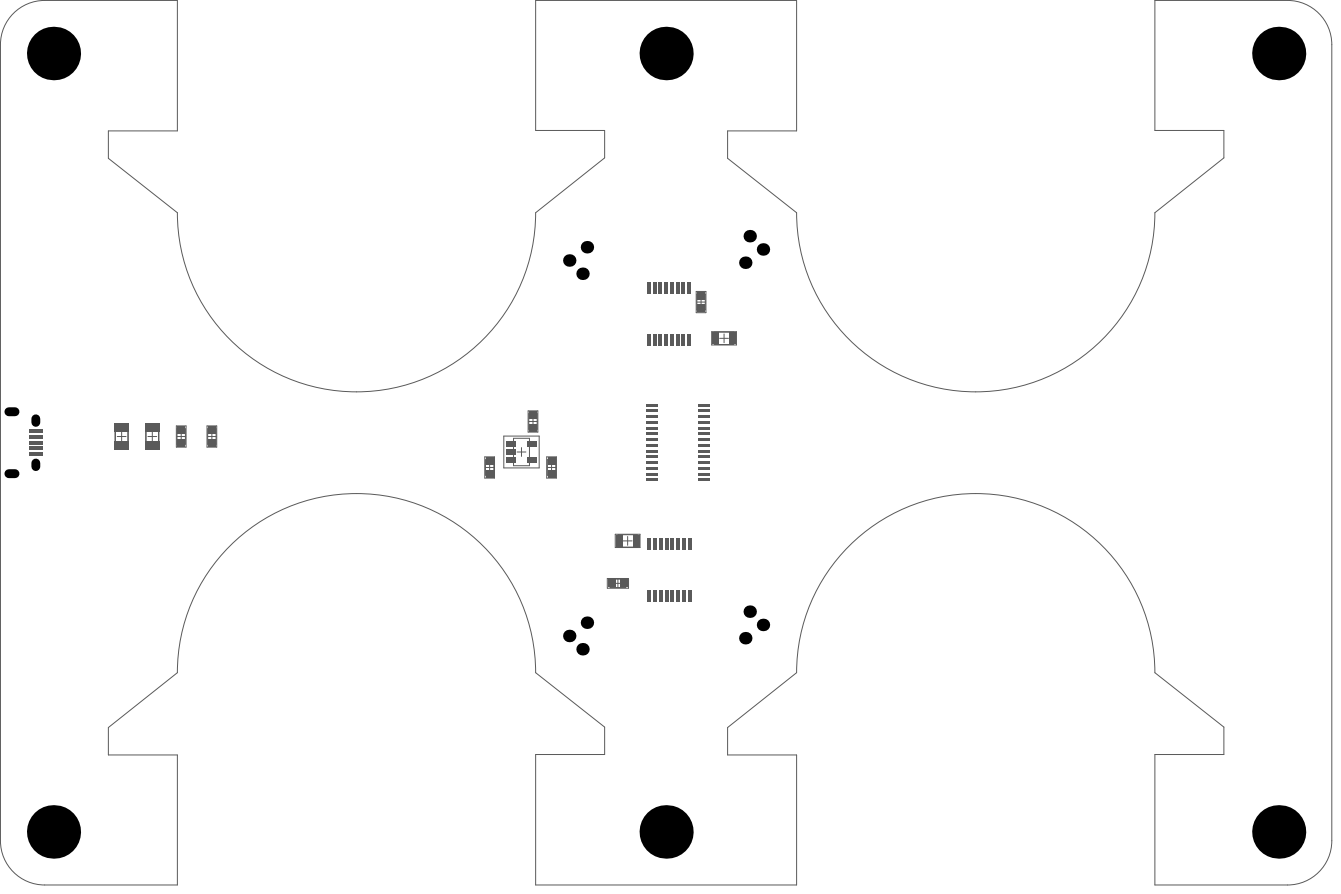
[picture p116: page 12]

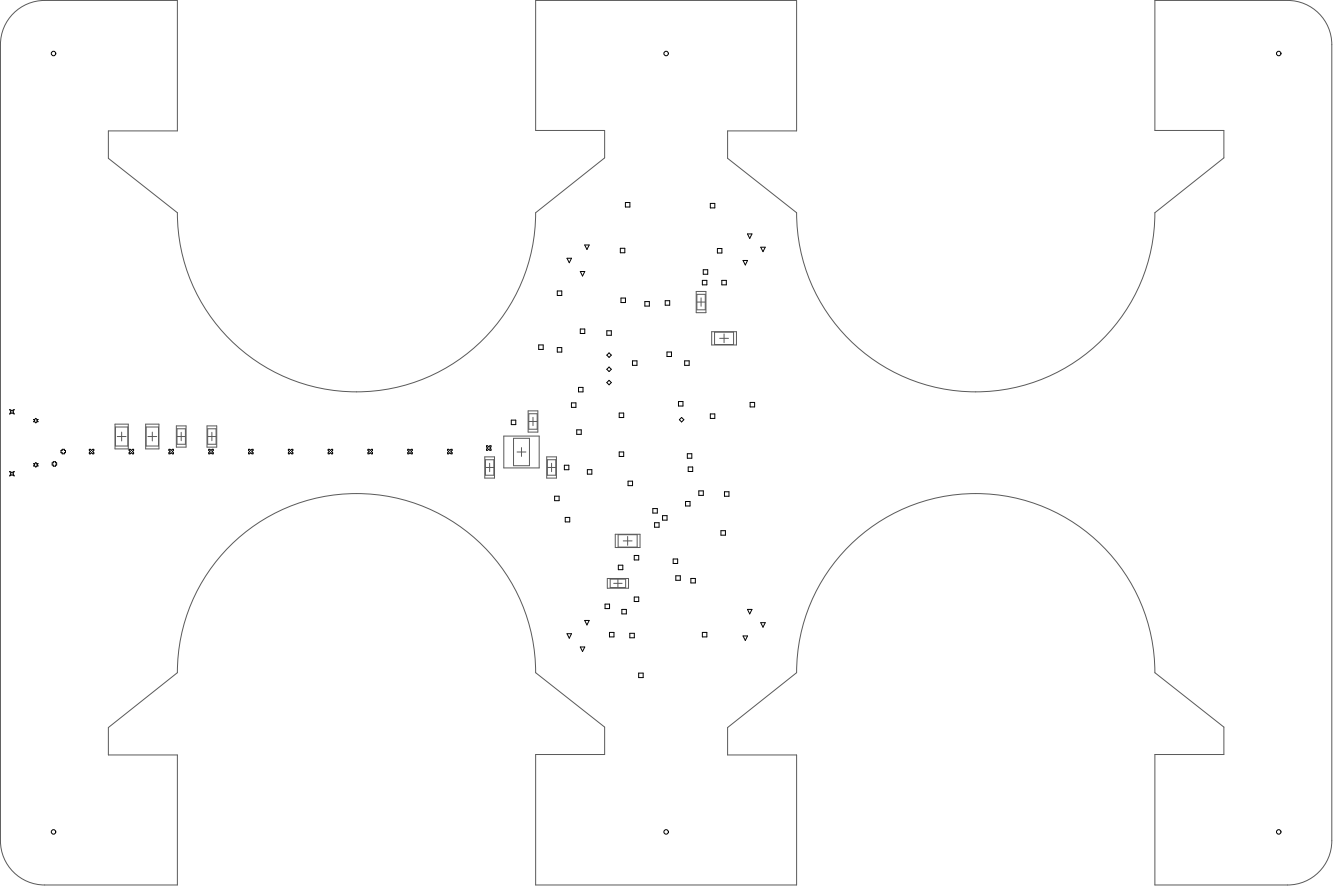
[picture p117: page 13]

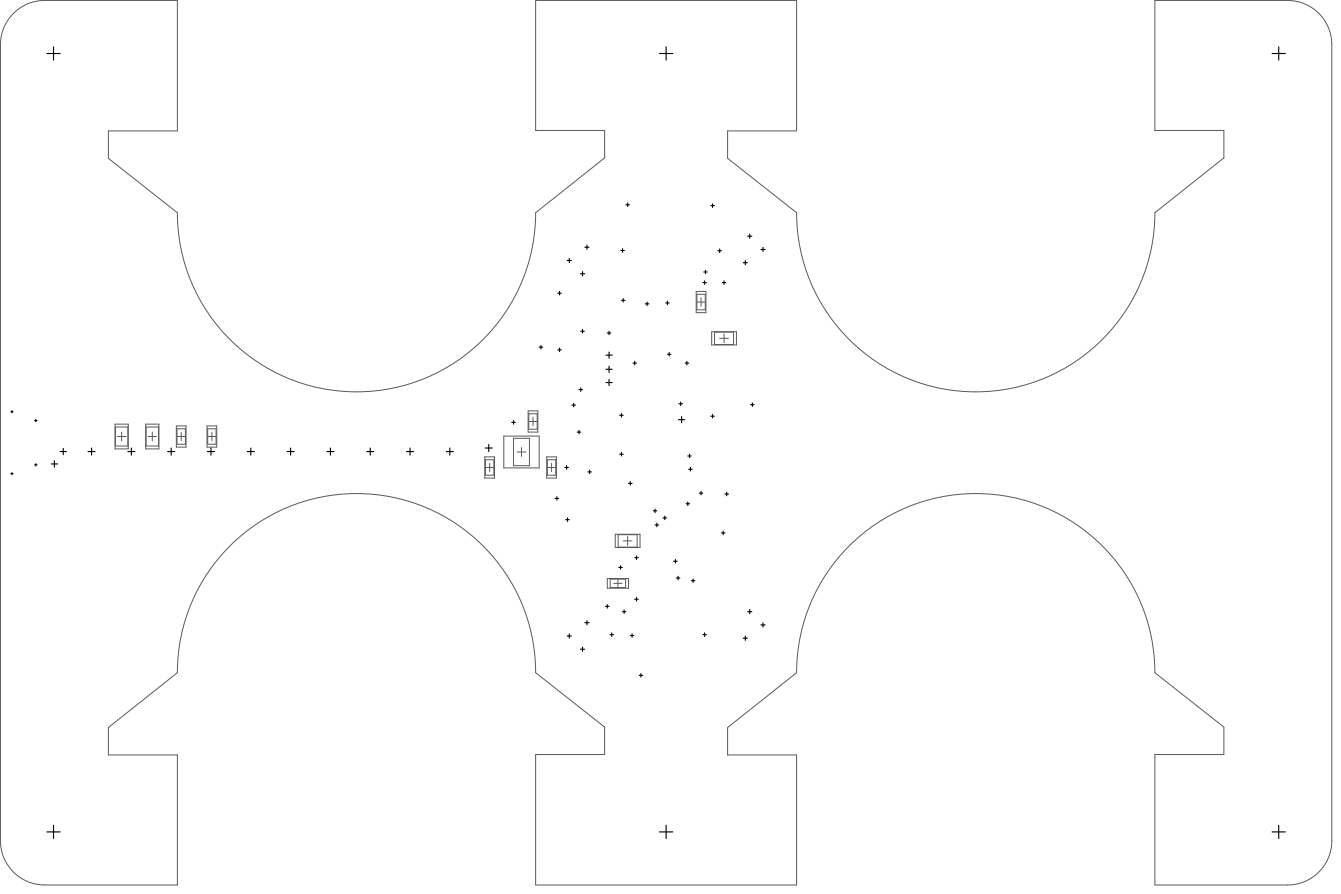
[picture p118: page 14]
