hs280/chiBioAnalogue/hardware/baseline-digital/PCB Files/Assembly PCBs/SensorBreakoutAS7341/Job1.PDF

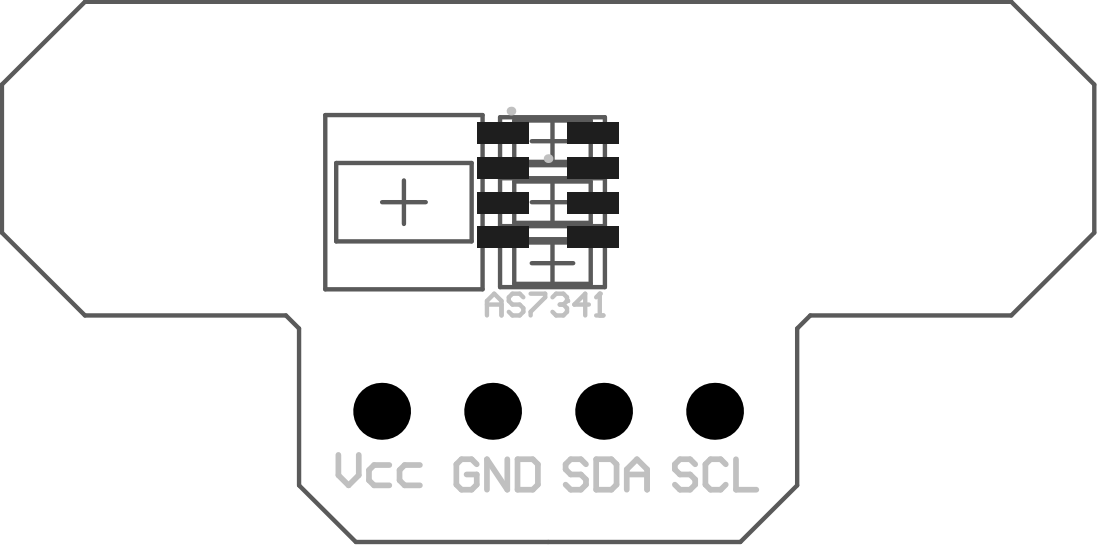
[picture p119: page 1]

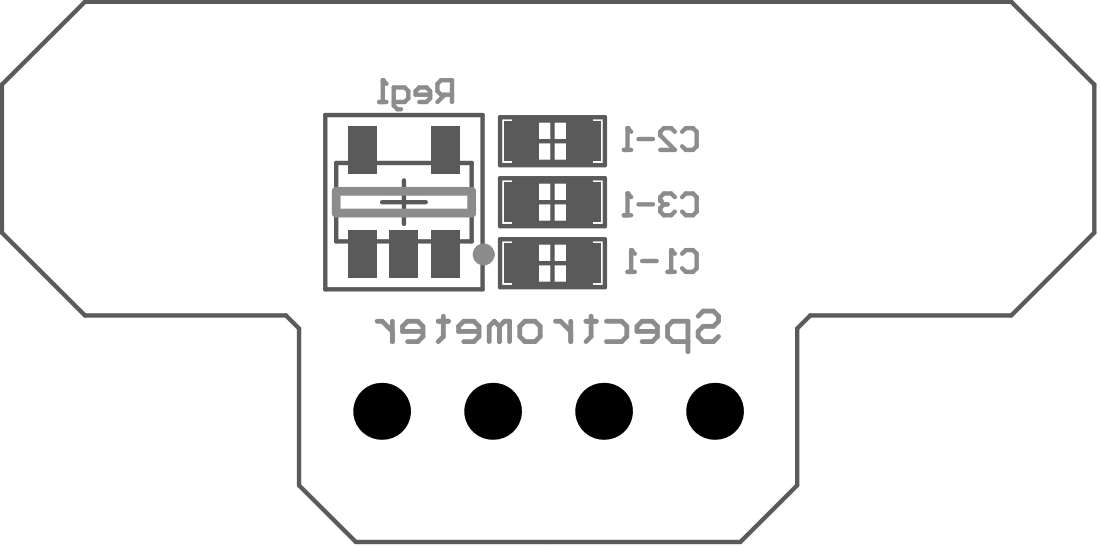
[picture p120: page 2]

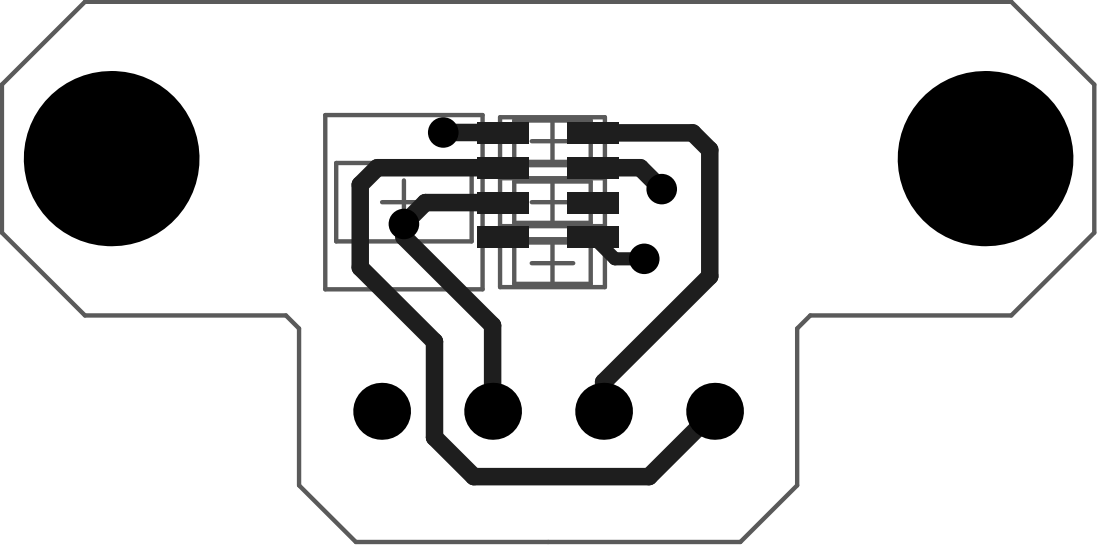
[picture p121: page 3]

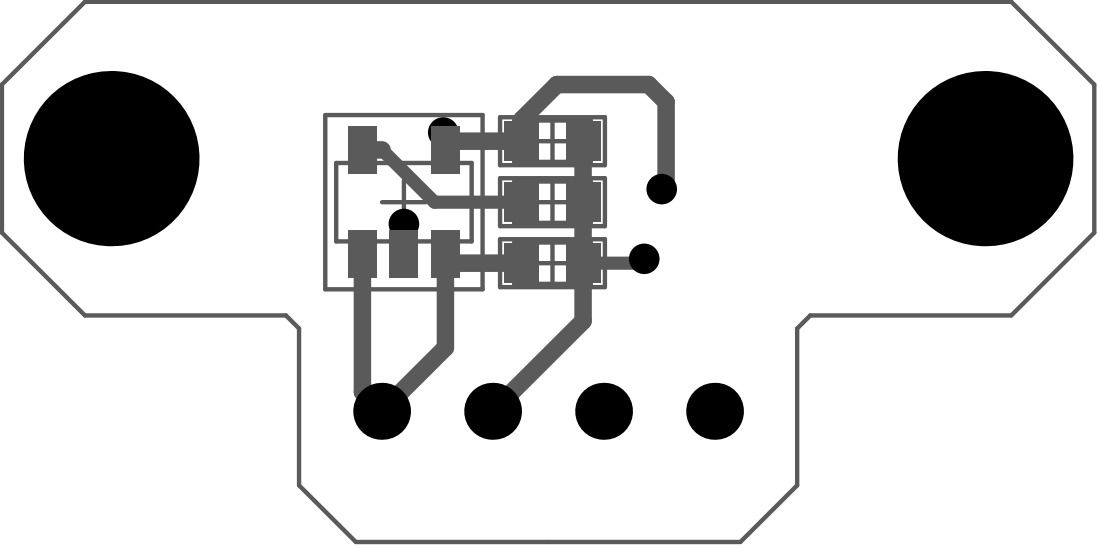
[picture p122: page 4]

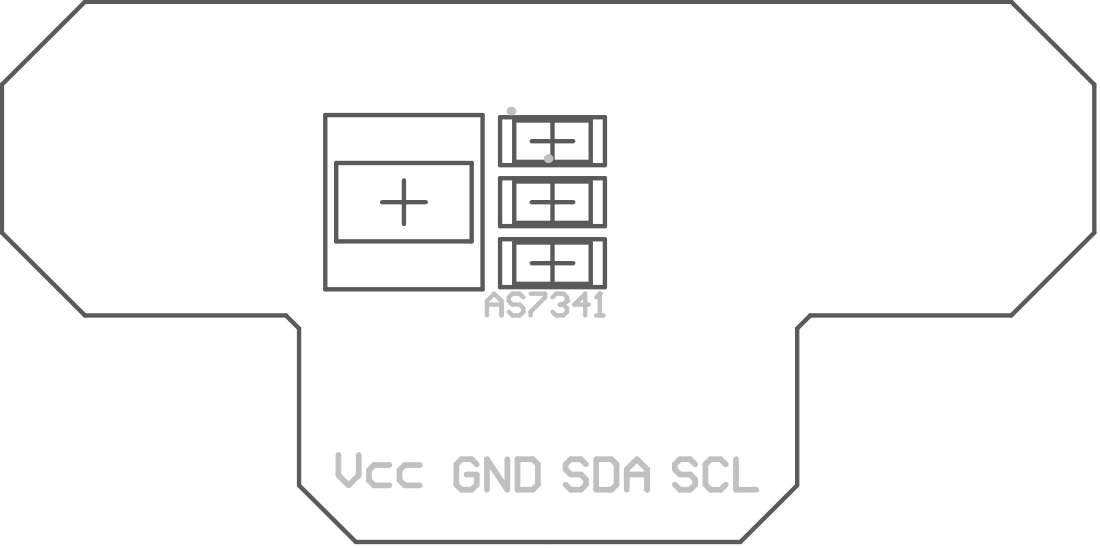
[picture p123: page 5]

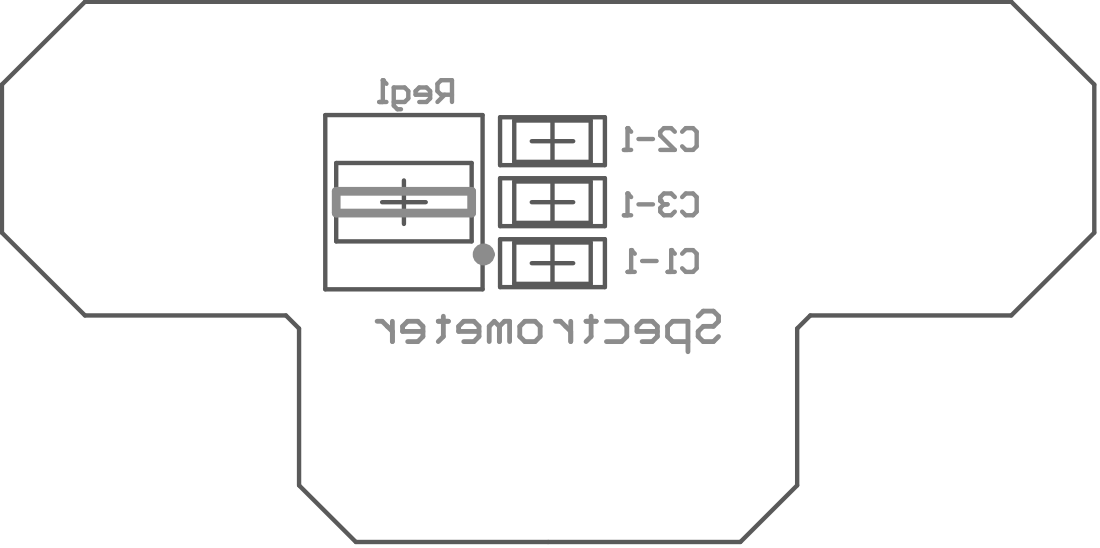
[picture p124: page 6]

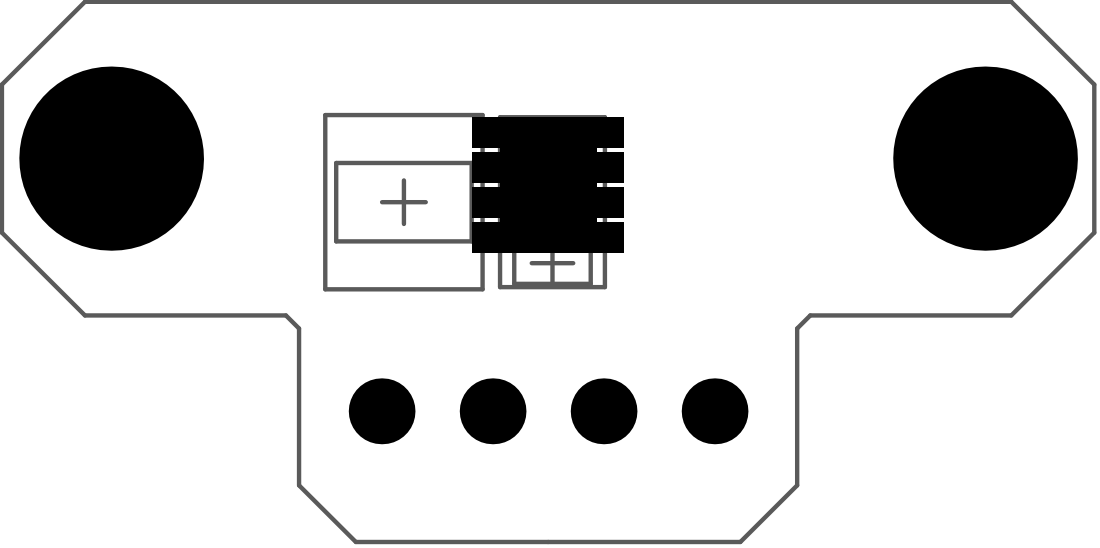
[picture p125: page 7]

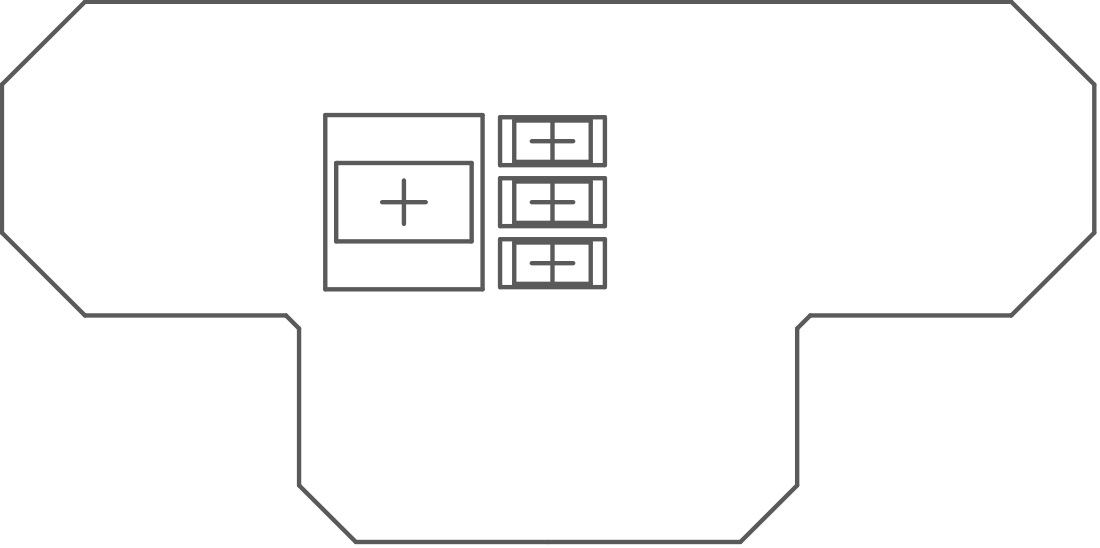
[picture p126: page 8]

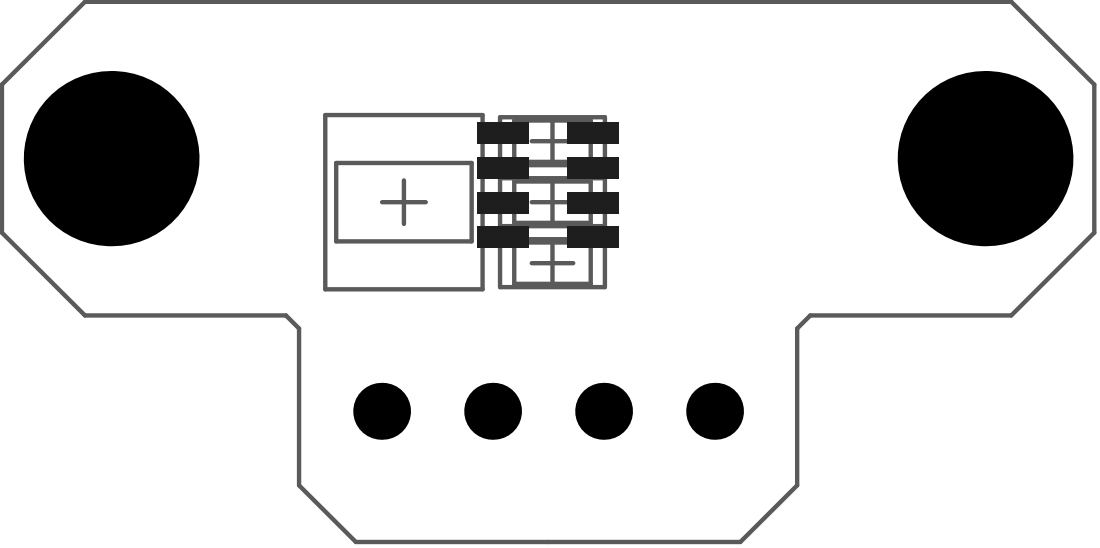
[picture p127: page 11]

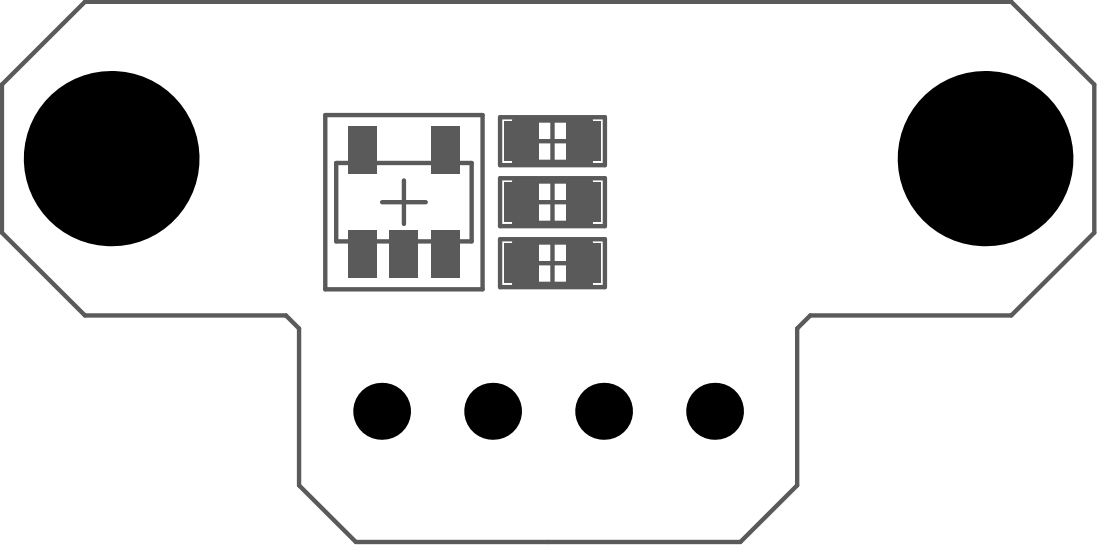
[picture p128: page 12]

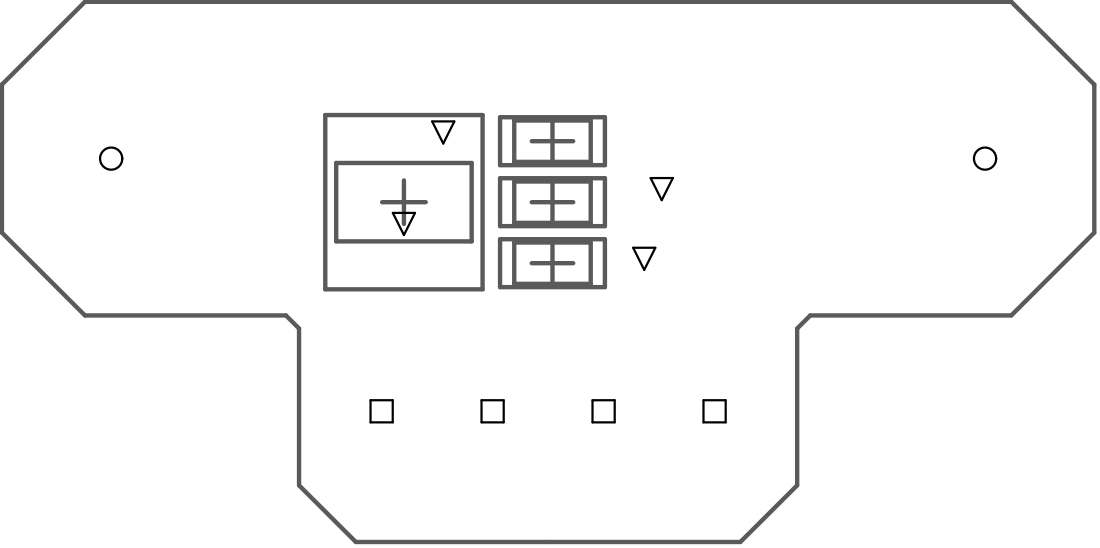
[picture p129: page 13]

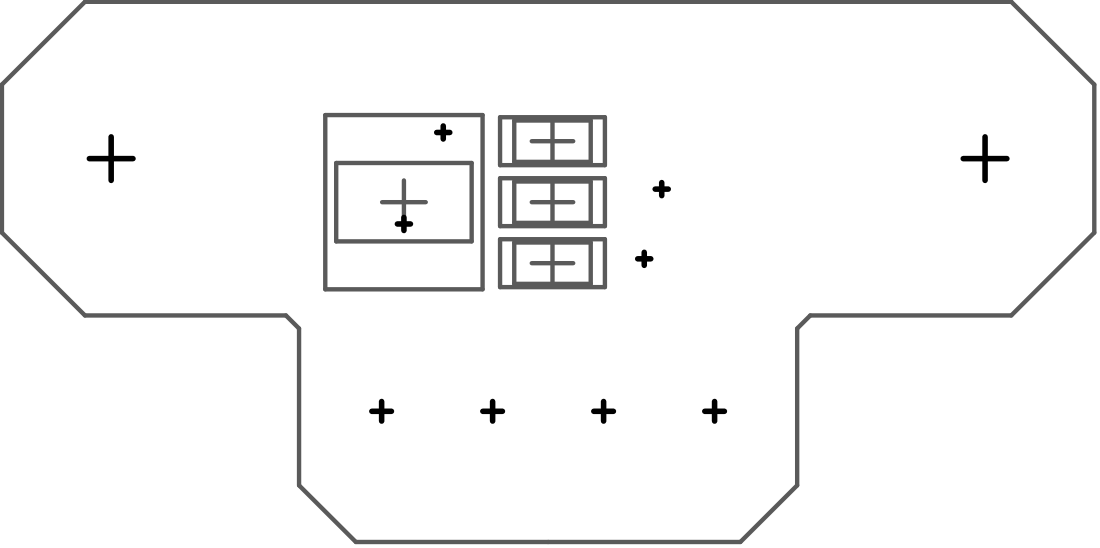
[picture p130: page 14]
