hs280/chiBioAnalogue/hardware/baseline-digital/PCB Files/Assembly PCBs/Side/Job1.PDF

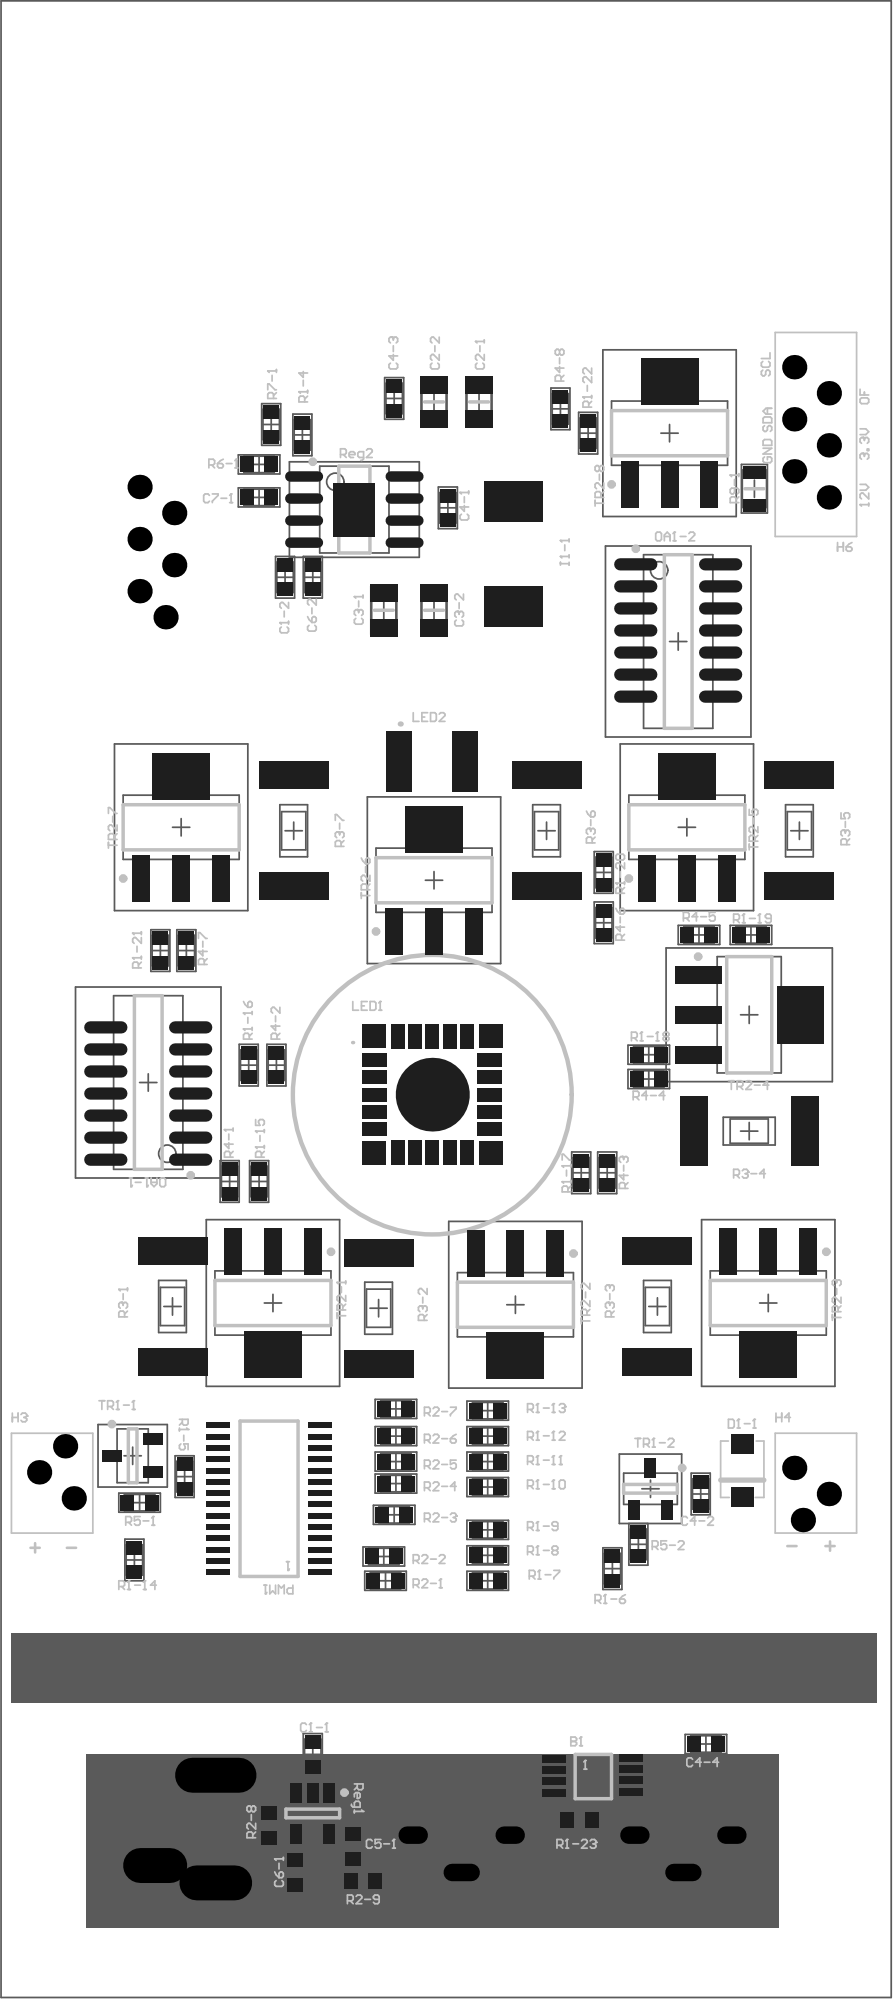
[picture p131: page 1]

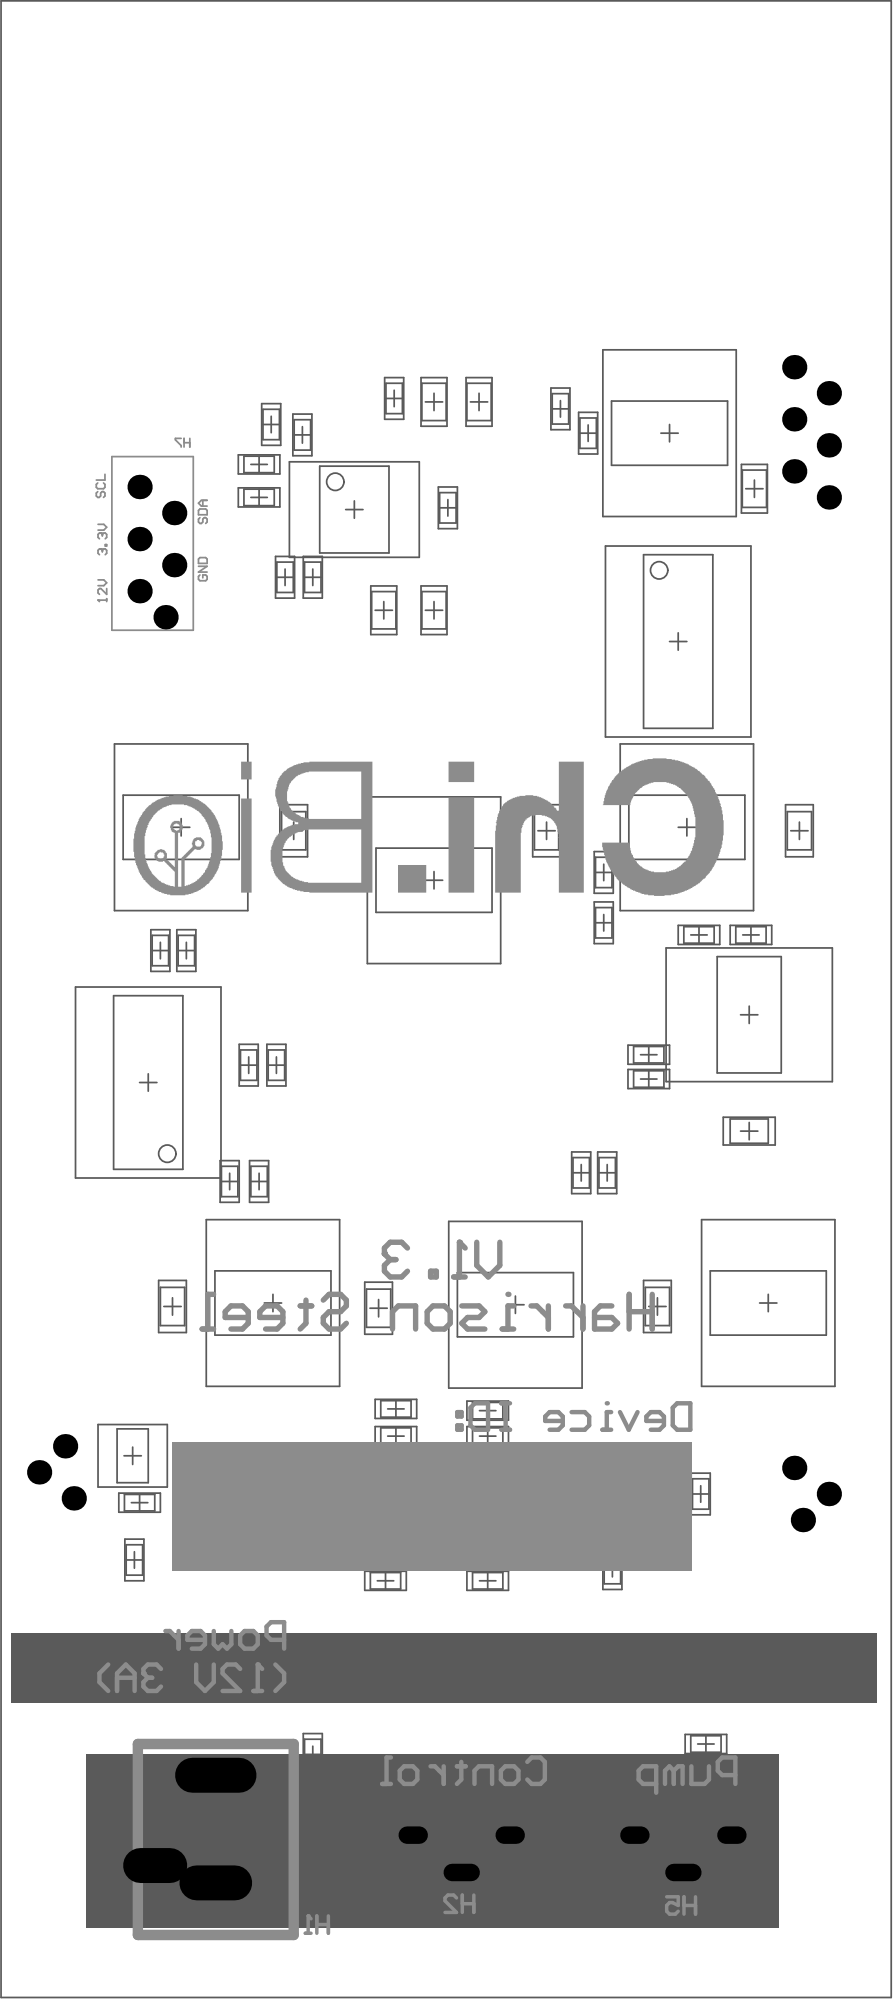
[picture p132: page 2]

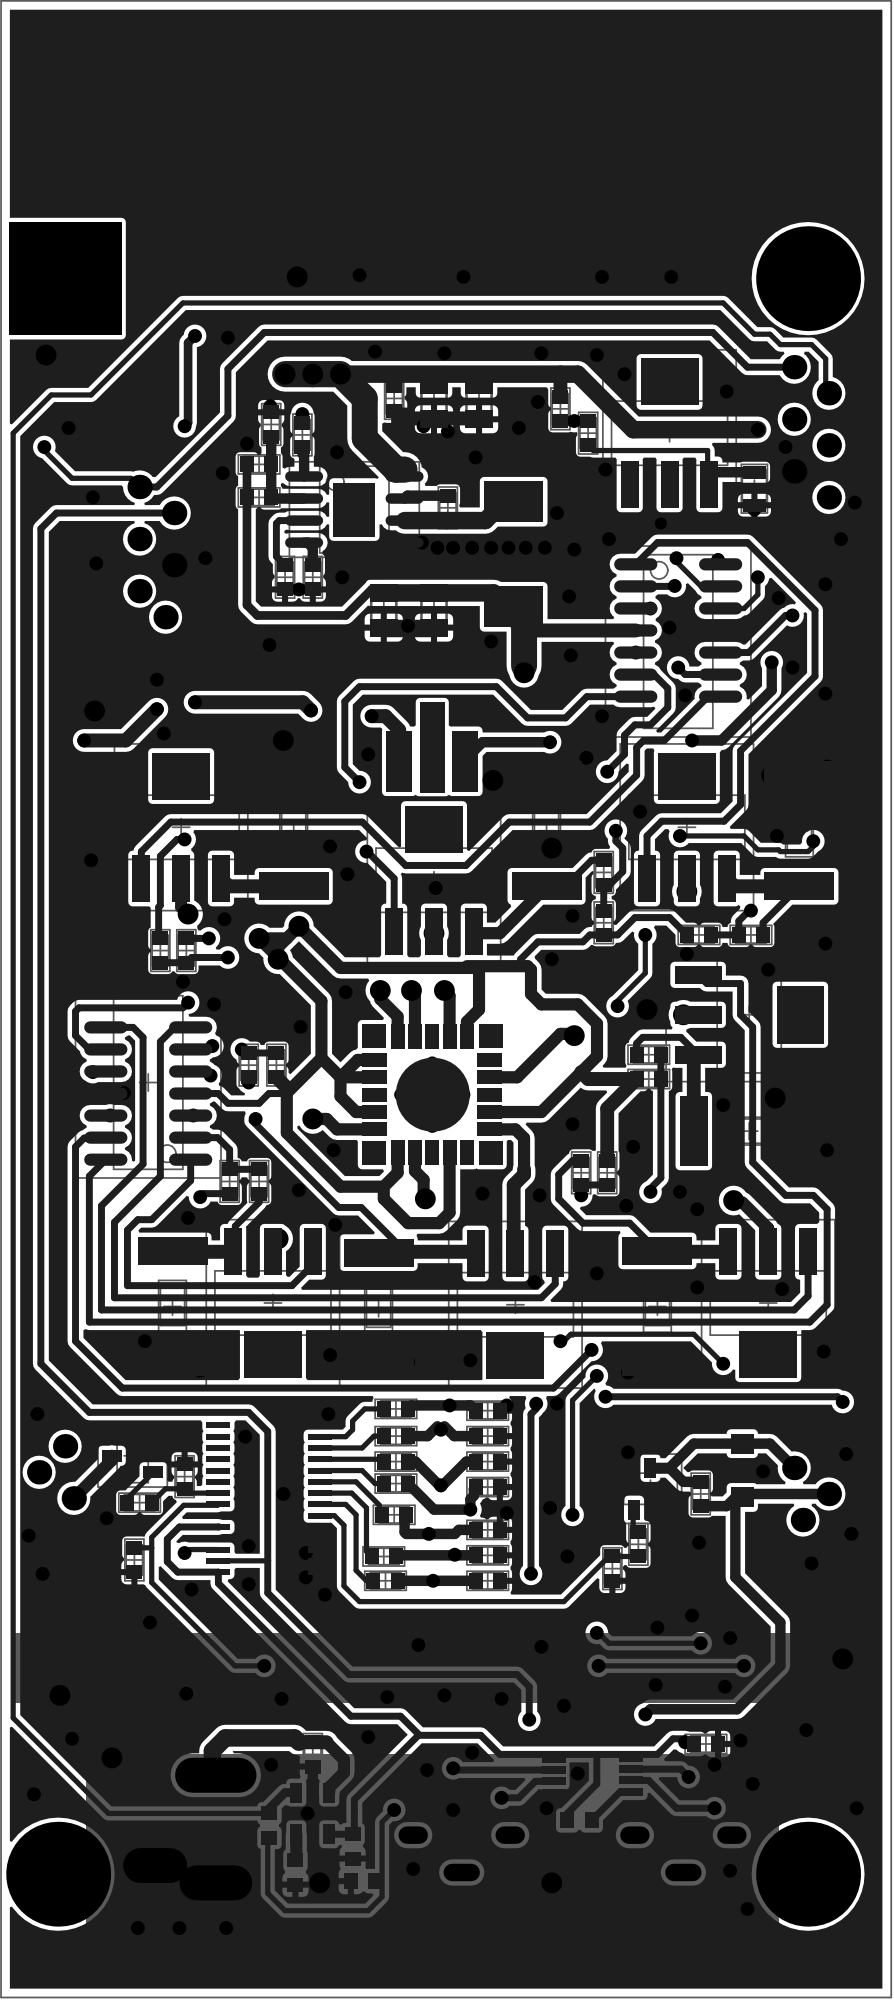
[picture p133: page 3]

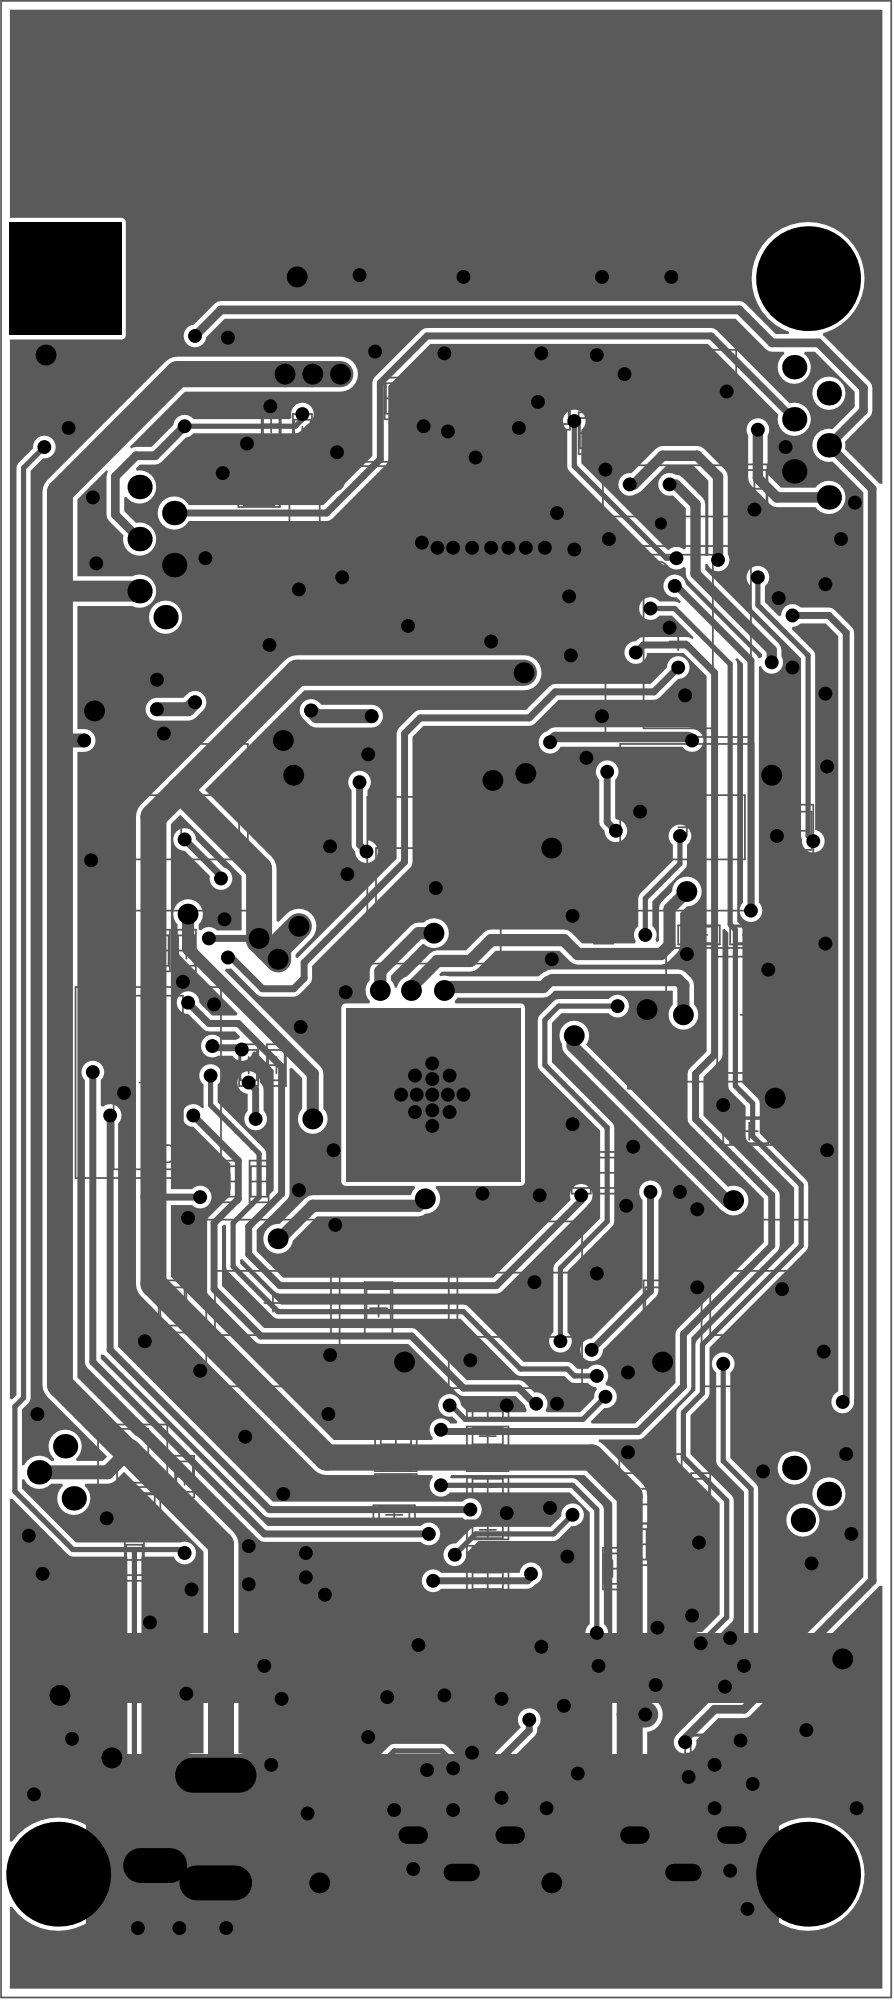
[picture p134: page 4]

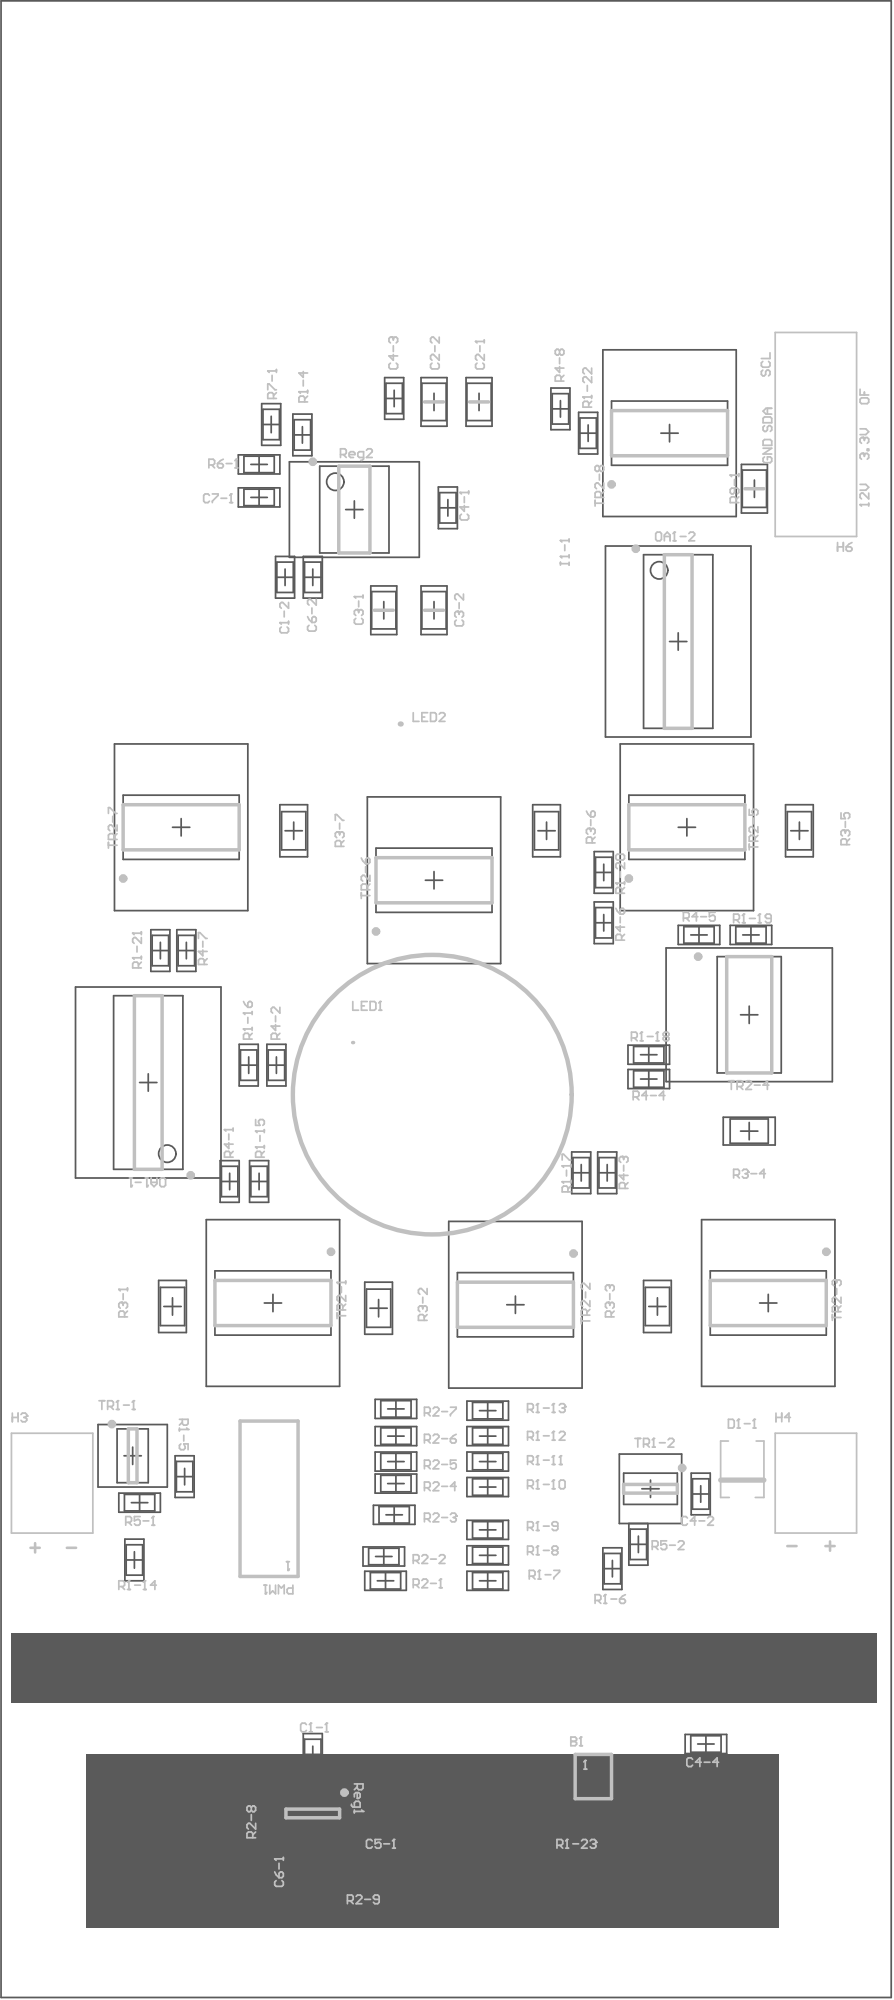
[picture p135: page 5]

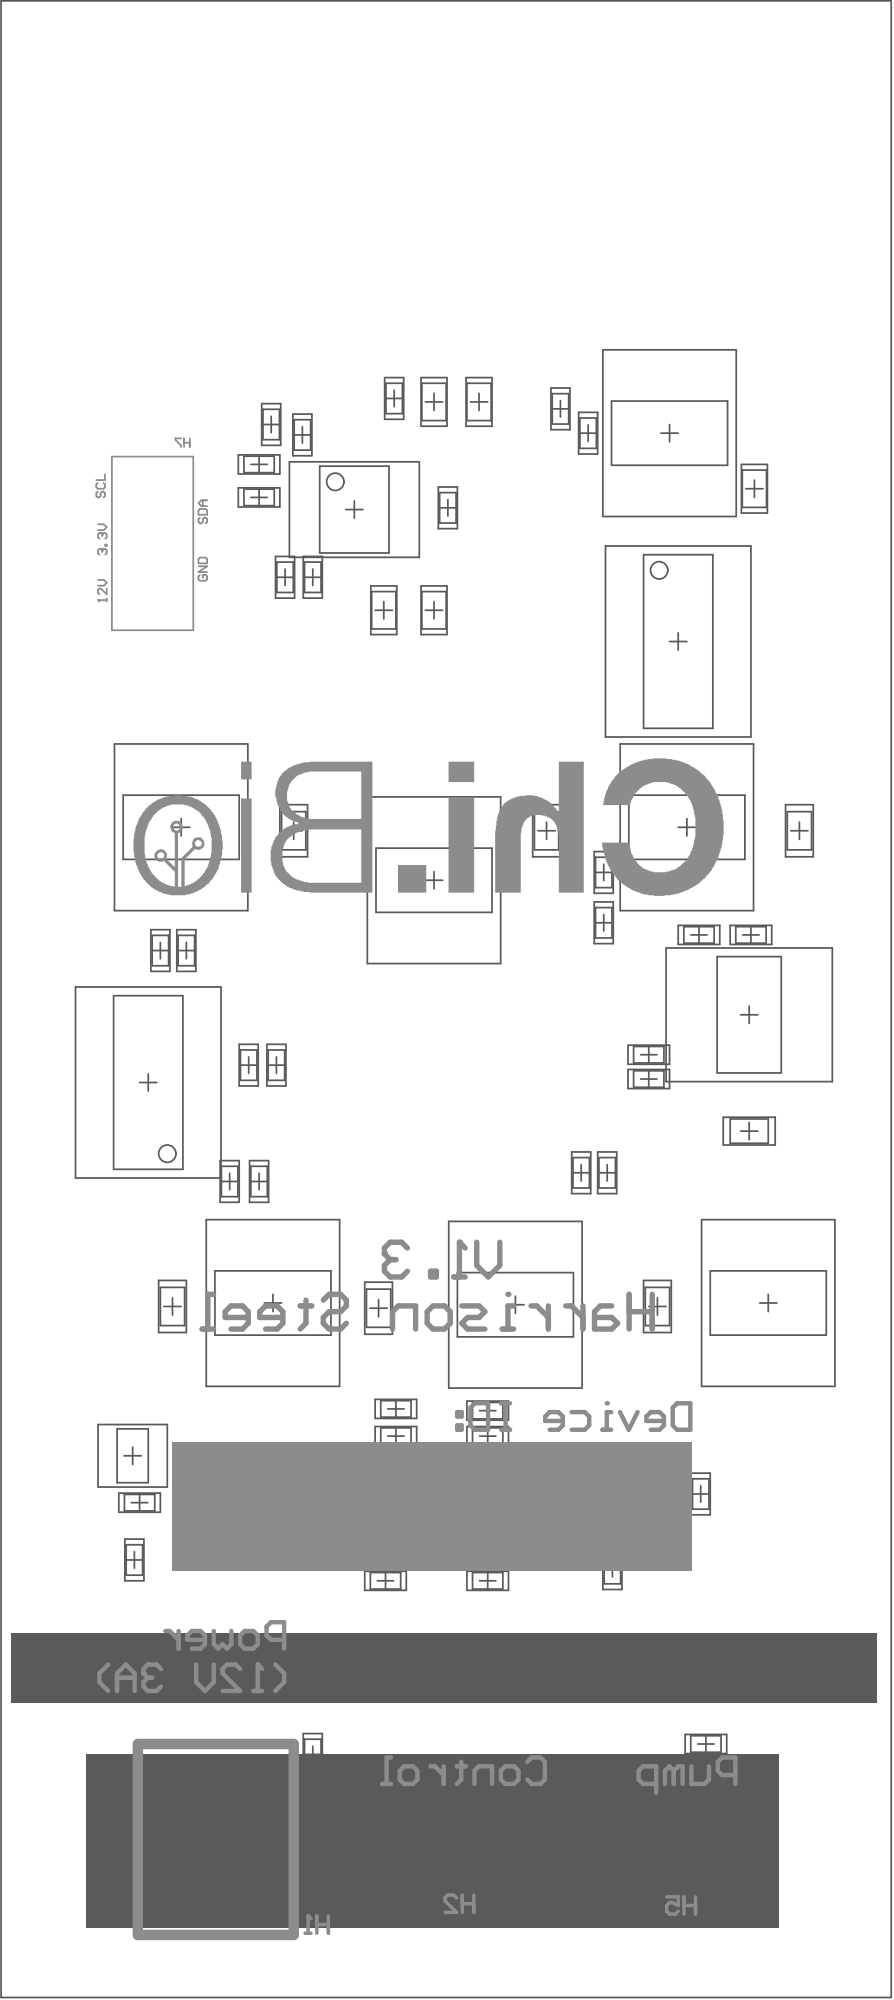
[picture p136: page 6]

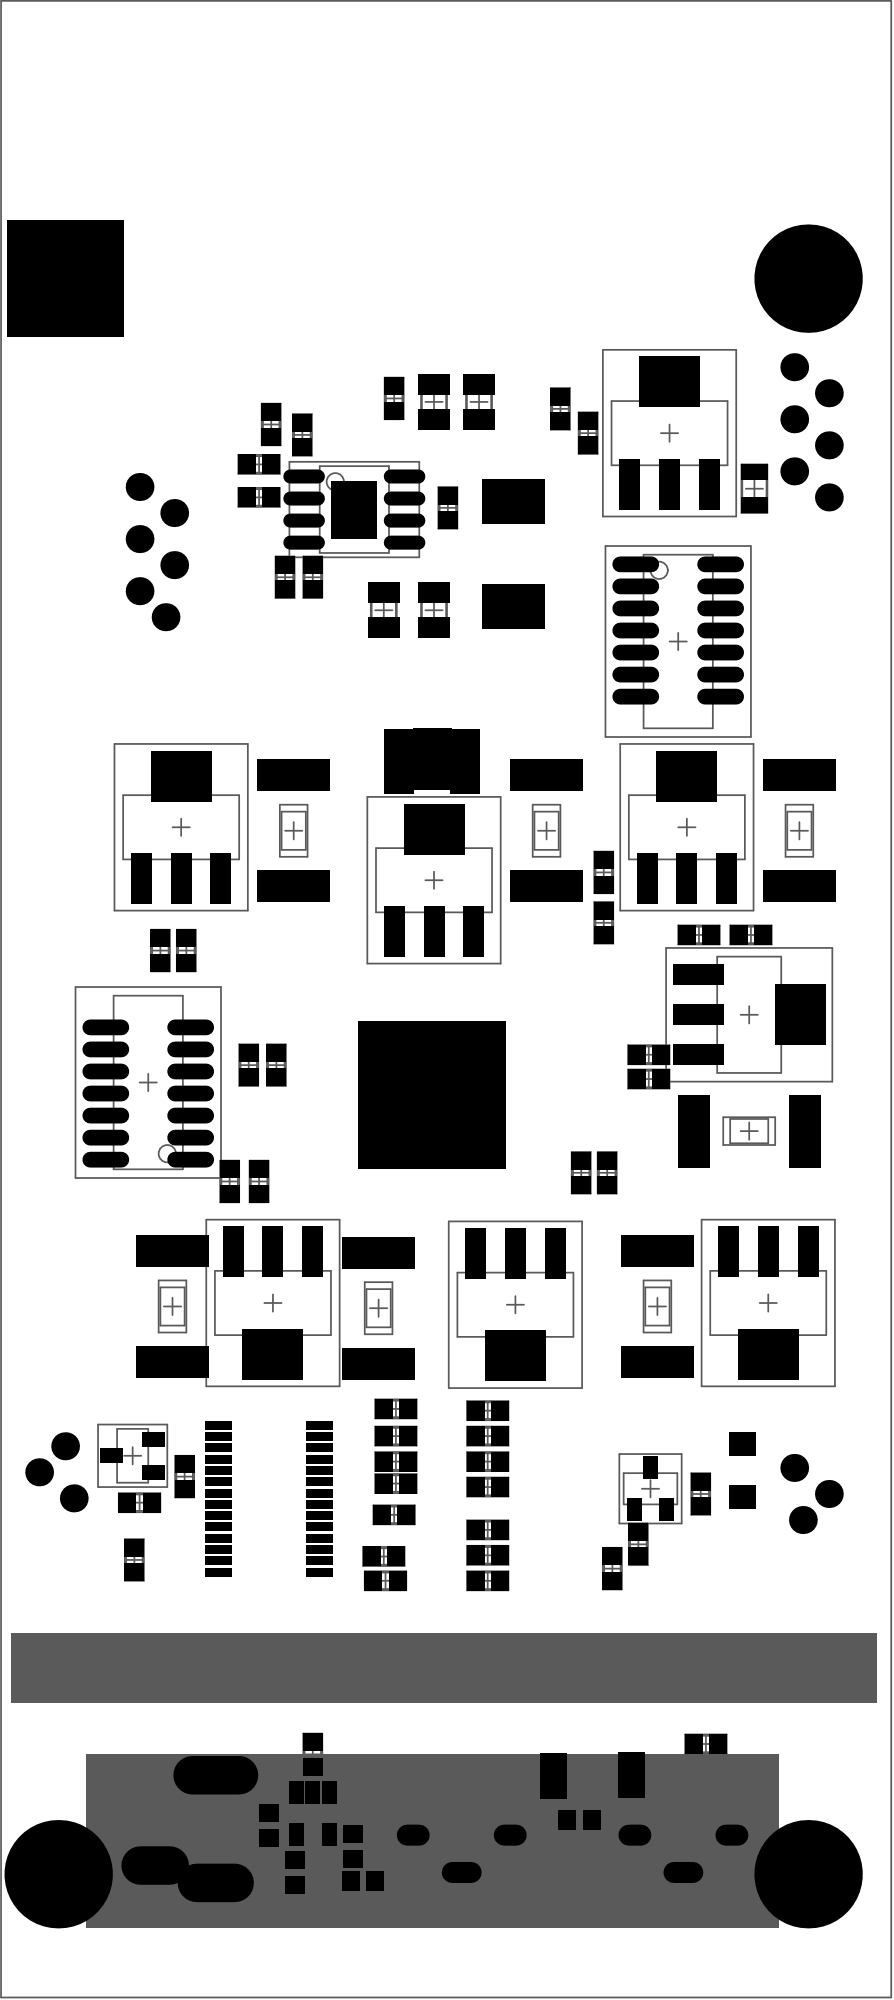
[picture p137: page 7]

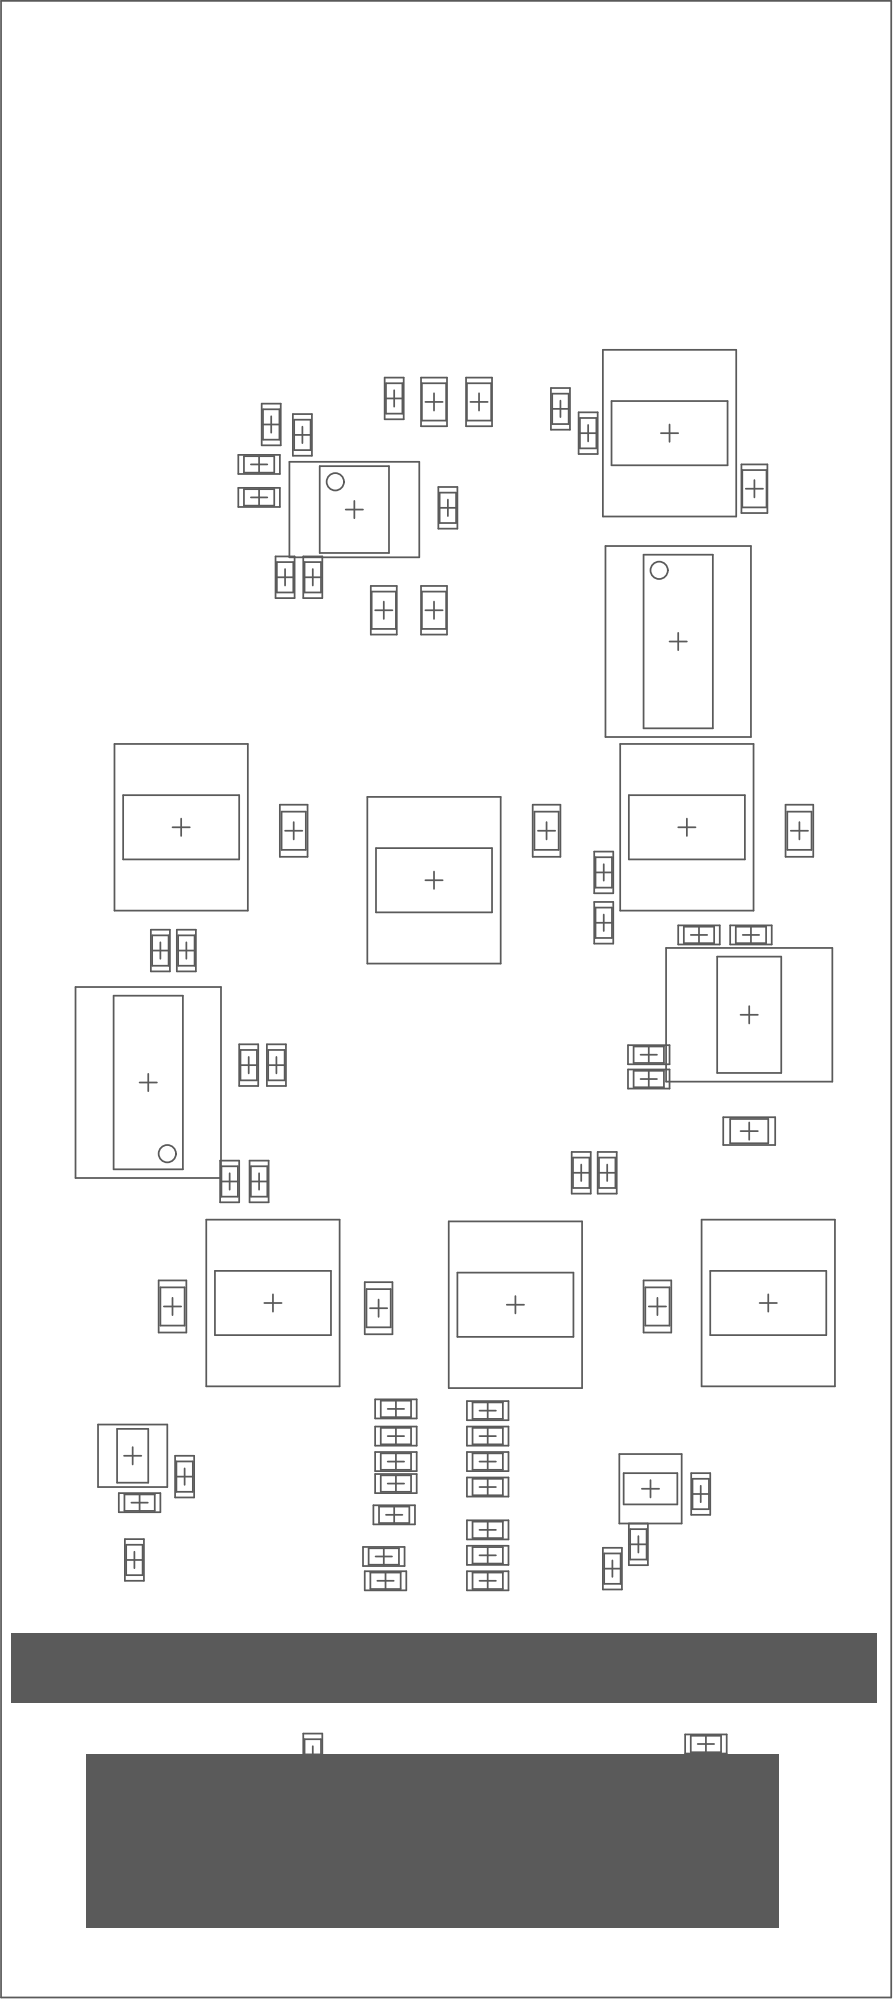
[picture p138: page 8]

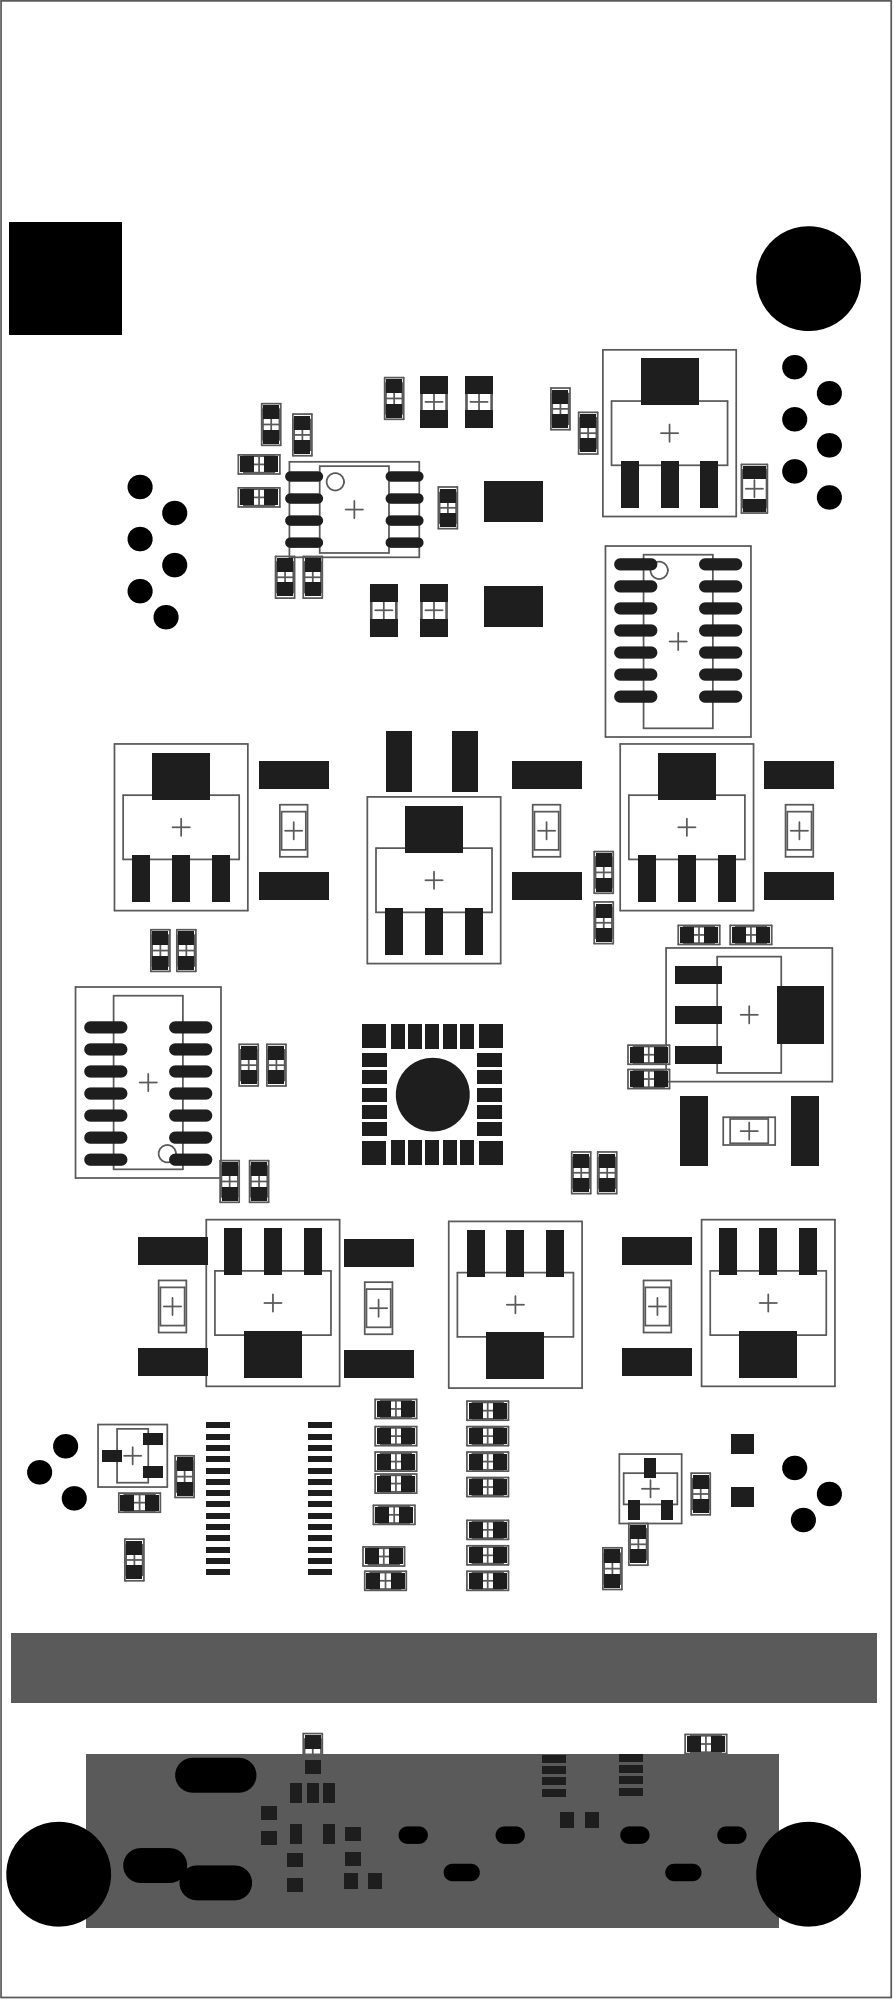
[picture p139: page 11]

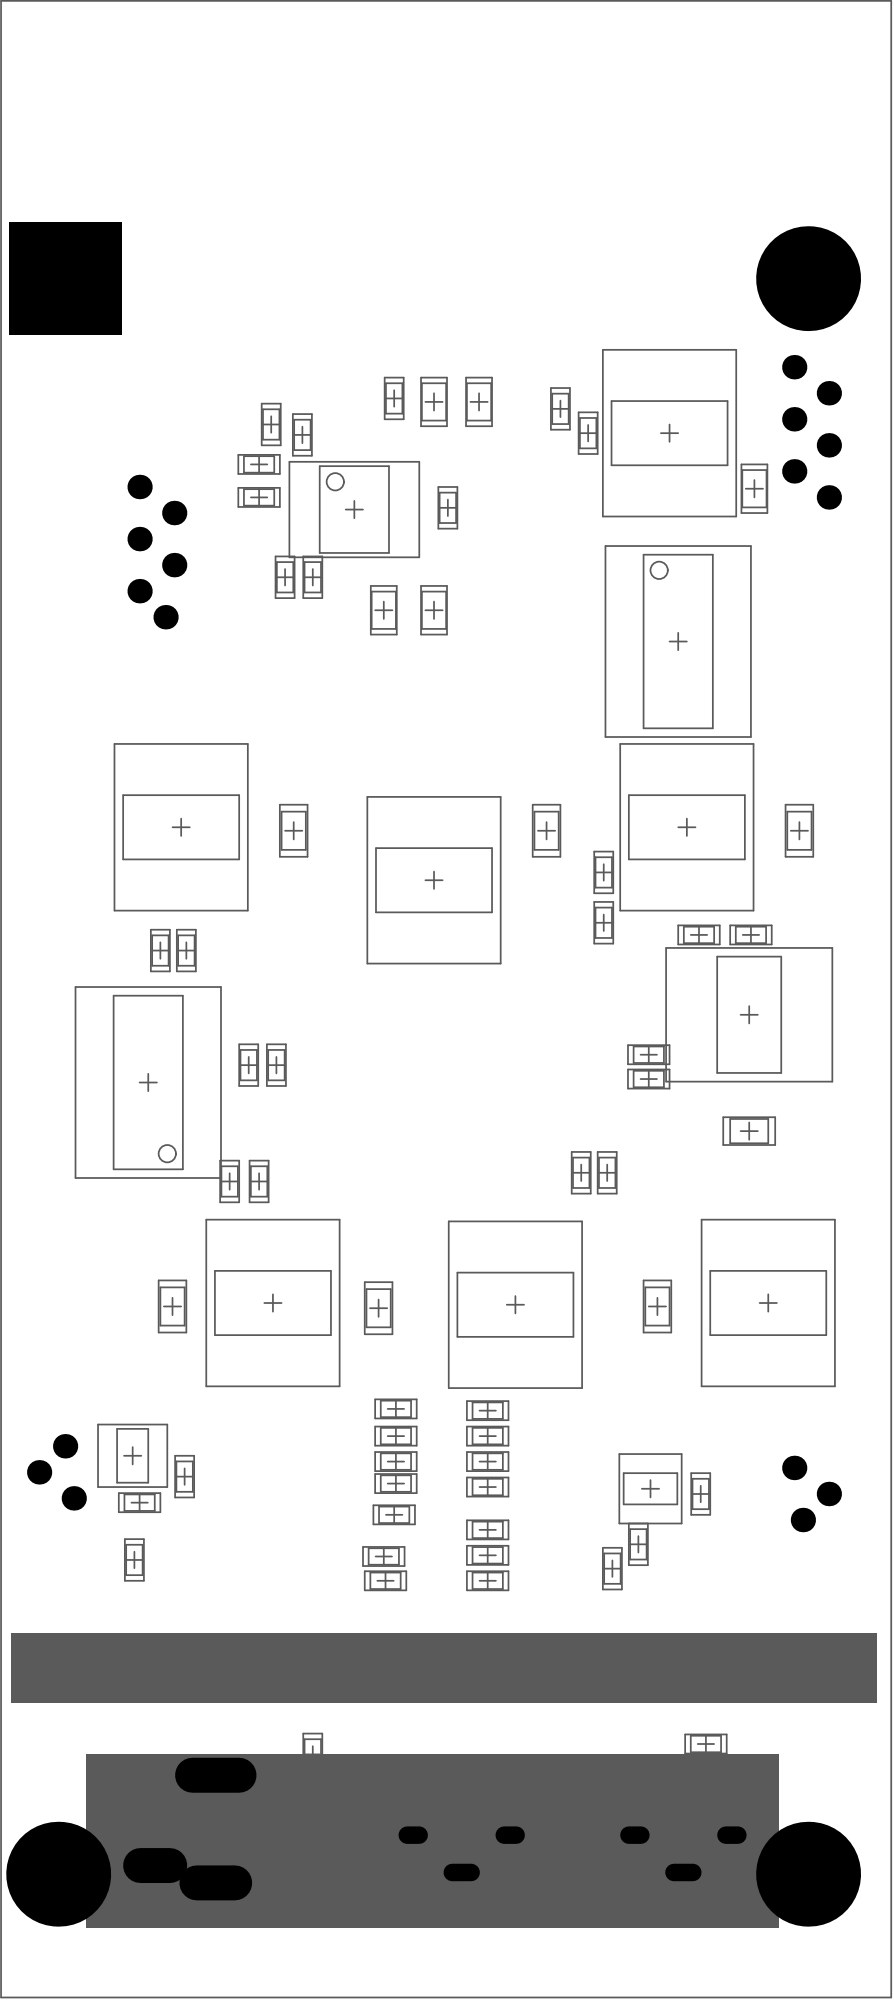
[picture p140: page 12]

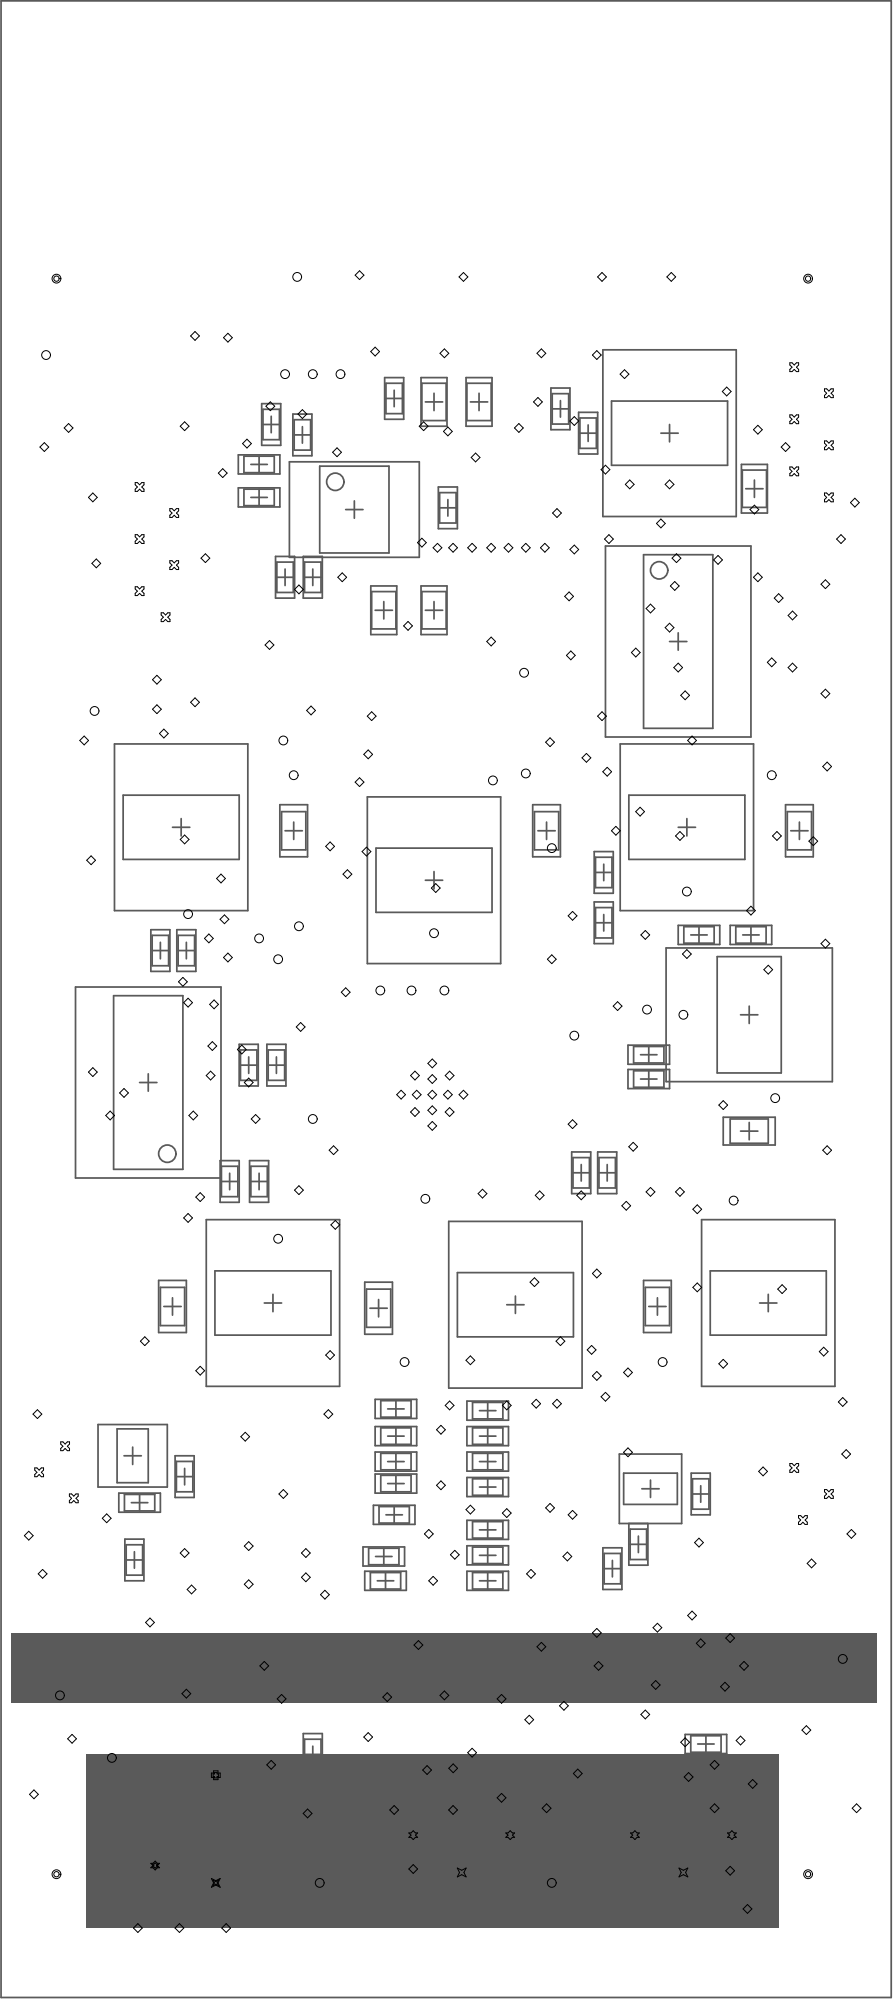
[picture p141: page 13]

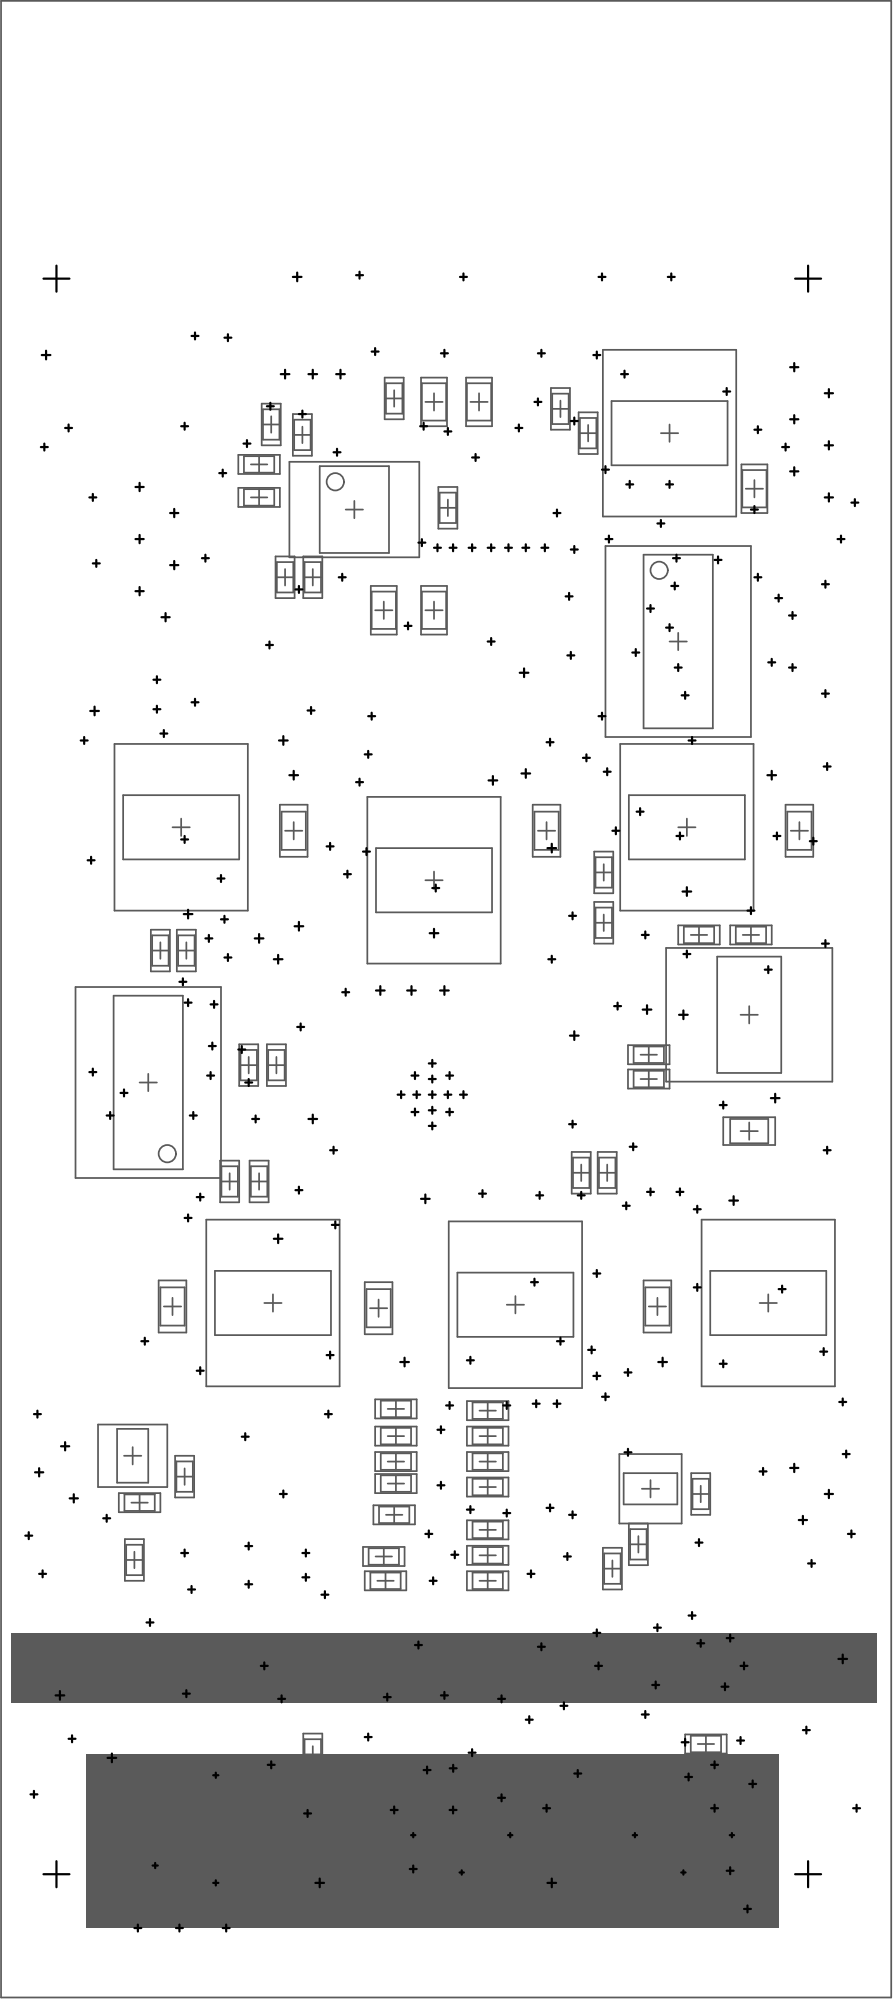
[picture p142: page 14]
