hs280/chiBioAnalogue/hardware/baseline-digital/PCB Files/Assembly PCBs/StructHorizontal/Job1.PDF

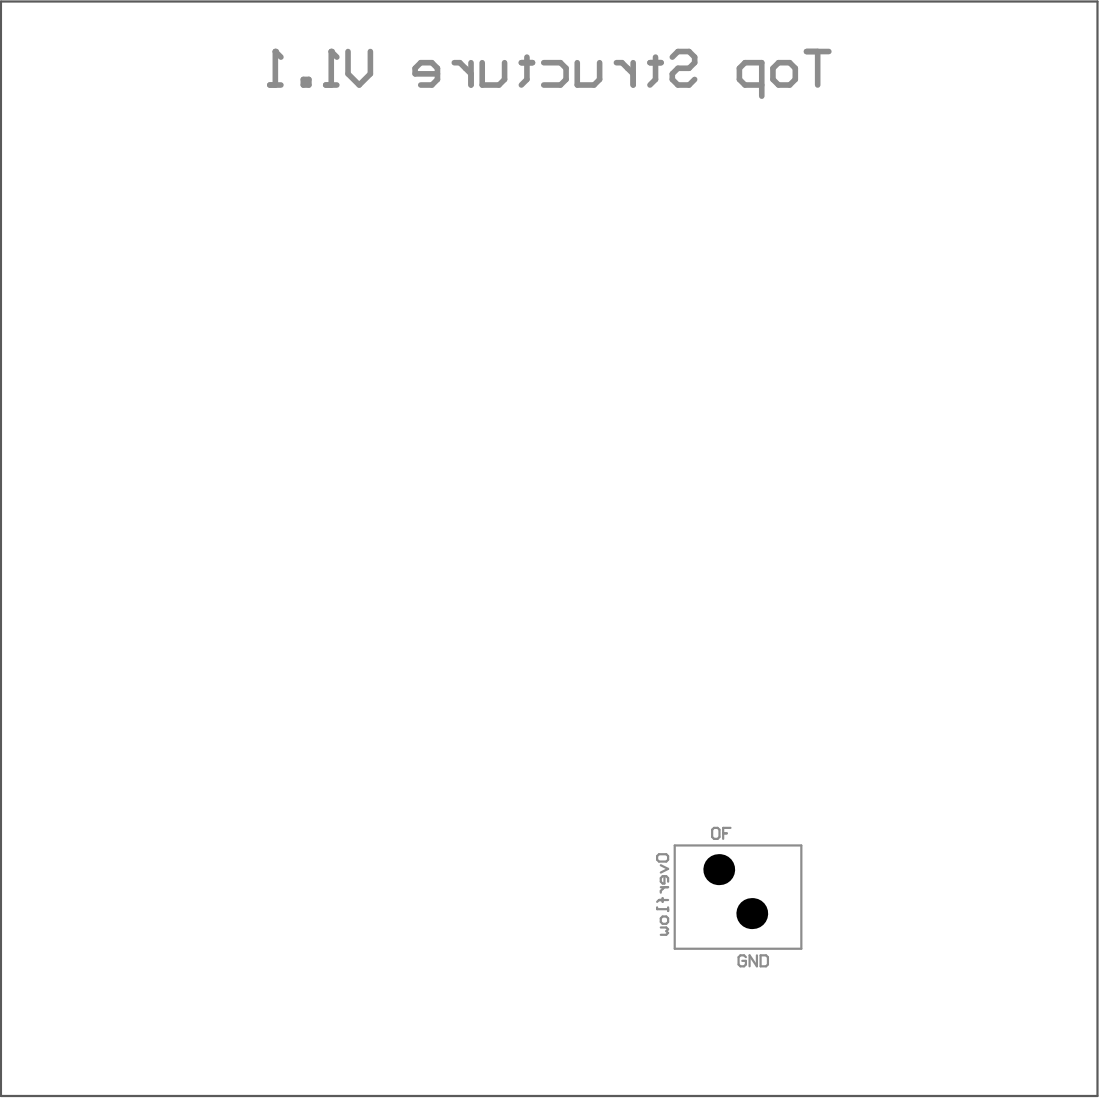
[picture p143: page 2]

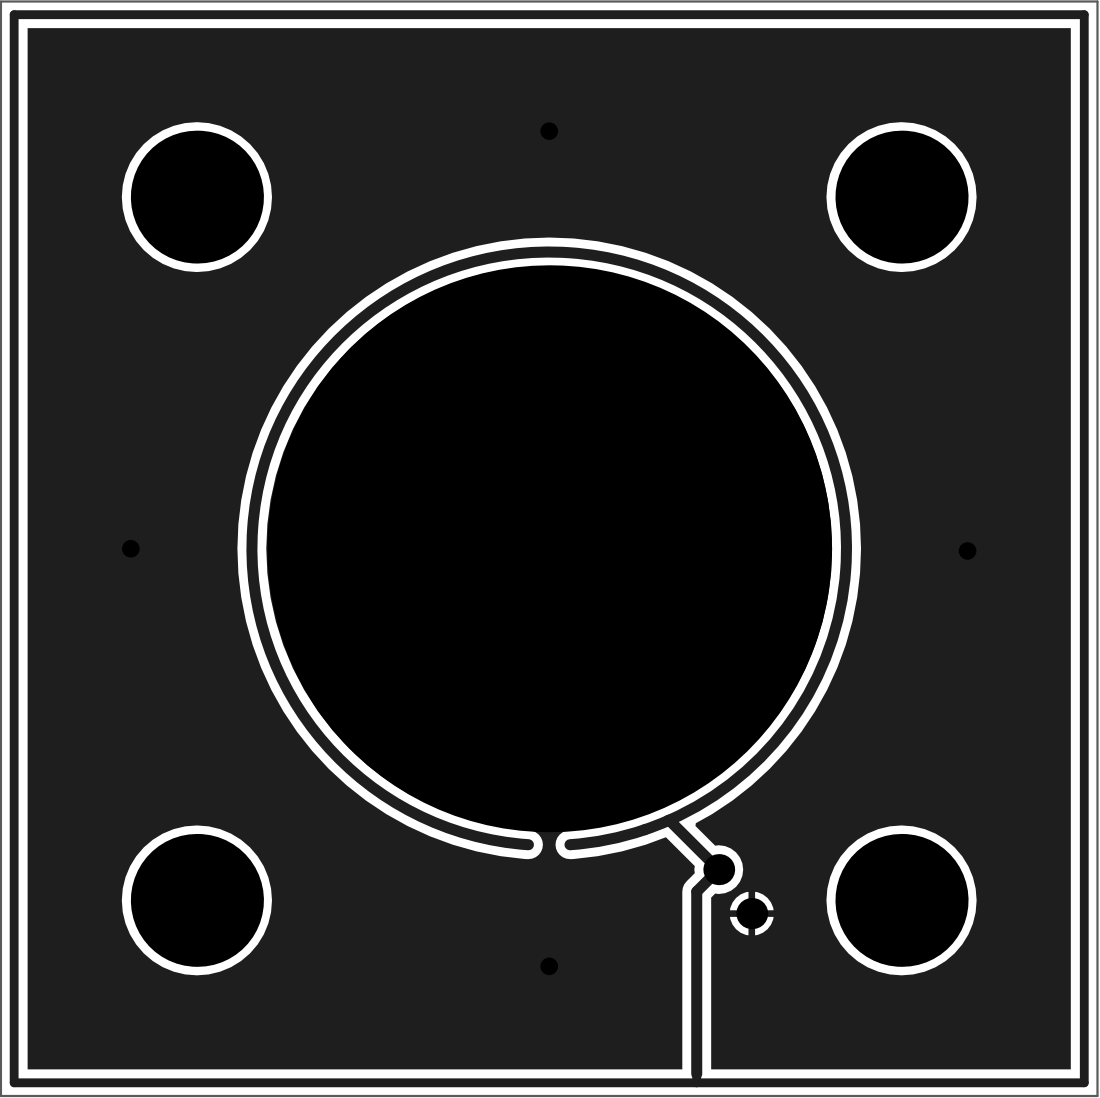
[picture p144: page 3]

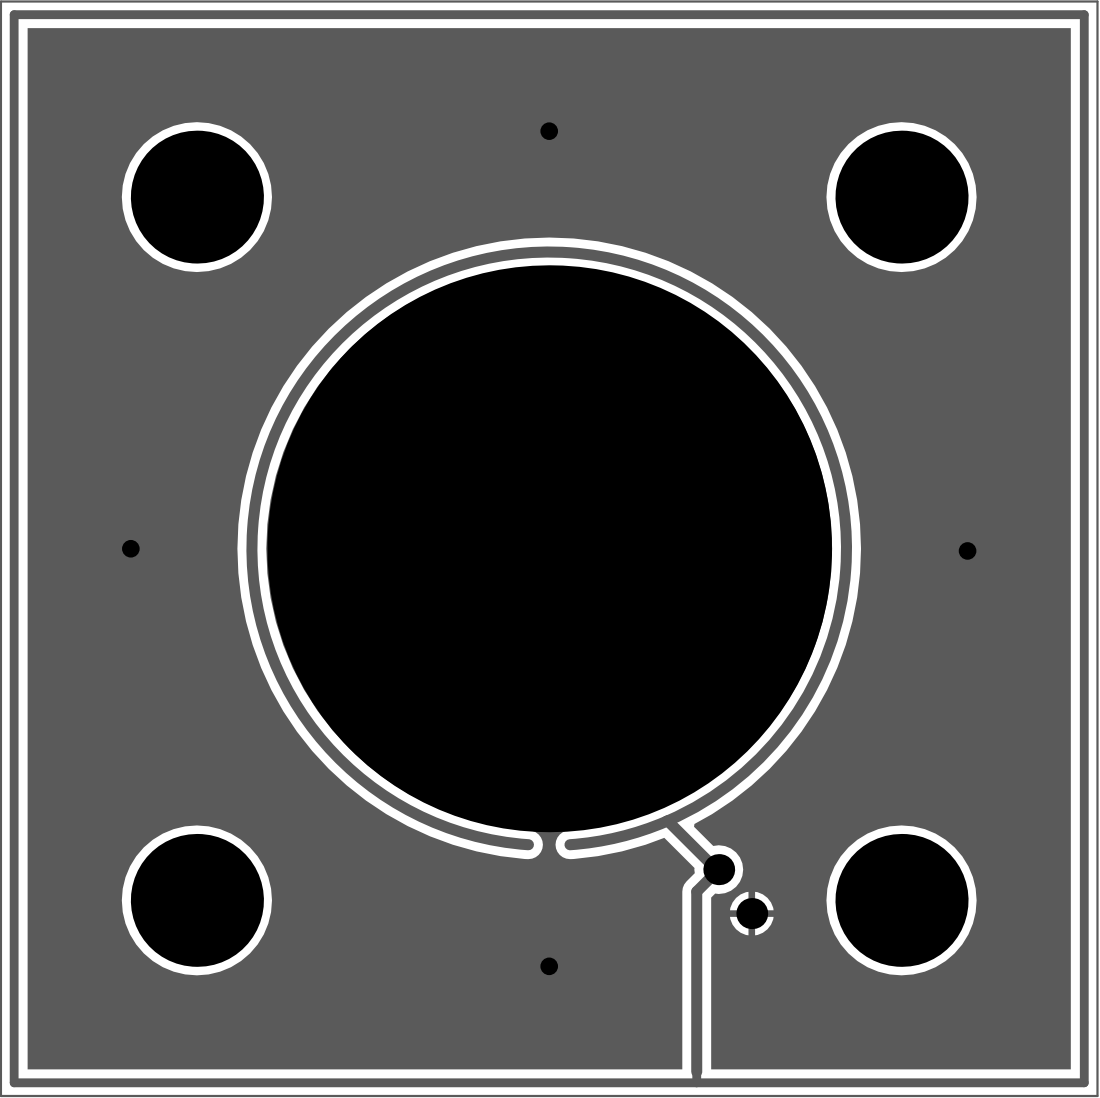
[picture p145: page 4]

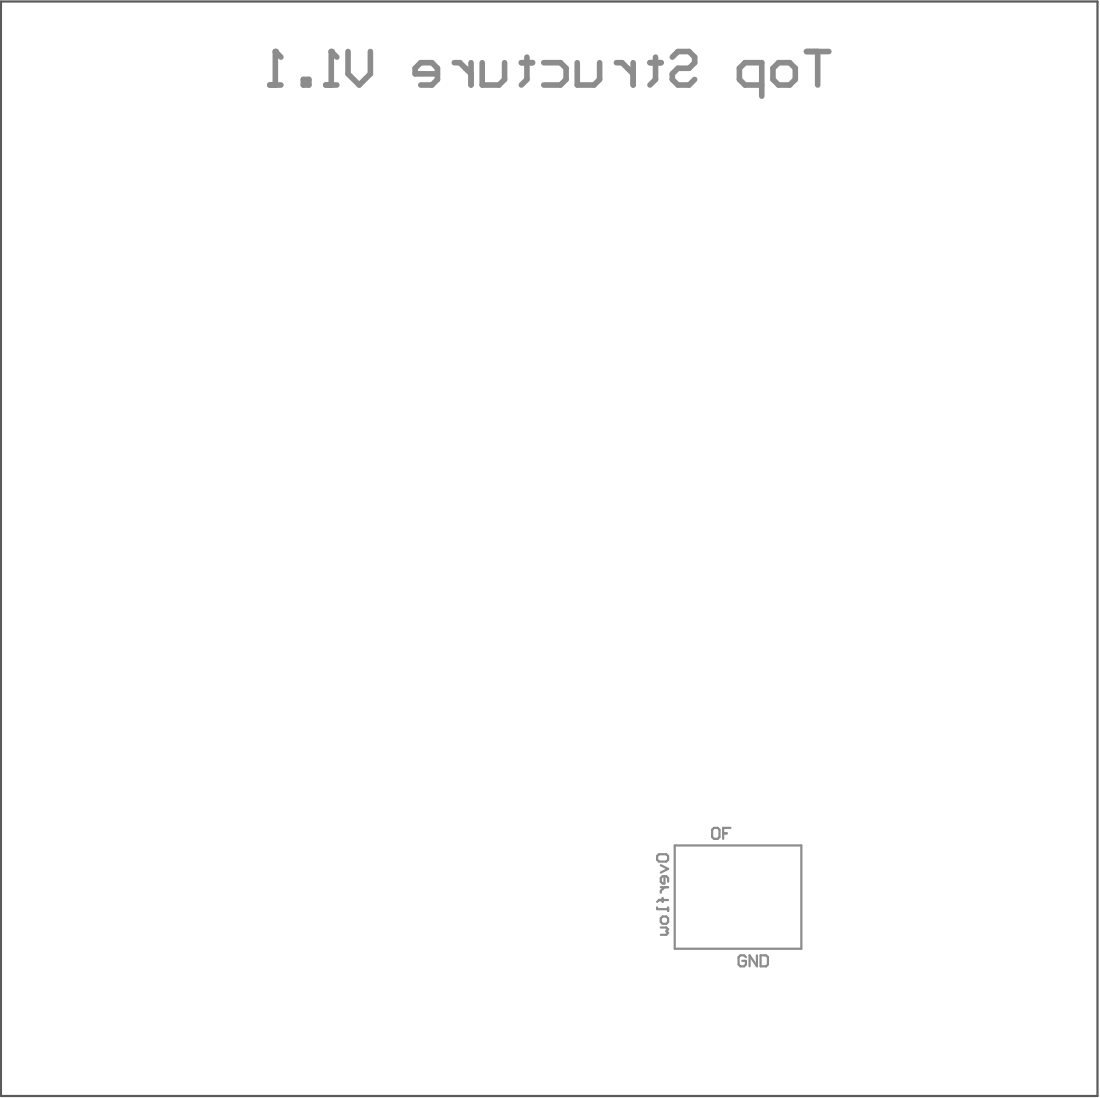
[picture p146: page 6]

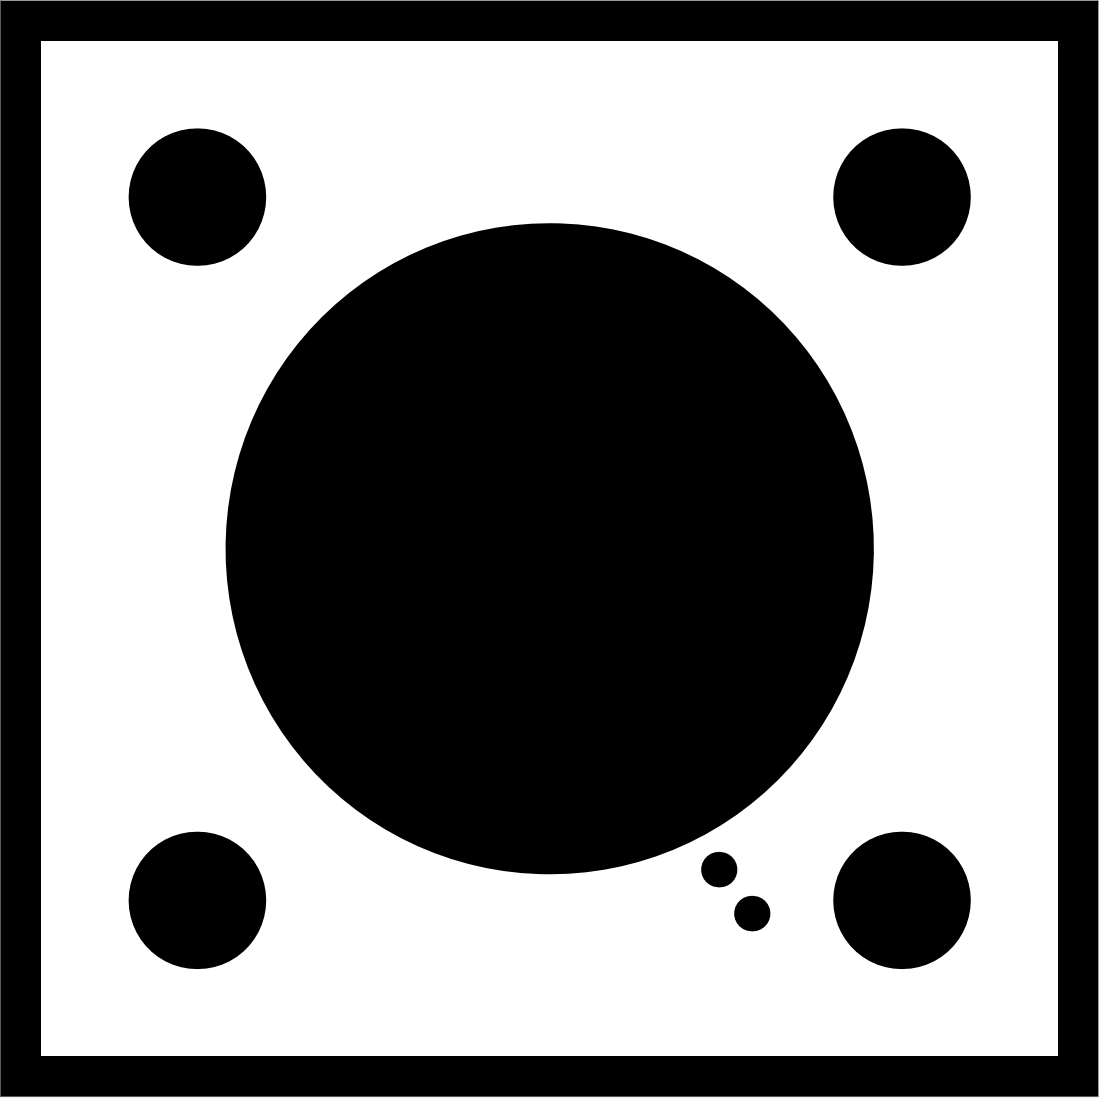
[picture p147: page 7]

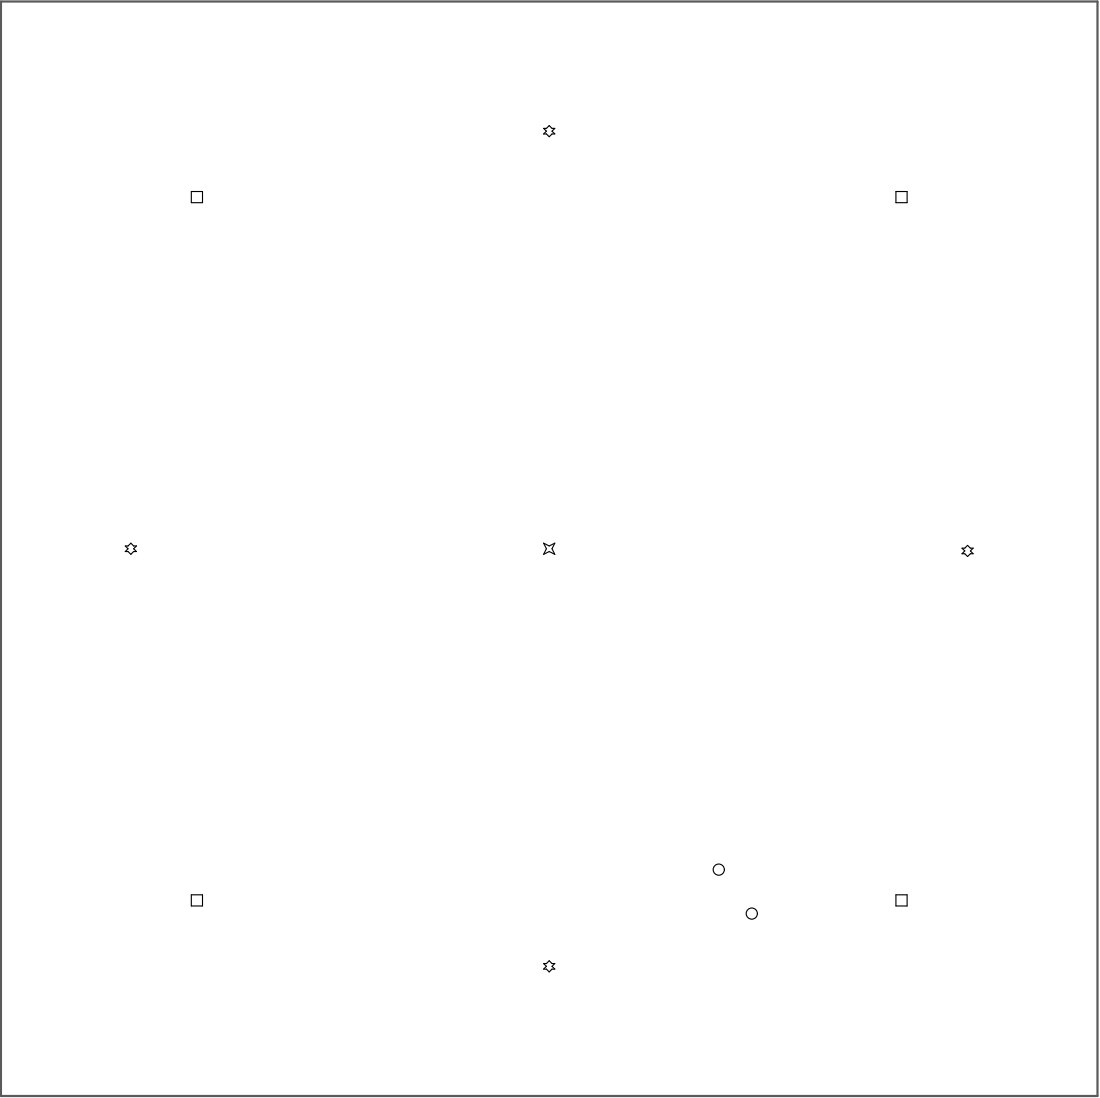
[picture p148: page 13]

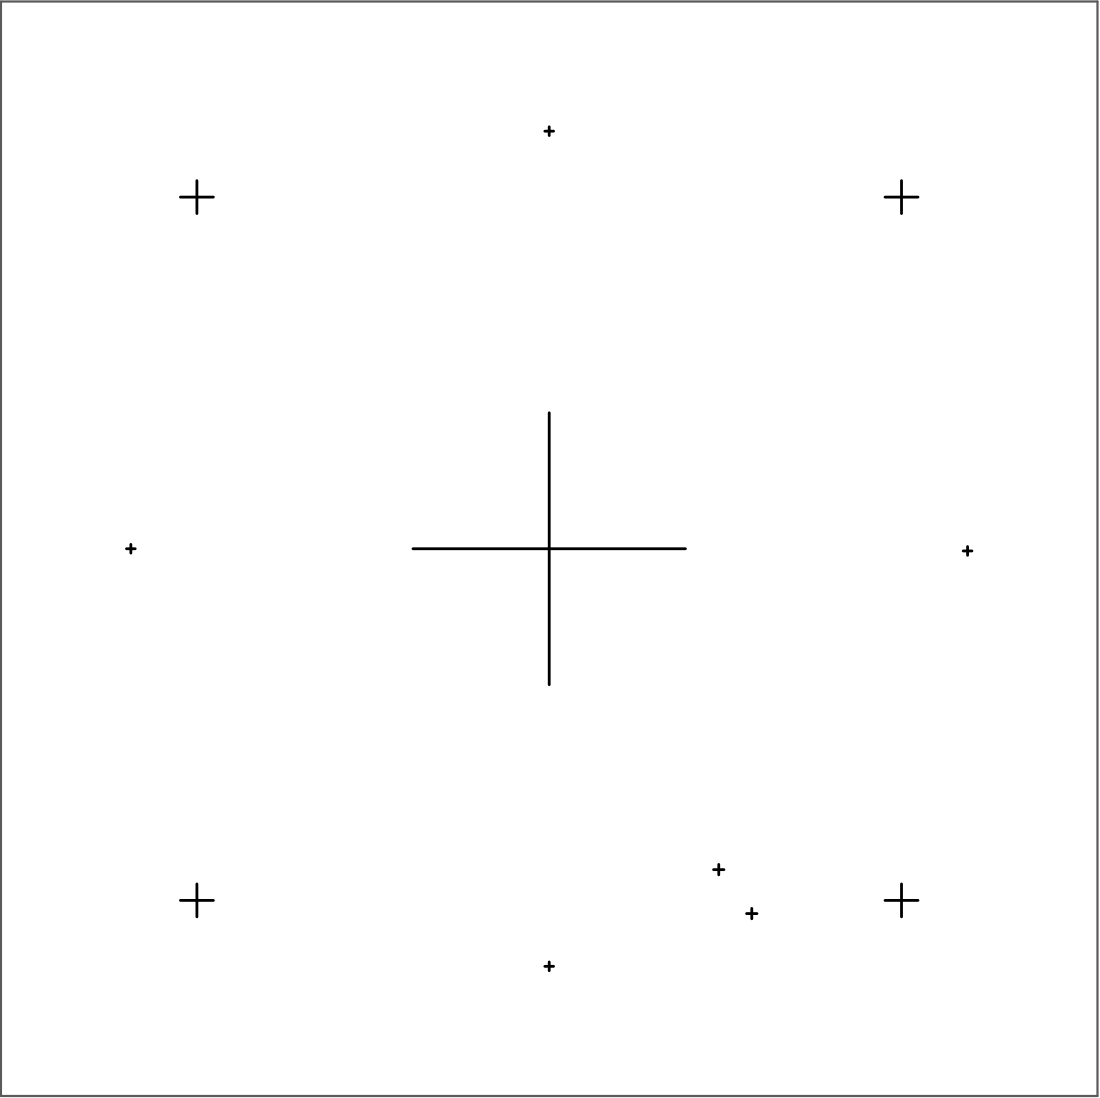
[picture p149: page 14]
