hs280/chiBioAnalogue/(list of files, drawings)

Other design files:
hardware/source-altium/Side.PcbDoc
hardware/source-altium/Side.PrjPcb
hardware/source-altium/Side.SchDoc
