hs280/chiBioAnalogue/hardware/source-altium/Side.imported-from-altium.kicad_pcb

## KiCad design hardware/source-altium/Side.imported-from-altium.kicad_pcb (2026-11-09)

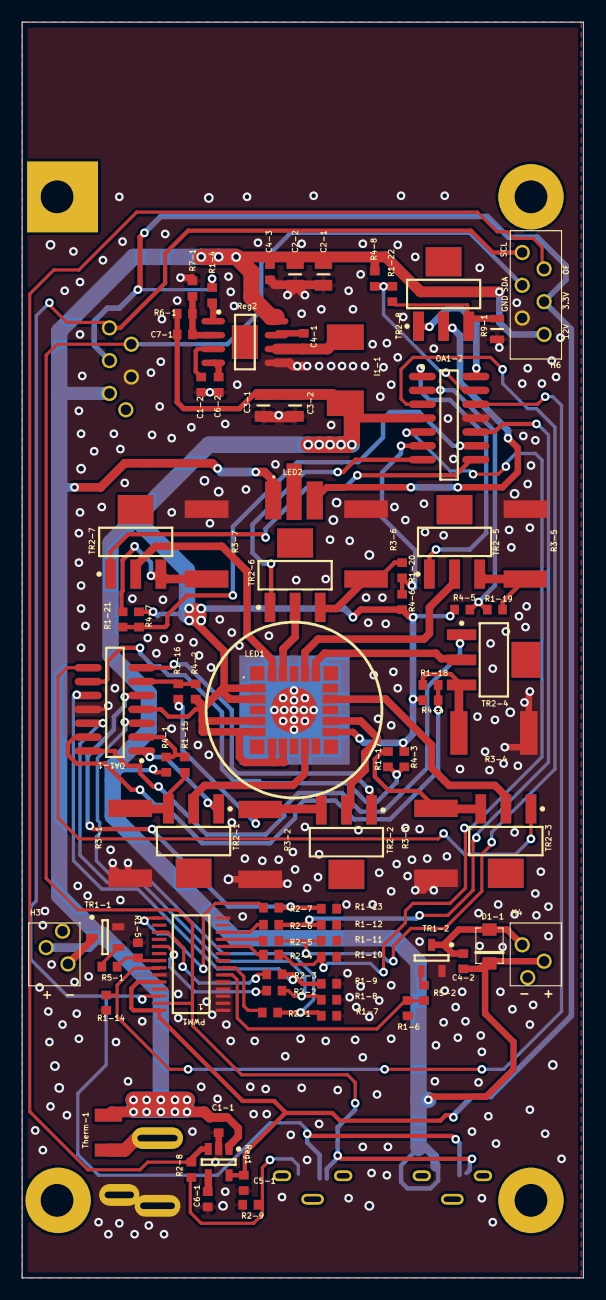
[picture p150: board Side.imported-from-altium.kicad_pcb from above]

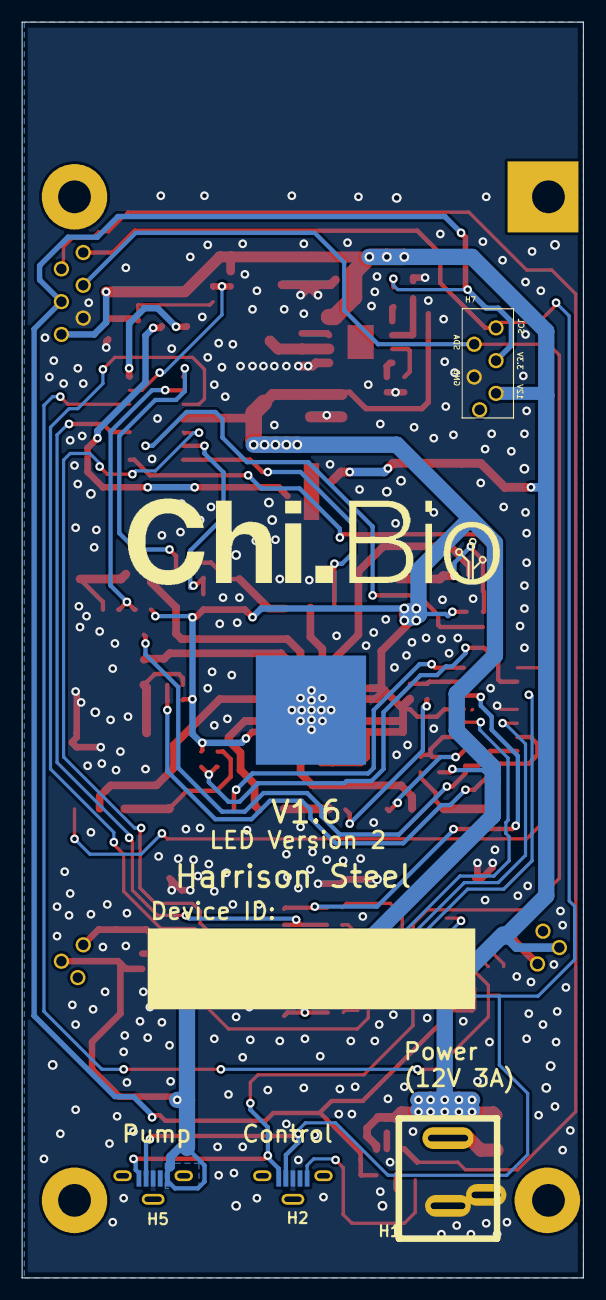
[picture p151: board Side.imported-from-altium.kicad_pcb from below]

Board: 2 copper layers, 51.4 x 115.0 mm, 88 parts (4 on the bottom side), 69 nets.

Parts:
C1-1, C1-2: 1 uF; 1608[0603]
C2-1, C2-2: 10 uF; 0805Large
C3-1, C3-2: 22 uF; 0805Large
C4-1, C4-2, C4-3: 0.1 uF; 1608[0603]
C5-1: 4.7uF; 1608[0603]
C6-1, C6-2: 0.01uF; 1608[0603]
C7-1: 22pF; 1608[0603]
D1-1: D1; SOD 123
H1: Power (12V 3A); PowerJack1
H2: Control; Micro USB
H3: Heat; InterCon2
H4: Stir; InterCon2
H5: Pump; Micro USB
H6: Measurement; Inter Connect 6 - reduced
H7: Expansion; Inter Connect 5
I1-1: 3.3uH; INDUCTOR2
LED1: LEDEngin_V2; LEDENGIN
LED2: LED UV; UV LED
OA1-1, OA1-2: OpAmp 4Way; SOIC14_M
PWM1: PWM28; TSSOP-28
R1-4, R1-5, R1-6, R1-7, R1-8, R1-9, R1-10, R1-11, R1-12, R1-13, R1-14, R1-15, R1-16, R1-17, R1-18, R1-19, R1-20, R1-21, R1-22: 10k; 1608[0603]
R2-1, R2-2, R2-3, R2-4, R2-5, R2-6, R2-7, R2-8, R2-9: 38.3k; 1608[0603]
R3-1, R3-2, R3-3, R3-4, R3-5, R3-6, R3-7: 1; 2512
R4-1, R4-2, R4-3, R4-4, R4-5, R4-6, R4-7, R4-8: 1M; 1608[0603]
R5-1, R5-2: 4.99; 1608[0603]
R6-1: 152k; 1608[0603]
R7-1: 22.1k; 1608[0603]
R9-1: 40.2; 0805
Reg1: 3.3V Regulator; SOT23-5
Reg2: 6V Regulator; 8-SOIC V3
TR1-1, TR1-2: MOSFET; SOT23-3
TR2-1, TR2-2, TR2-3, TR2-4, TR2-5, TR2-6, TR2-7, TR2-8: TransistorPower2; SOT223_M
Therm-1: 10; 1206

Connections:
3.3V: C5-1.1, H6.3, H7.3, PWM1.24, PWM1.28, R1-4.1, Reg1.5
6V: C3-1.2, C3-2.2, C4-2.1, C7-1.2, D1-1.1, H4.1, H5.5, I1-1.2, LED1.2, LED1.3, LED1.5, LED1.6, LED1.8, LED1.9, LED1.14, OA1-1.4, OA1-2.4, R4-1.1, R4-2.1, R4-3.1, R4-4.1, R4-5.1, R4-6.1, R4-7.1, R6-1.1
12VRaw: C1-1.1, C2-1.2, C2-2.2, C4-3.1, H3.1, H6.1, H7.1, LED2.2, R4-8.1, Reg1.1, Reg2.8, Therm-1.2
Blue: LED1.23, TR2-6.2
Blue0: PWM1.10, R2-4.2
Blue1: OA1-2.5, R1-10.2, R2-4.1
Cyan: LED1.11, TR2-1.2
Cyan0: PWM1.7, R2-1.2
Cyan1: OA1-1.3, R1-7.2, R2-1.1
Enable: H2.5, R2-8.1, R2-9.2
GND: C1-1.2, C1-2.2, C2-1.1, C2-2.1, C3-1.1, C3-2.1, C4-3.2, C5-1.2, C6-1.1, C6-2.2, H1.2, H1.3, H2.3, H5.3, H6.2, H7.2, OA1-1.11, OA1-2.11, PWM1.1, PWM1.2, PWM1.3, PWM1.4, PWM1.5, PWM1.14, PWM1.23, PWM1.25, R1-5.1, R1-6.1, R1-7.1, R1-8.1, R1-9.1, R1-10.1, R1-11.1, R1-12.1, R1-13.1, R1-14.1, R2-9.1, R3-1.1, R3-2.1, R3-3.1, R3-4.1, R3-5.1, R3-6.1, R3-7.1, R7-1.1, R9-1.1, Reg1.2, Reg2.5, TR1-1.2, TR1-2.2
Green: LED1.21, TR2-5.2
Green0: PWM1.11, R2-5.2
Green1: OA1-2.3, R1-11.2, R2-5.1
Lime1: LED1.20, TR2-4.2
Lime2: LED1.17, TR2-3.2
Lime10: PWM1.19, R2-2.2
Lime11: OA1-1.12, R1-8.2, R2-2.1
Lime20: PWM1.17, R2-3.2
Lime22: OA1-1.10, R1-9.2, R2-3.1
NetC1-2_1: C1-2.1, Reg2.3
NetC4-1_1: C4-1.1, I1-1.1, Reg2.6
NetC4-1_2: C4-1.2, Reg2.7
NetC4-2_2: C4-2.2, D1-1.2, H4.2, TR1-2.3
NetC6-1_2: C6-1.2, Reg1.4
NetC6-2_1: C6-2.1, Reg2.4
NetC7-1_1: C7-1.1, R6-1.2, R7-1.2, Reg2.2
NetH1_1: H1.1, Therm-1.1
NetH3_2: H3.2, TR1-1.3
NetLED2_1: LED2.1, TR2-8.2
NetOA1-1_1: OA1-1.1, TR2-1.1
NetOA1-1_2: OA1-1.2, R1-15.1, R4-1.2
NetOA1-1_6: OA1-1.6, R1-16.1, R4-2.2
NetOA1-1_7: OA1-1.7, TR2-2.1
NetOA1-1_8: OA1-1.8, TR2-3.1
NetOA1-1_9: OA1-1.9, R1-17.1, R4-3.2
NetOA1-1_13: OA1-1.13, R1-18.1, R4-4.2
NetOA1-1_14: OA1-1.14, TR2-4.1
NetOA1-2_1: OA1-2.1, TR2-5.1
NetOA1-2_2: OA1-2.2, R1-19.1, R4-5.2
NetOA1-2_6: OA1-2.6, R1-20.1, R4-6.2
NetOA1-2_7: OA1-2.7, TR2-6.1
NetOA1-2_8: OA1-2.8, TR2-7.1
NetOA1-2_9: OA1-2.9, R1-21.1, R4-7.2
NetOA1-2_12: OA1-2.12, PWM1.22, R1-14.2
NetOA1-2_13: OA1-2.13, R1-22.2, R4-8.2
NetOA1-2_14: OA1-2.14, TR2-8.1
NetPWM1_6: PWM1.6, R1-6.2, R5-2.1
NetPWM1_21: PWM1.21, R1-5.2, R5-1.1
NetR1-4_2: R1-4.2, Reg2.1
NetR1-15_2: R1-15.2, R3-1.2, TR2-1.3
NetR1-16_2: R1-16.2, R3-2.2, TR2-2.3
NetR1-17_2: R1-17.2, R3-3.2, TR2-3.3
NetR1-18_2: R1-18.2, R3-4.2, TR2-4.3
NetR1-19_2: R1-19.2, R3-5.2, TR2-5.3
NetR1-20_2: R1-20.2, R3-6.2, TR2-6.3
NetR1-21_2: R1-21.2, R3-7.2, TR2-7.3
NetR1-22_1: R1-22.1, R9-1.2, TR2-8.3
NetR5-1_2: R5-1.2, TR1-1.1
NetR5-2_2: R5-2.2, TR1-2.1
Overflow: H6.5, R2-8.2, Reg1.3
Red: LED1.24, TR2-7.2
Red0: PWM1.12, R2-6.2
Red1: OA1-2.10, R1-12.2, R2-6.1
SCL: H2.2, H5.2, H6.6, H7.5, PWM1.26
SDA: H2.1, H5.1, H6.4, H7.4, PWM1.27
Yellow: LED1.15, TR2-2.2
Yellow0: PWM1.15, R2-7.2
Yellow1: OA1-1.5, R1-13.2, R2-7.1
