hs280/chiBioAnalogue/(commit log)

2026-11-05 Add analogue-LED (CCR) Chi.Bio variant: firmware, design doc, BOM delta, tests
    Claude-Session: https://claude.ai/code/session_01JmDwFKXuDMhY2Y8jkywzJg
    [Additional Materials.xlsx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]
2026-11-09 Match analogue LED design to the real Side board schematic
    Add Altium sources received from the Chi.Bio authors, a KiCad import of the PCB,
    and tools that extract the schematic netlist (cross-checked against the PCB: all
    69 multi-pin nets match). The real circuit needs one 8-channel DAC, not two; the
    UV stage is already a CCR; each CCR has a built-in dead zone that the firmware
    now compensates for. Rewrite the design doc, BOM delta and tests accordingly.
    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
    [Side.PcbDoc, Side.PrjPcb, Side.SchDoc, Side.imported-from-altium.kicad_pcb, side_board_bom_delta.csv, side_board_netlist.csv]
